xdmattz/kicad-library/3d/t_connectors/MBITR_BATT_CONN_ASM.STEP

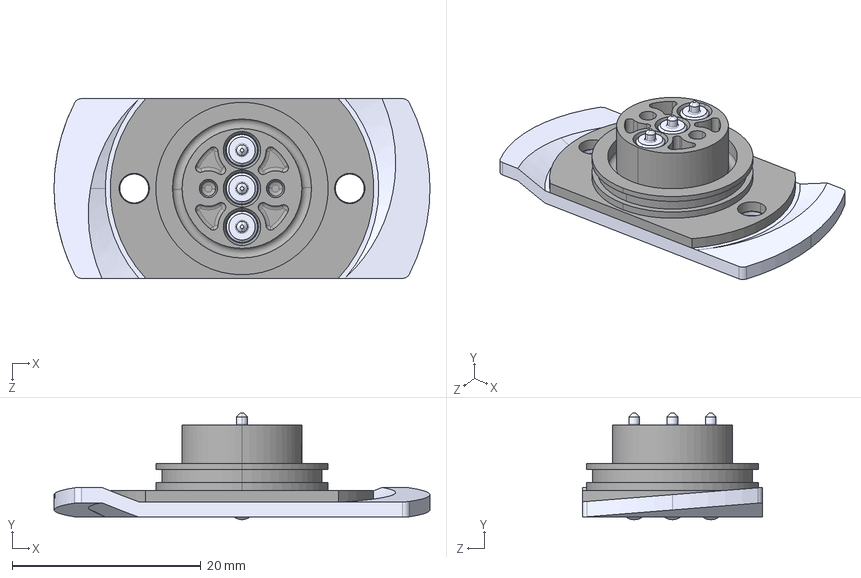
[picture p1: CAD file, 2024-04-17]
3d/t_connectors/MBITR_BATT_CONN_ASM.STEP
39.9 x 11.3 x 19.1 mm
