xdmattz/kicad-library/3d/t_Phoenix/RA_Full_Connector_4.step

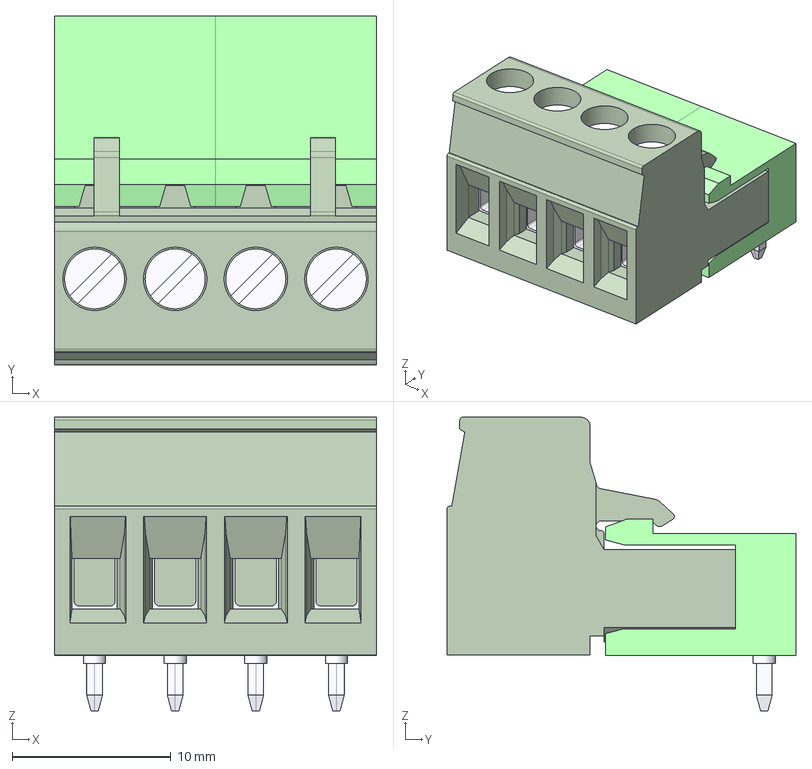
[picture p2: CAD file, 2024-04-17]
3d/t_Phoenix/RA_Full_Connector_4.step
20.3 x 22.0 x 18.5 mm
mstb_2.5-2-g-5
mstb_2.5-2-g-5 (1)
PG145699
