xdmattz/kicad-library/3d/t_BGA/LTM8055Y.STEP

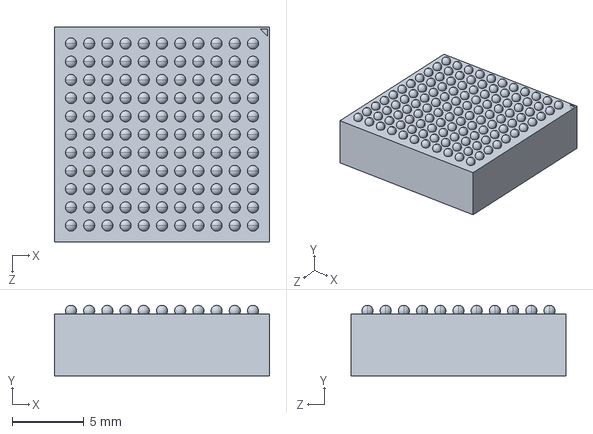
[picture p3: CAD file, 2024-04-17]
3d/t_BGA/LTM8055Y.STEP
15.0 x 4.92 x 15.0 mm
