xdmattz/kicad-library/3d/t_coilcraft/Coilcraft-LPS4414.STEP

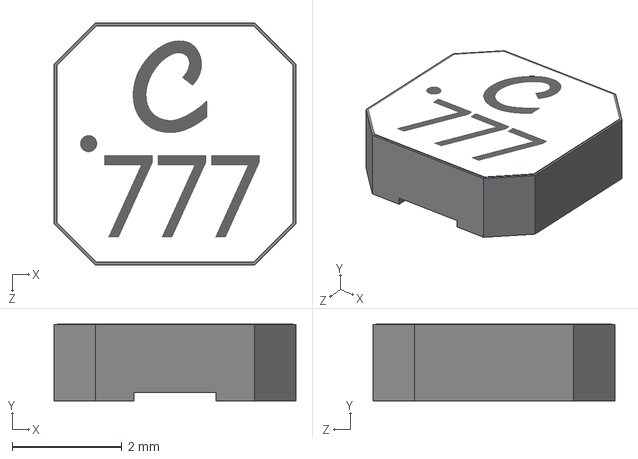
[picture p4: CAD file, 2024-04-17]
3d/t_coilcraft/Coilcraft-LPS4414.STEP
4.40 x 1.40 x 4.40 mm
