xdmattz/kicad-library/3d/t_crystal/7W_TXC.STEP

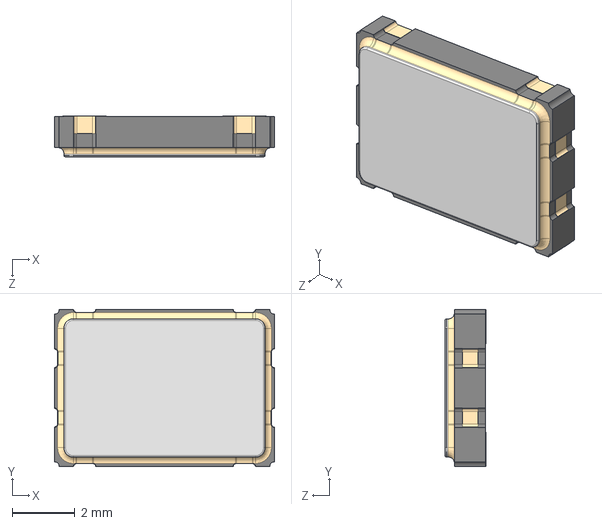
[picture p5: CAD file, 2024-04-17]
3d/t_crystal/7W_TXC.STEP
7.00 x 5.00 x 1.30 mm
