xdmattz/kicad-library/3d/t_Cypress/Cy8CProto_062_4343W Pins.step

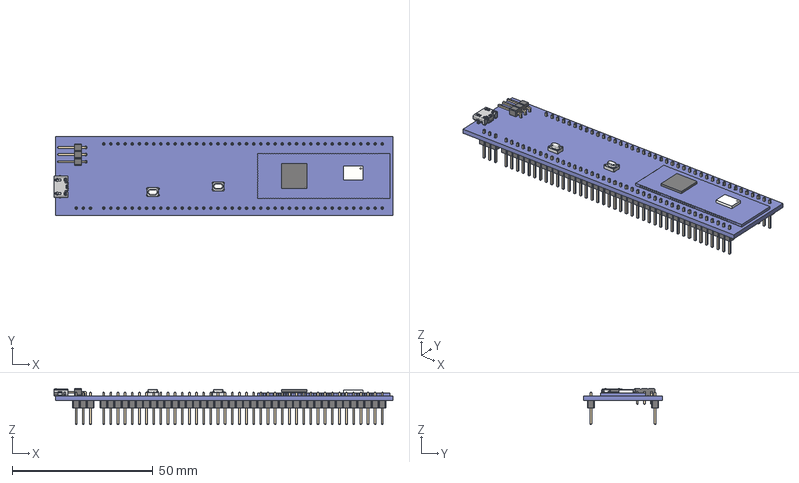
[picture p6: CAD file, 2024-04-17]
3d/t_Cypress/Cy8CProto_062_4343W Pins.step
120.5 x 27.9 x 12.9 mm
Tactile_Switch_3_2x4_2 v2 x 2
