xdmattz/kicad-library/3d/t_dip/MUA08A.stp

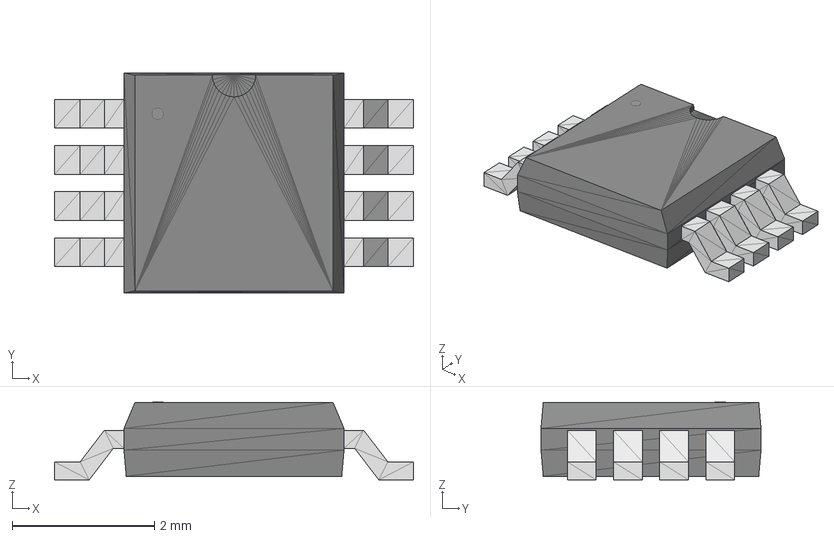
[picture p7: CAD file, 2024-04-17]
3d/t_dip/MUA08A.stp
5.05 x 3.10 x 1.09 mm
