xdmattz/kicad-library/3d/t_do/SMA Package.step

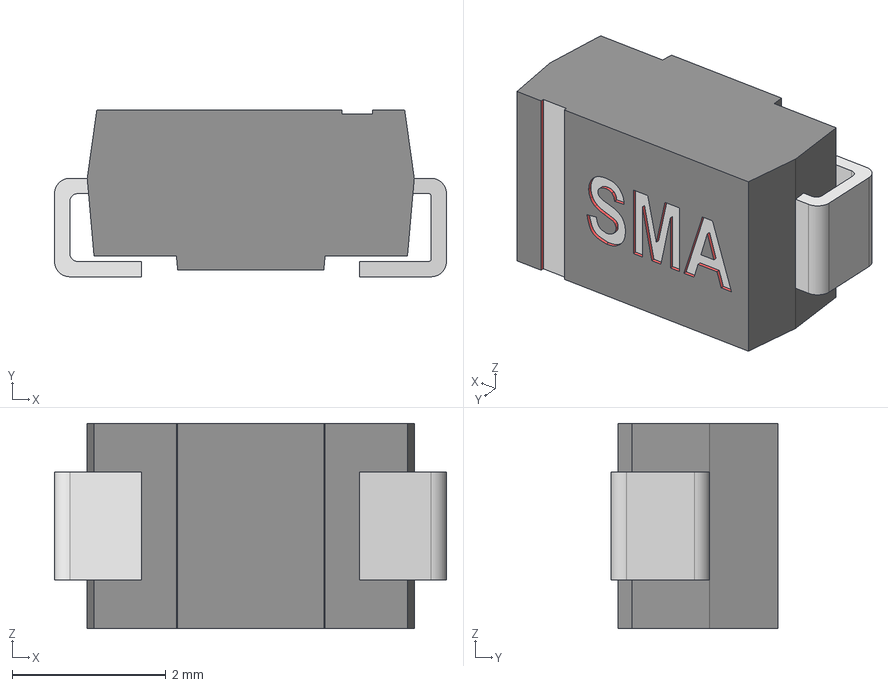
[picture p8: CAD file, 2024-04-17]
3d/t_do/SMA Package.step
5.09 x 2.17 x 2.67 mm
