xdmattz/kicad-library/3d/t_EPC_eGaN/EPC2088 v2.step

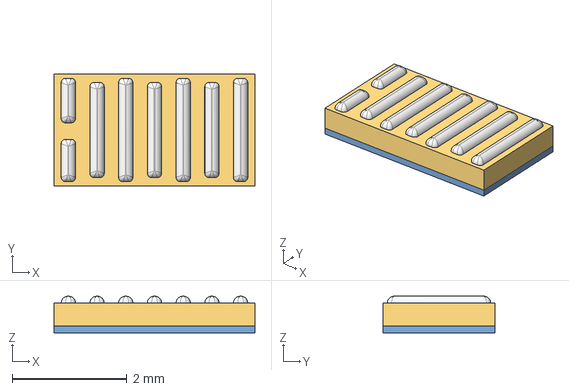
[picture p9: CAD file, 2024-04-17]
3d/t_EPC_eGaN/EPC2088 v2.step
3.50 x 1.95 x 0.638 mm
