xdmattz/kicad-library/3d/t_fuses/PTC_OZCF.step

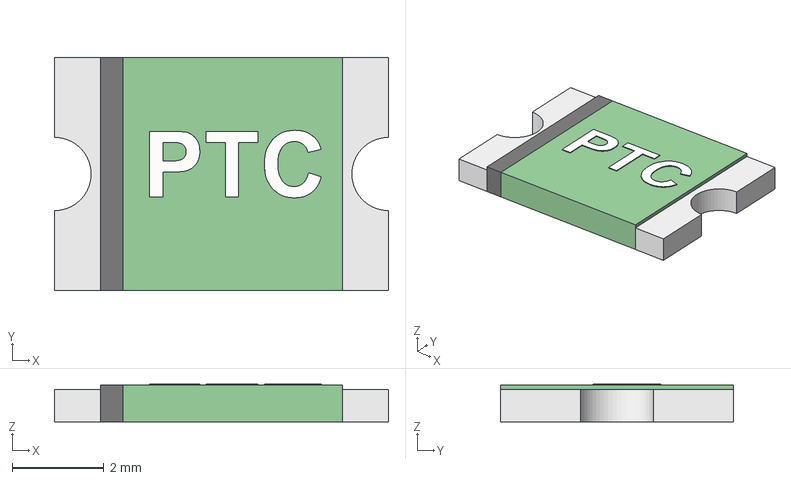
[picture p10: CAD file, 2024-04-17]
3d/t_fuses/PTC_OZCF.step
7.30 x 5.10 x 0.82 mm
