xdmattz/kicad-library/3d/t_header/2.54mm/DS1022-2x2RF11.stp

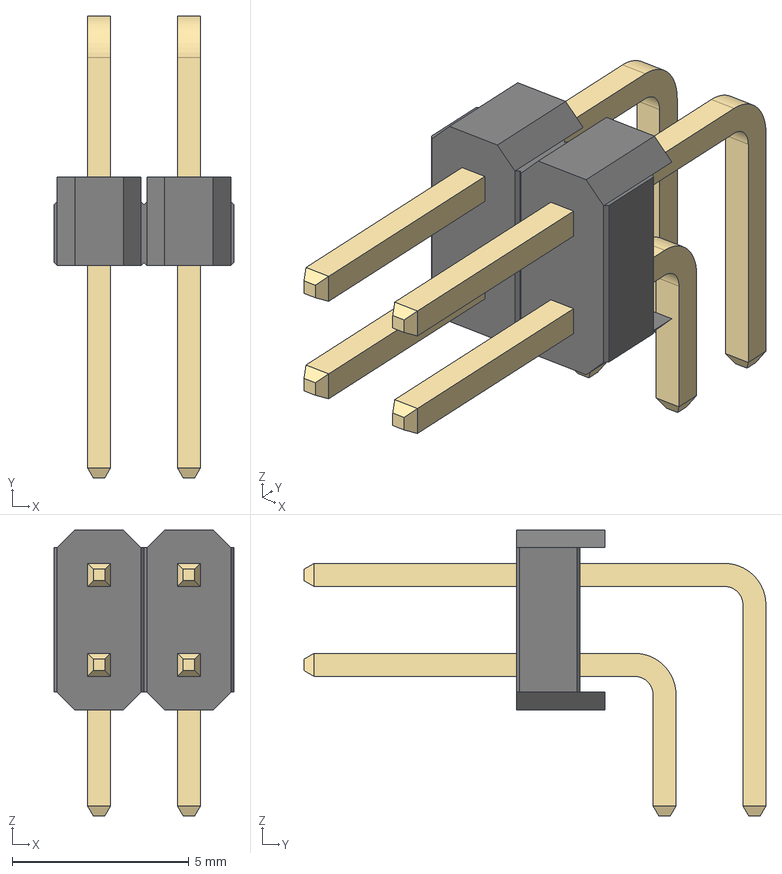
[picture p12: CAD file, 2024-04-17]
3d/t_header/2.54mm/DS1022-2x2RF11.stp
5.08 x 13.1 x 8.08 mm
