xdmattz/kicad-library/3d/t_passive_smd/CP_EIA-7343-31_Kemet-D.step

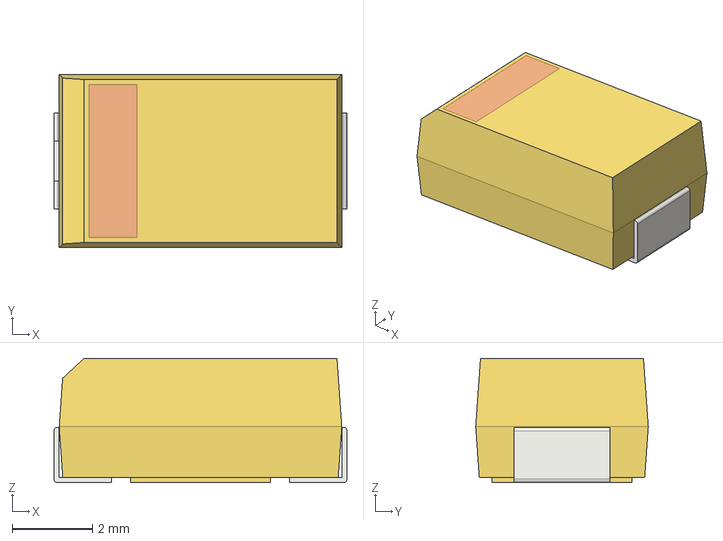
[picture p13: CAD file, 2024-04-17]
3d/t_passive_smd/CP_EIA-7343-31_Kemet-D.step
7.30 x 4.30 x 3.10 mm
