xdmattz/kicad-library/3d/t_passive_thd/RES-1W-HH-MO.stp

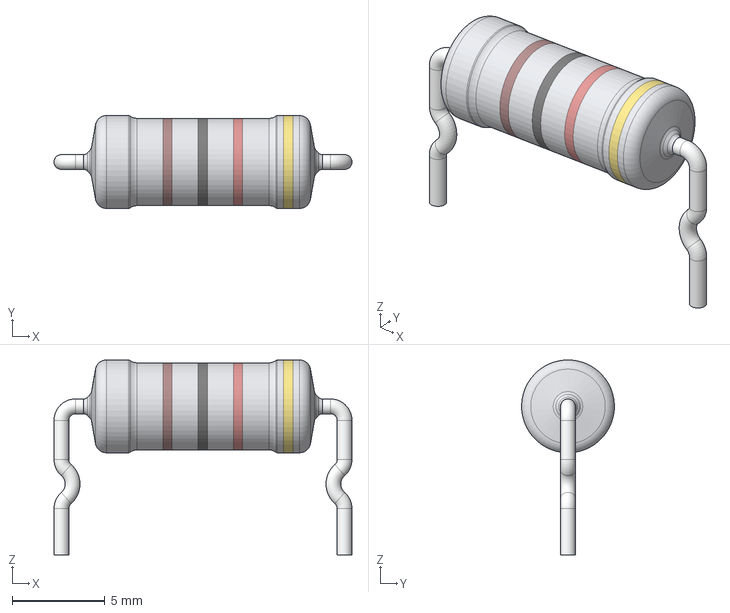
[picture p14: CAD file, 2024-04-17]
3d/t_passive_thd/RES-1W-HH-MO.stp
16.0 x 5.00 x 10.5 mm
