xdmattz/kicad-library/3d/t_Phoenix/Terminal Block Vert_Socket_4.step

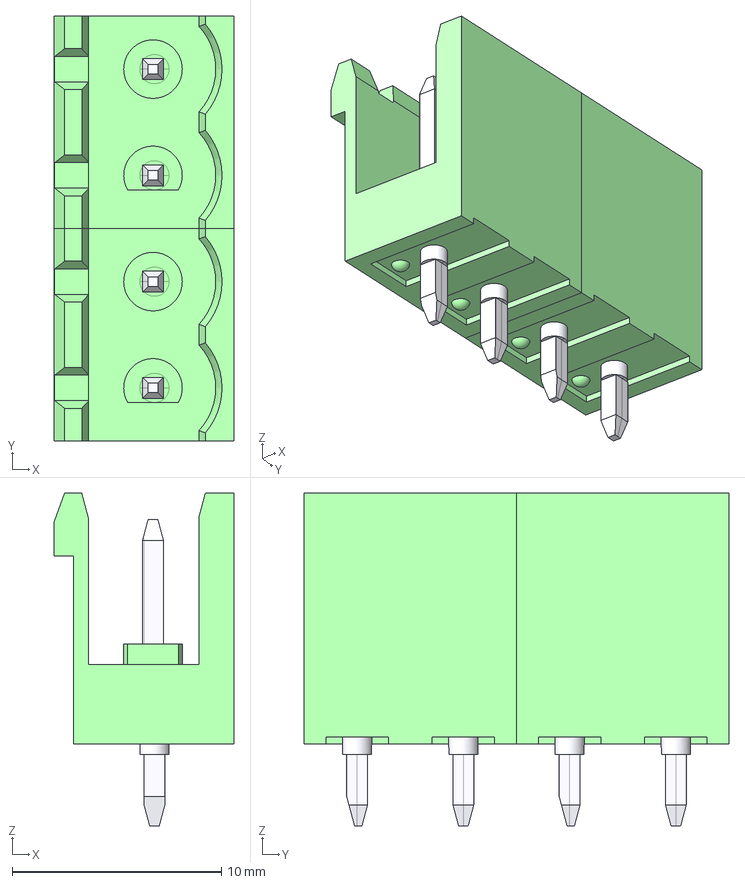
[picture p15: CAD file, 2024-04-17]
3d/t_Phoenix/Terminal Block Vert_Socket_4.step
8.60 x 20.3 x 15.9 mm
mstbv_2.5-2-g-5
mstbv_2.5-2-g-5 (1)
