xdmattz/kicad-library/3d/t_Pot/Pot_B10K_Horiz.step

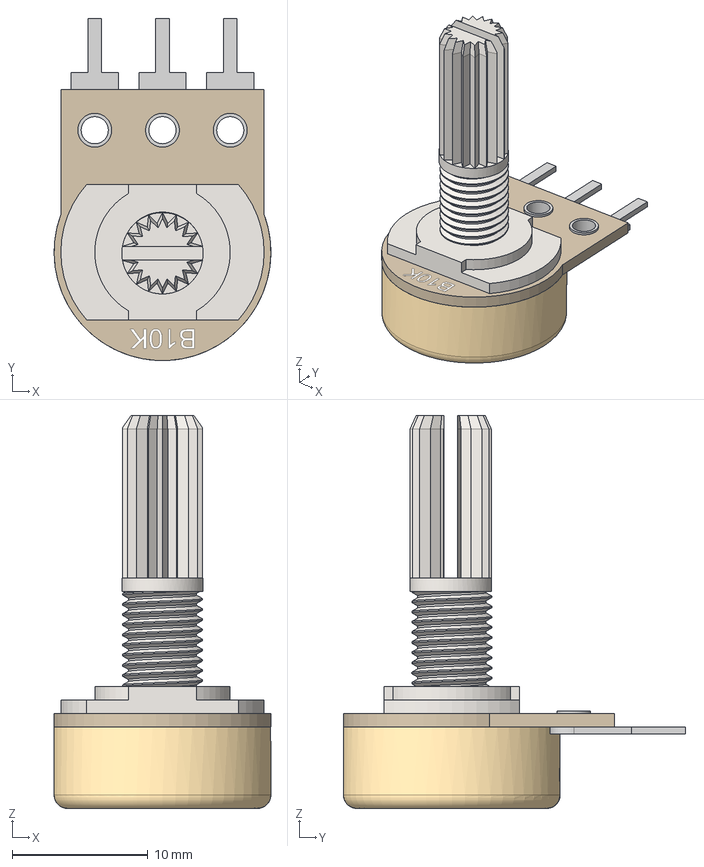
[picture p16: CAD file, 2024-04-17]
3d/t_Pot/Pot_B10K_Horiz.step
16.0 x 25.3 x 29.0 mm
Shaft
ScrewBase
Board
Pin1
Pin2
Pin3
Casing
