xdmattz/kicad-library/3d/t_qfn/CP_32_11_ADI.step

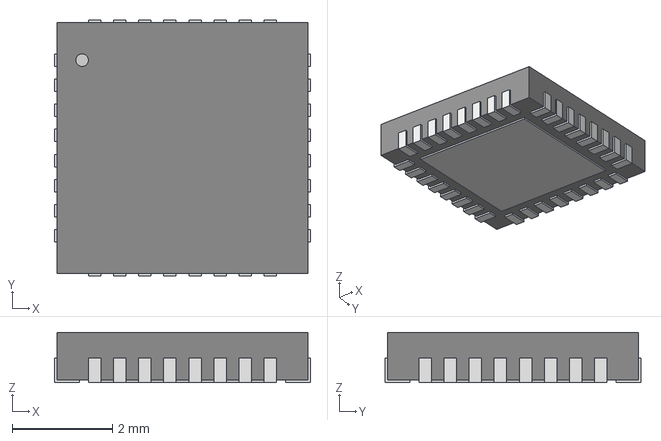
[picture p17: CAD file, 2024-04-17]
3d/t_qfn/CP_32_11_ADI.step
5.10 x 5.10 x 1.00 mm
