xdmattz/kicad-library/3d/t_Relay/OACM-UJ v3.step

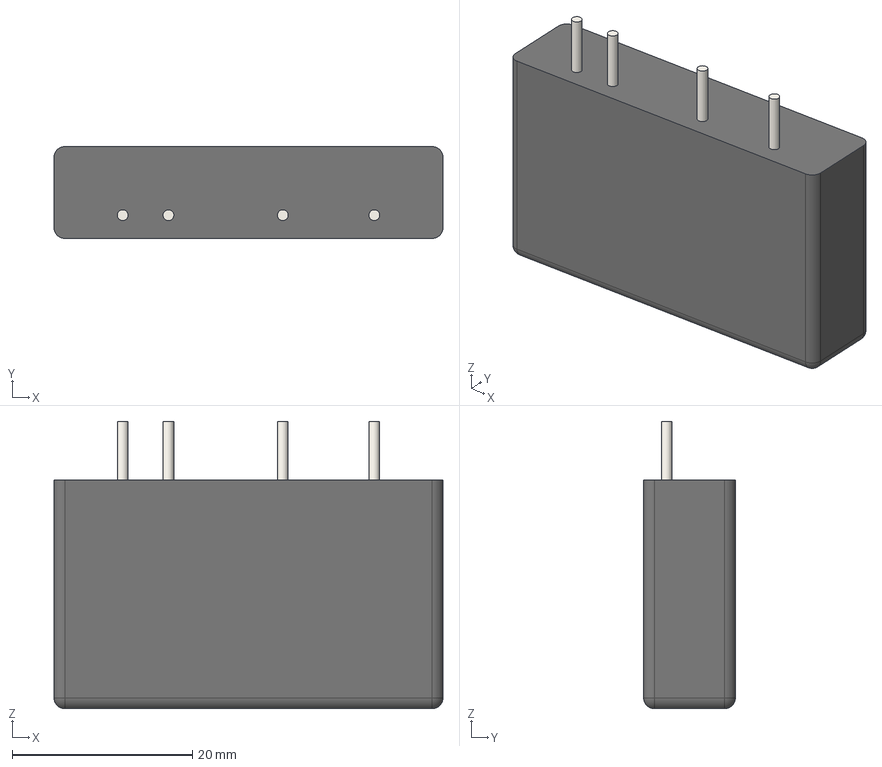
[picture p18: CAD file, 2024-04-17]
3d/t_Relay/OACM-UJ v3.step
43.2 x 10.2 x 31.9 mm
