xdmattz/kicad-library/3d/t_RF_amps/WW107 v4.stp

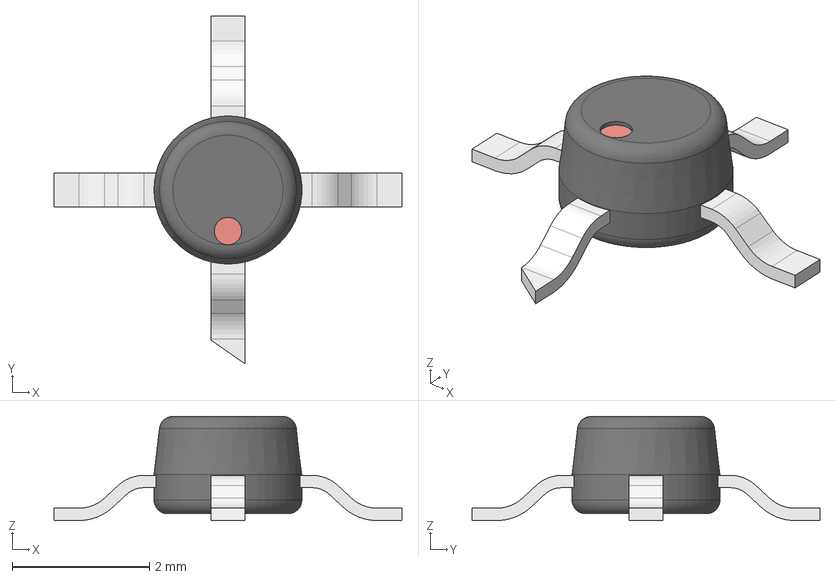
[picture p19: CAD file, 2024-04-17]
3d/t_RF_amps/WW107 v4.stp
5.08 x 5.08 x 1.52 mm
