xdmattz/kicad-library/3d/t_RF_conn/c-5-1814832-2-c-3d.stp

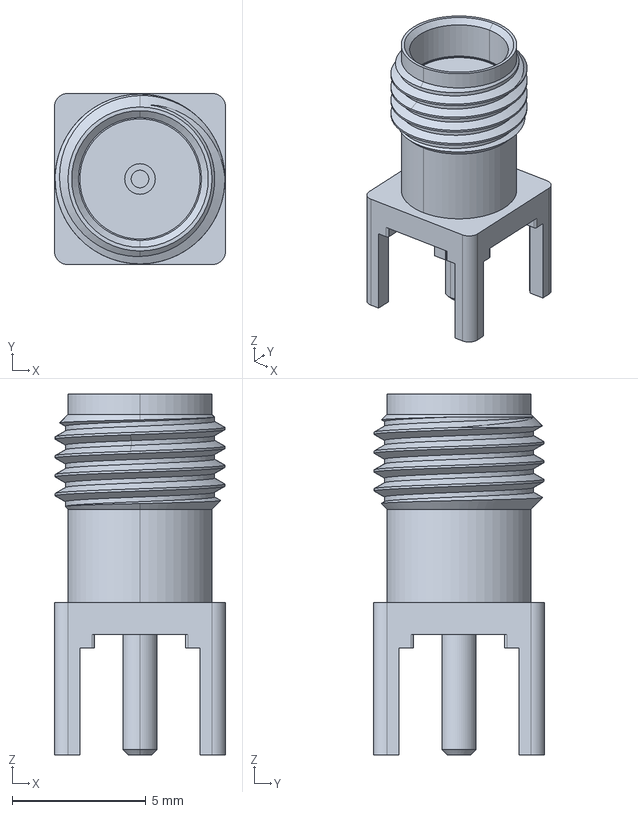
[picture p20: CAD file, 2024-04-17]
3d/t_RF_conn/c-5-1814832-2-c-3d.stp
6.40 x 6.40 x 13.5 mm
