xdmattz/kicad-library/3d/t_RF_misc/PAT1220.stp

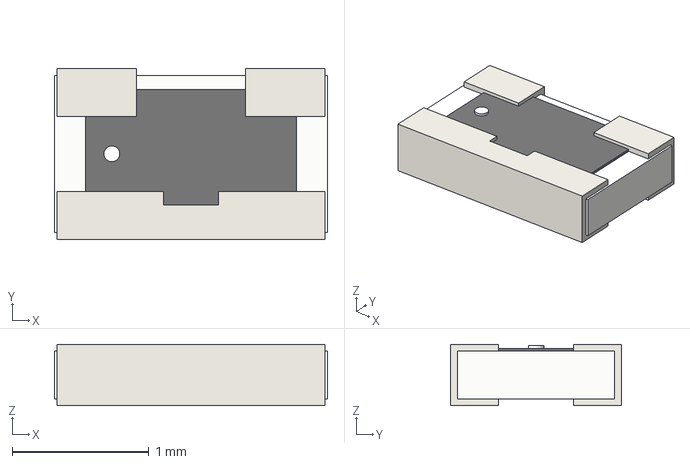
[picture p21: CAD file, 2024-04-17]
3d/t_RF_misc/PAT1220.stp
2.00 x 1.25 x 0.45 mm
