xdmattz/kicad-library/3d/t_Samtec/SSW-103-01-F-D.stp

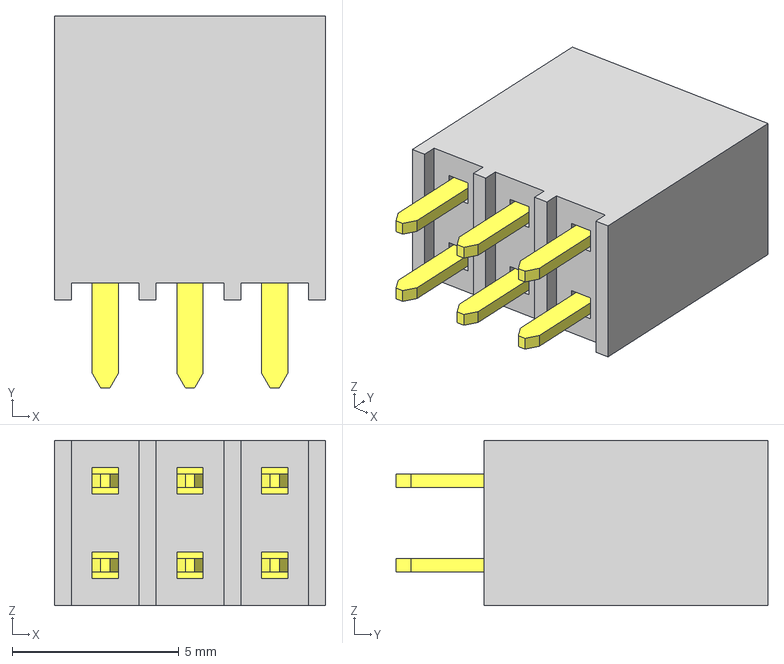
[picture p22: CAD file, 2024-04-17]
3d/t_Samtec/SSW-103-01-F-D.stp
8.13 x 11.2 x 4.95 mm
_SSW-103-01-F-D_terminal
_SSW-103-01-F-D_pin
