xdmattz/kicad-library/3d/t_smd_caps/CP_Elec_5x5.8.step

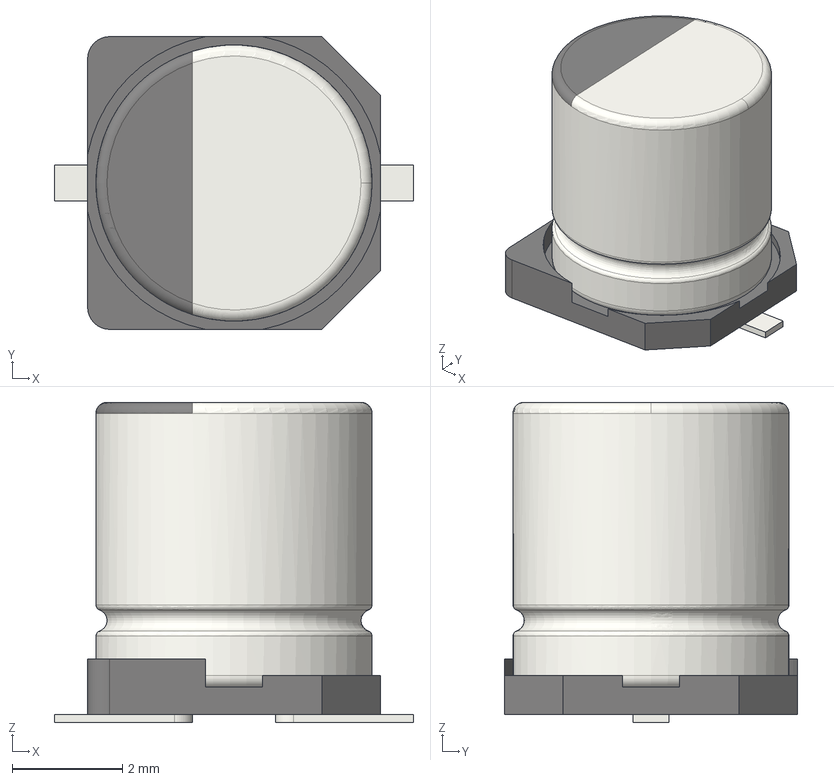
[picture p23: CAD file, 2024-04-17]
3d/t_smd_caps/CP_Elec_5x5.8.step
6.50 x 5.30 x 5.80 mm
