xdmattz/kicad-library/3d/t_smd_inductors/STEP-WE-PD-1280-rev1.stp

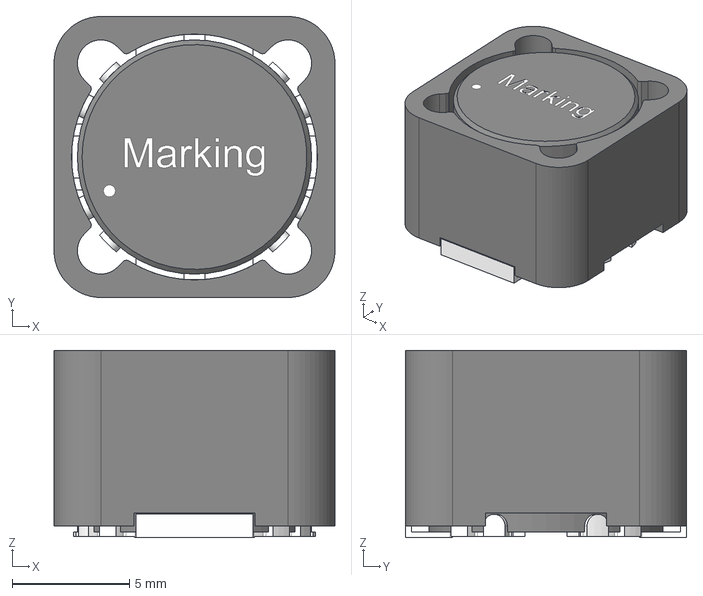
[picture p24: CAD file, 2024-04-17]
3d/t_smd_inductors/STEP-WE-PD-1280-rev1.stp
12.0 x 12.0 x 8.00 mm
