xdmattz/kicad-library/3d/t_smd_transistors/TDFN-8-EP_3x3mm.stp

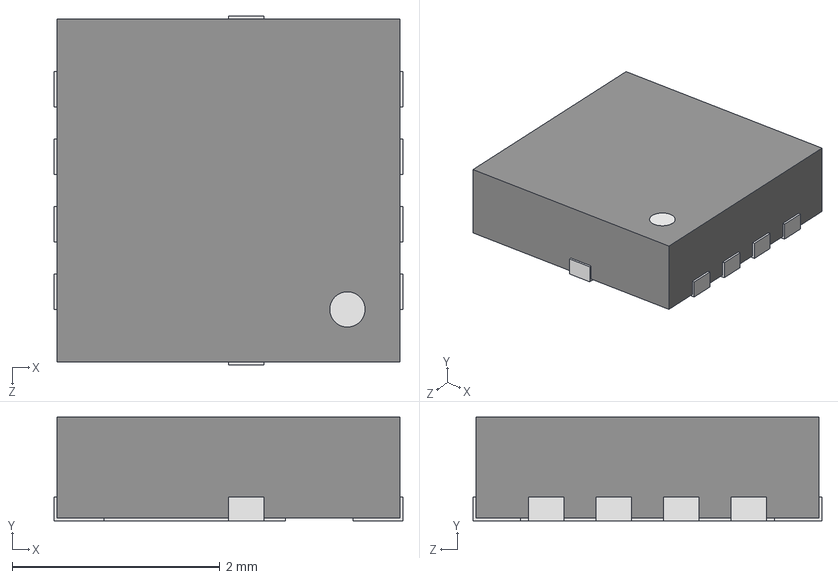
[picture p25: CAD file, 2024-04-17]
3d/t_smd_transistors/TDFN-8-EP_3x3mm.stp
3.36 x 1.00 x 3.36 mm
