xdmattz/kicad-library/3d/t_so/SOIC-16-3_9mm.step

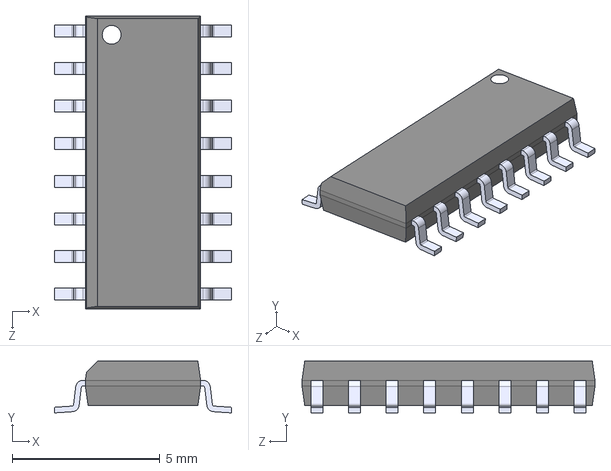
[picture p26: CAD file, 2024-04-17]
3d/t_so/SOIC-16-3_9mm.step
5.99 x 1.75 x 9.91 mm
