xdmattz/kicad-library/3d/t_sot/SOT-223.stp

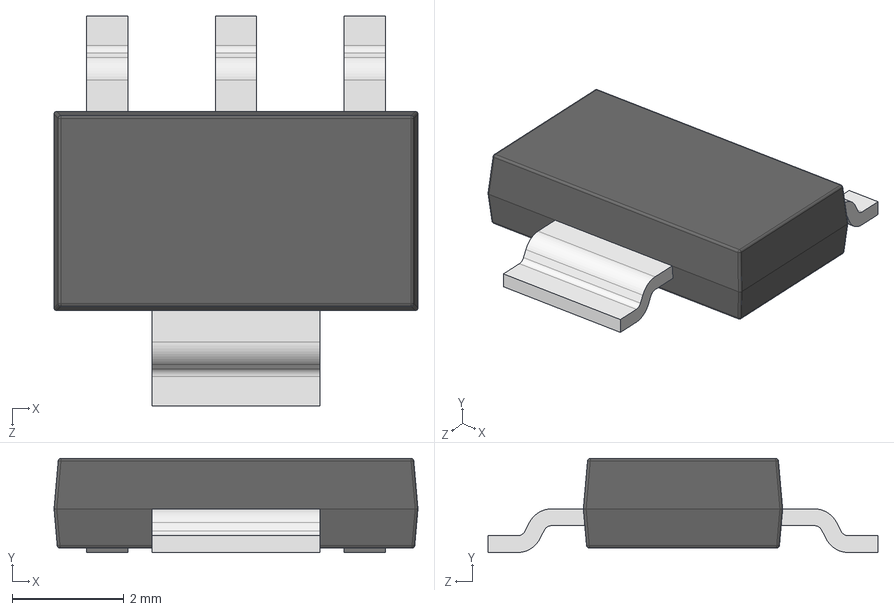
[picture p27: CAD file, 2024-04-17]
3d/t_sot/SOT-223.stp
6.50 x 1.68 x 6.96 mm
