xdmattz/kicad-library/3d/t_to/TO-247_vertical_line.stp

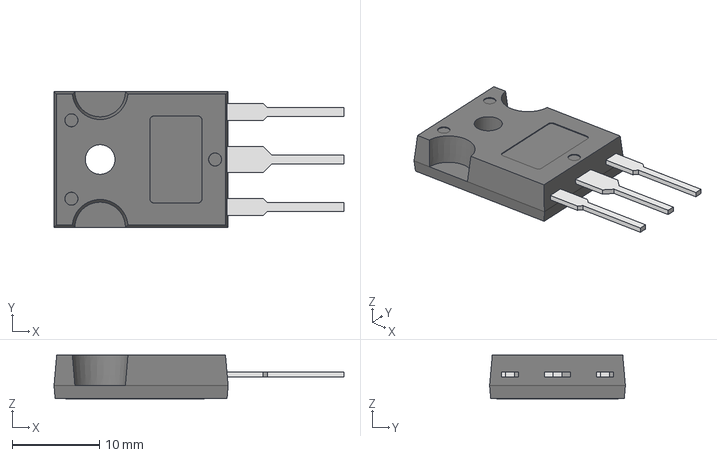
[picture p28: CAD file, 2024-04-17]
3d/t_to/TO-247_vertical_line.stp
33.3 x 15.6 x 5.00 mm
