xdmattz/kicad-library/3d/t_txfmr/PH9572.XXXNL.STEP

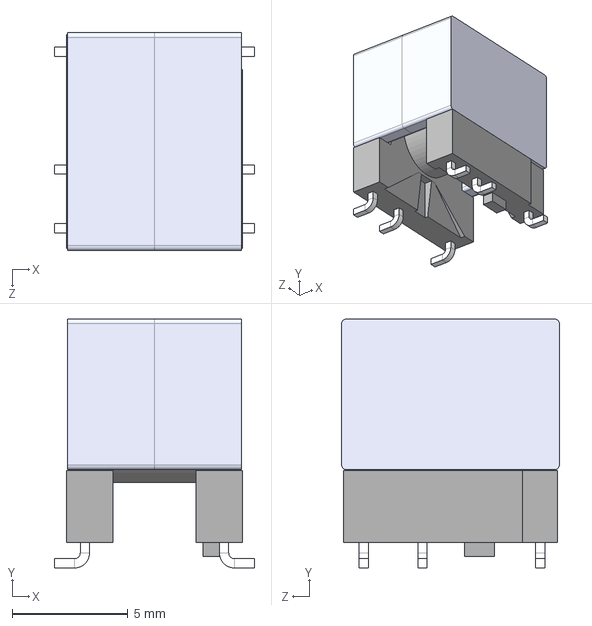
[picture p29: CAD file, 2024-04-17]
3d/t_txfmr/PH9572.XXXNL.STEP
8.65 x 10.8 x 9.40 mm
042-2297.004 SML 6P
032-3281.XXX EP7CORE_Part Number x 2
