xdmattz/kicad-library/3d/t_BGA/YFP-8_A.stp

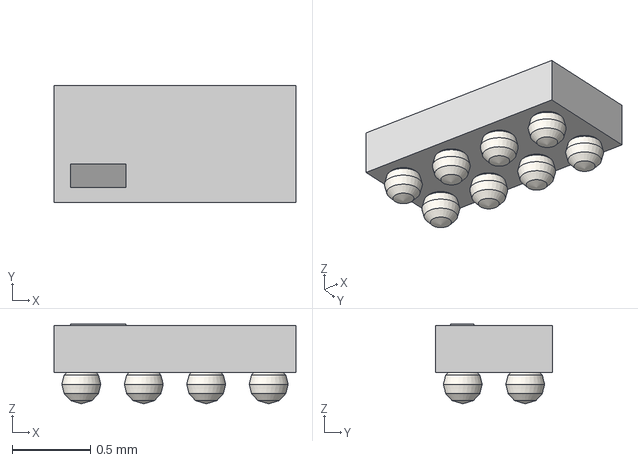
[picture p30: CAD file, 2024-04-17]
3d/t_BGA/YFP-8_A.stp
1.55 x 0.75 x 0.51 mm
