xdmattz/kicad-library/3d/t_coilcraft/Coilcraft-0807SQ-6N9.stp

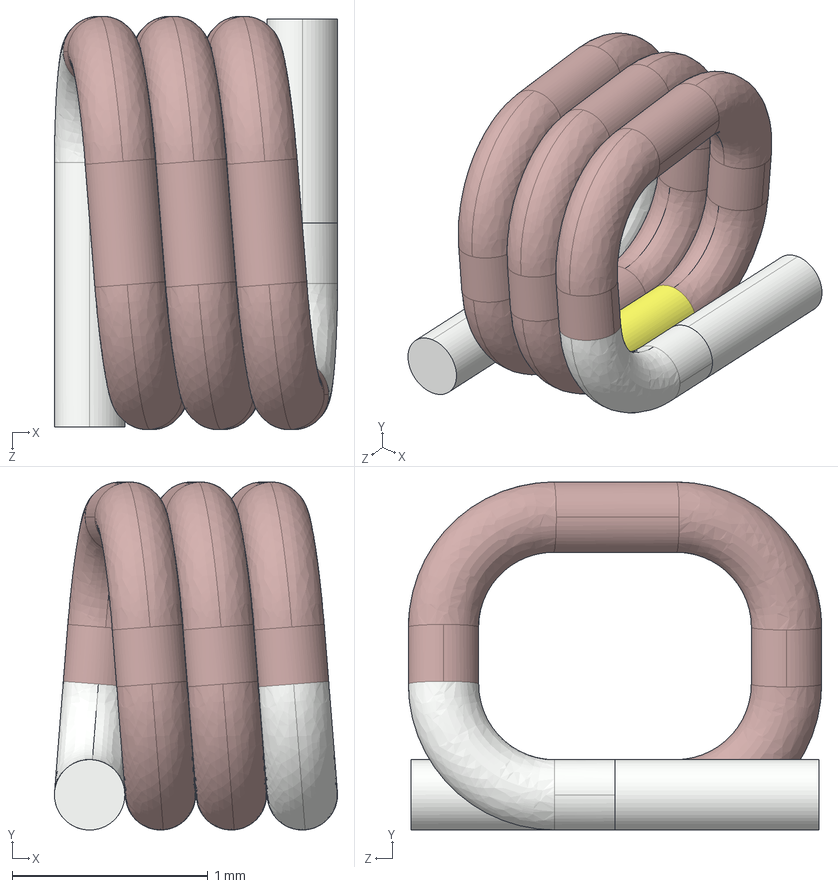
[picture p31: CAD file, 2024-04-17]
3d/t_coilcraft/Coilcraft-0807SQ-6N9.stp
1.45 x 1.78 x 2.11 mm
