xdmattz/kicad-library/3d/t_connectors/SSM-103-F-DV-LC.stp

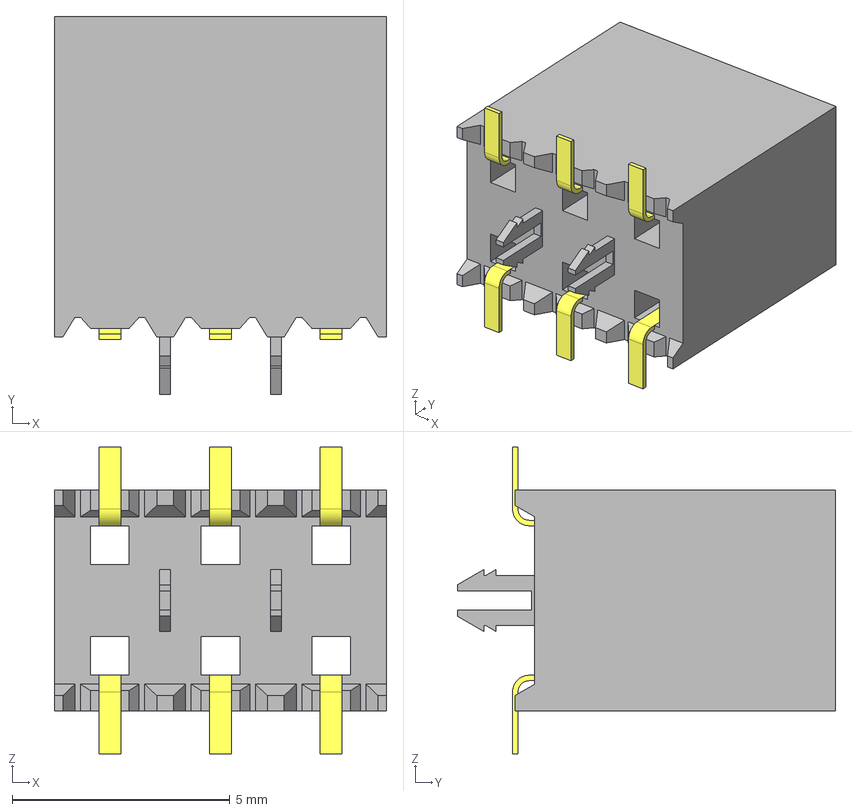
[picture p32: CAD file, 2024-04-17]
3d/t_connectors/SSM-103-F-DV-LC.stp
7.62 x 8.69 x 7.04 mm
_SSM-103-F-DV-LC_body
_C-137-013
