xdmattz/kicad-library/3d/t_crystal/UM-1 Crystal.step

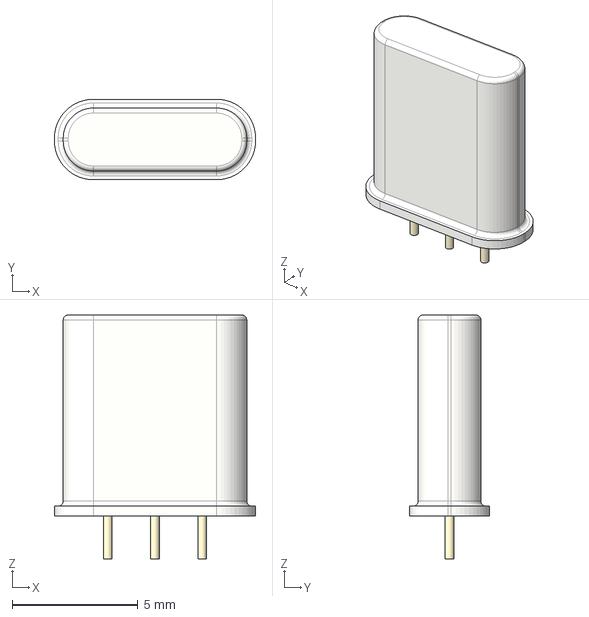
[picture p33: CAD file, 2024-04-17]
3d/t_crystal/UM-1 Crystal.step
8.00 x 3.20 x 9.70 mm
