xdmattz/kicad-library/3d/t_dip/MSOP-16.step

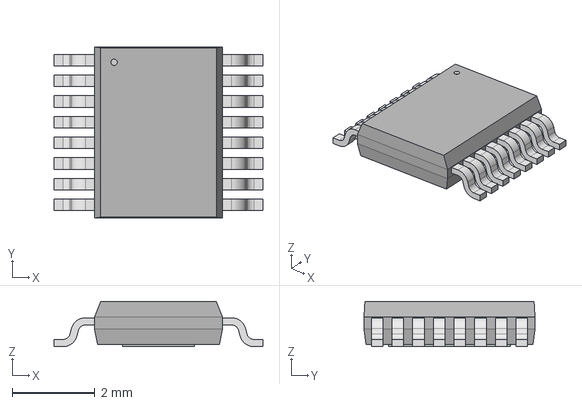
[picture p35: CAD file, 2024-04-17]
3d/t_dip/MSOP-16.step
5.05 x 4.14 x 1.09 mm
