xdmattz/kicad-library/3d/t_do/DO-214AC(SMA).step

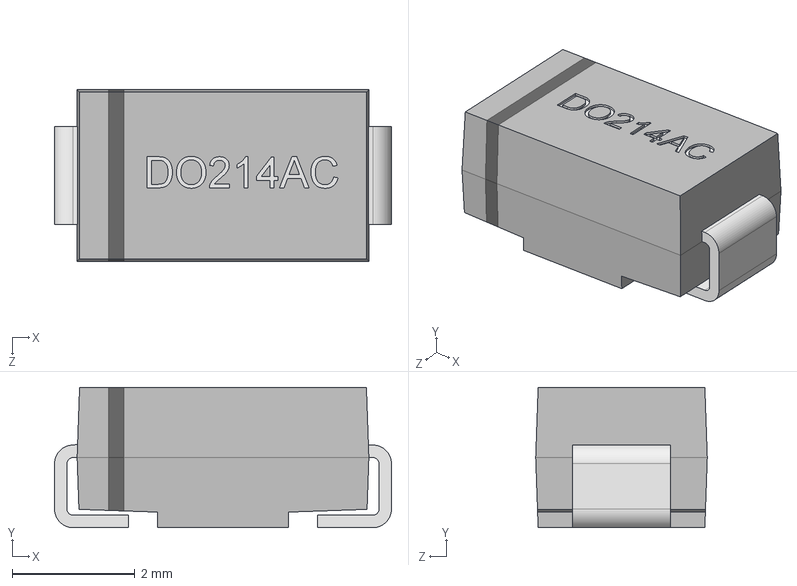
[picture p36: CAD file, 2024-04-17]
3d/t_do/DO-214AC(SMA).step
5.49 x 2.29 x 2.79 mm
