xdmattz/kicad-library/3d/t_fuses/keystone-PN3568.STEP

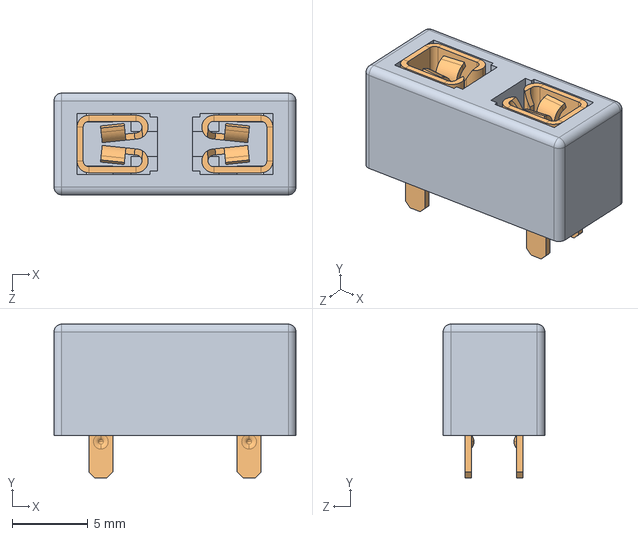
[picture p37: CAD file, 2024-04-17]
3d/t_fuses/keystone-PN3568.STEP
16.0 x 10.2 x 6.73 mm
F3568-1
3557_rev.C x 2
