xdmattz/kicad-library/3d/t_header/1.27mm/DS1031-01-1x3P8BV3-1.stp

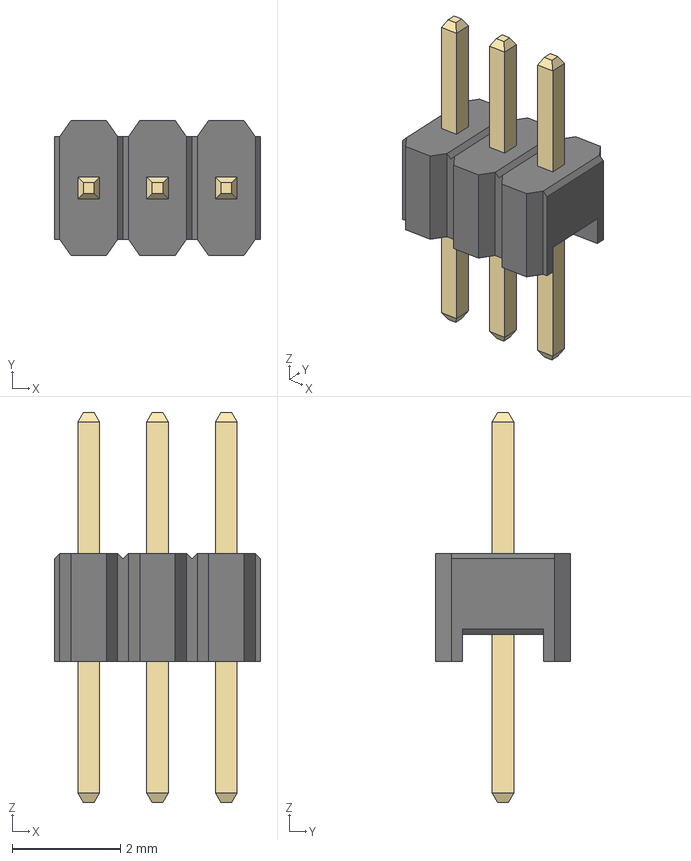
[picture p38: CAD file, 2024-04-17]
3d/t_header/1.27mm/DS1031-01-1x3P8BV3-1.stp
3.81 x 2.50 x 7.20 mm
