xdmattz/kicad-library/3d/t_header/2.54mm/DS1022-2x6R61.stp

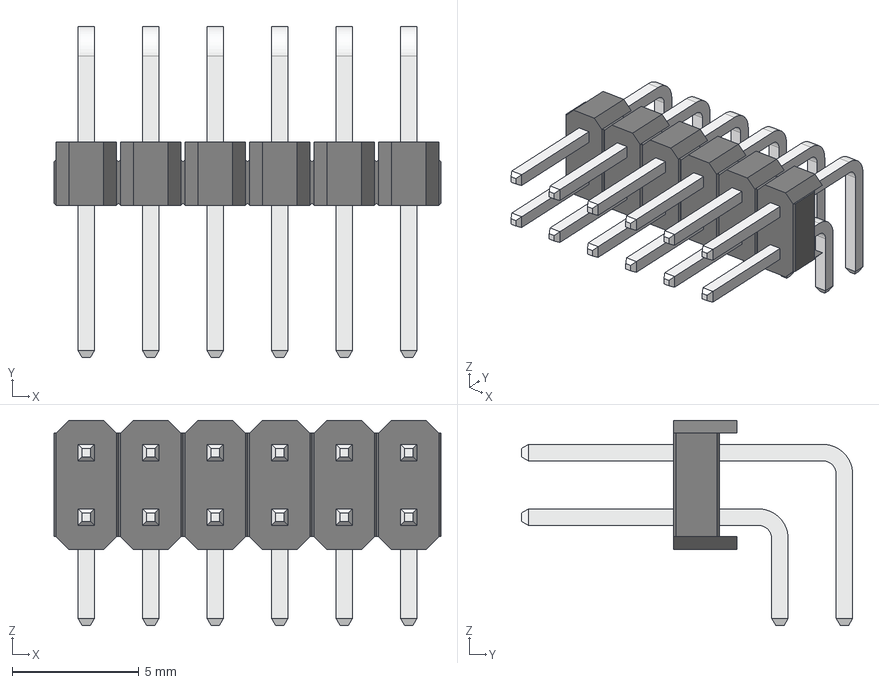
[picture p39: CAD file, 2024-04-17]
3d/t_header/2.54mm/DS1022-2x6R61.stp
15.2 x 13.1 x 8.08 mm
