xdmattz/kicad-library/3d/t_Mech_Switch/PEC16-4X20F-SXXXX.stp

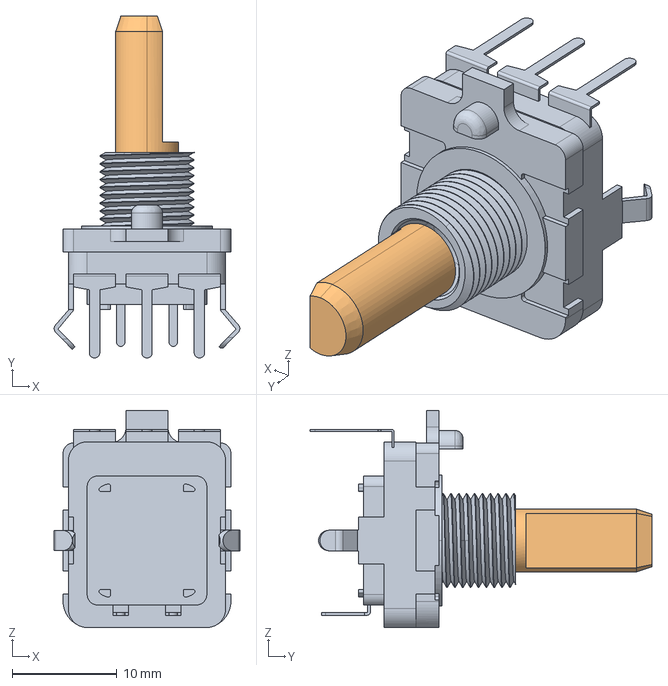
[picture p40: CAD file, 2024-04-17]
3d/t_Mech_Switch/PEC16-4X20F-SXXXX.stp
17.7 x 32.6 x 20.7 mm
