xdmattz/kicad-library/3d/t_passive_smd/CAPAE-D4.0x5.4.stp

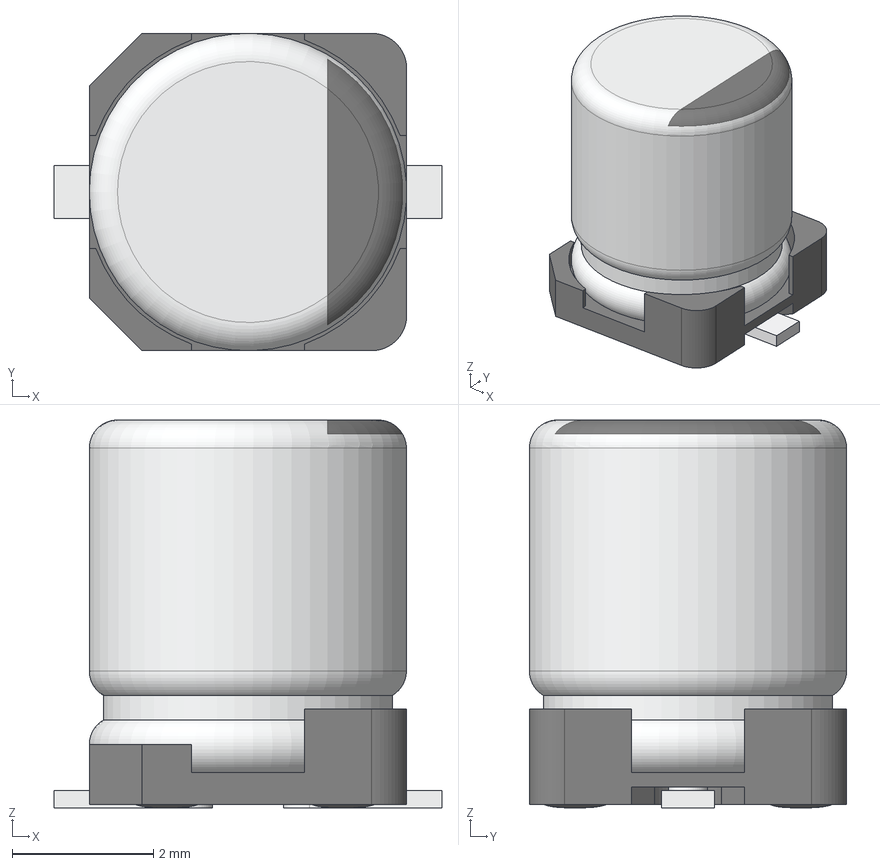
[picture p41: CAD file, 2024-04-17]
3d/t_passive_smd/CAPAE-D4.0x5.4.stp
5.50 x 4.50 x 5.50 mm
