xdmattz/kicad-library/3d/t_passive_thd/CAP_RAD_D10x12.5_POL_BK.stp

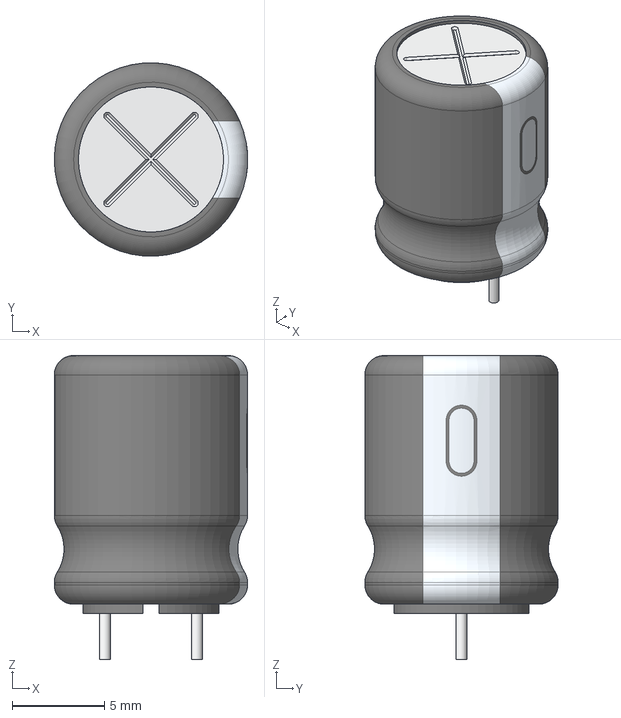
[picture p42: CAD file, 2024-04-17]
3d/t_passive_thd/CAP_RAD_D10x12.5_POL_BK.stp
10.5 x 10.5 x 16.5 mm
