xdmattz/kicad-library/3d/t_Phoenix/Terminal_Block_Vert_Top_2.step

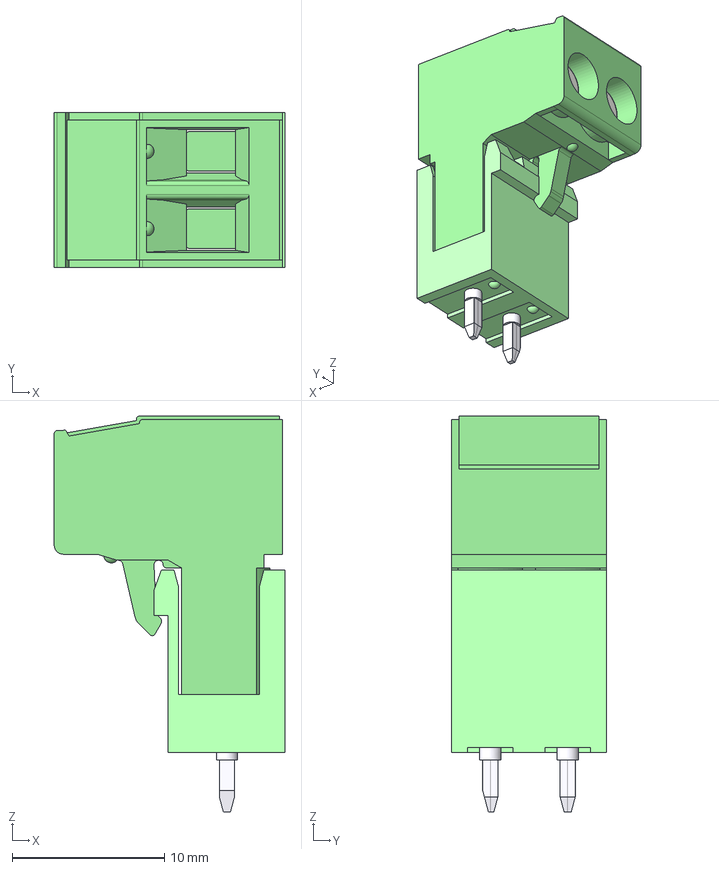
[picture p43: CAD file, 2024-04-17]
3d/t_Phoenix/Terminal_Block_Vert_Top_2.step
15.1 x 10.2 x 26.0 mm
mstbv_2.5-2-g-5
MSTB-2.5-Clamp-sleeve x 2
MSTB-2
