xdmattz/kicad-library/3d/t_Pot/PotentiometerB10K.step

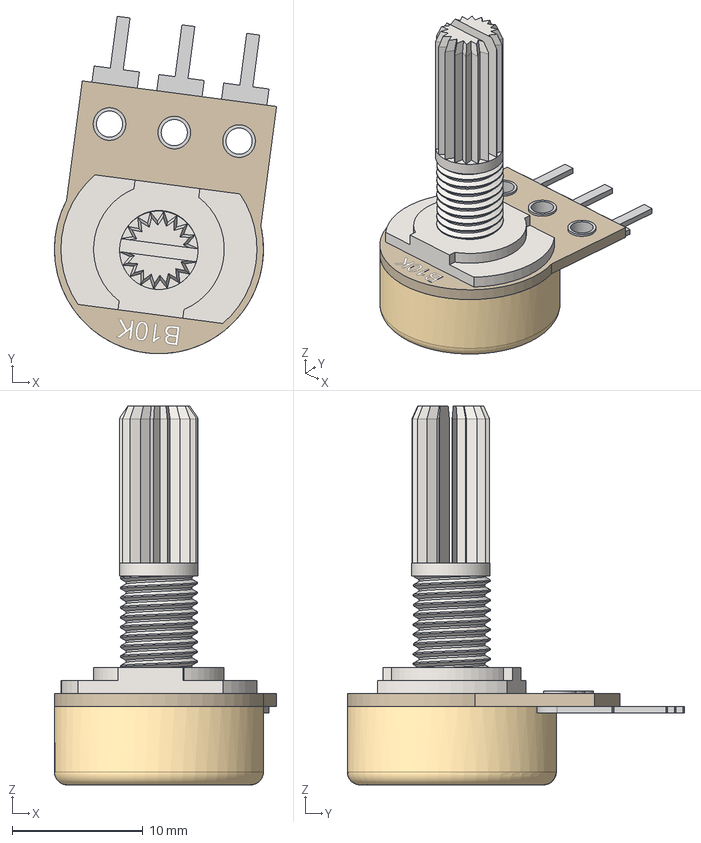
[picture p44: CAD file, 2024-04-17]
3d/t_Pot/PotentiometerB10K.step
17.0 x 25.8 x 29.0 mm
Shaft
ScrewBase
Board
Pin1
Pin2
Pin3
Casing
