xdmattz/kicad-library/3d/t_qfn/DFN-10.STEP

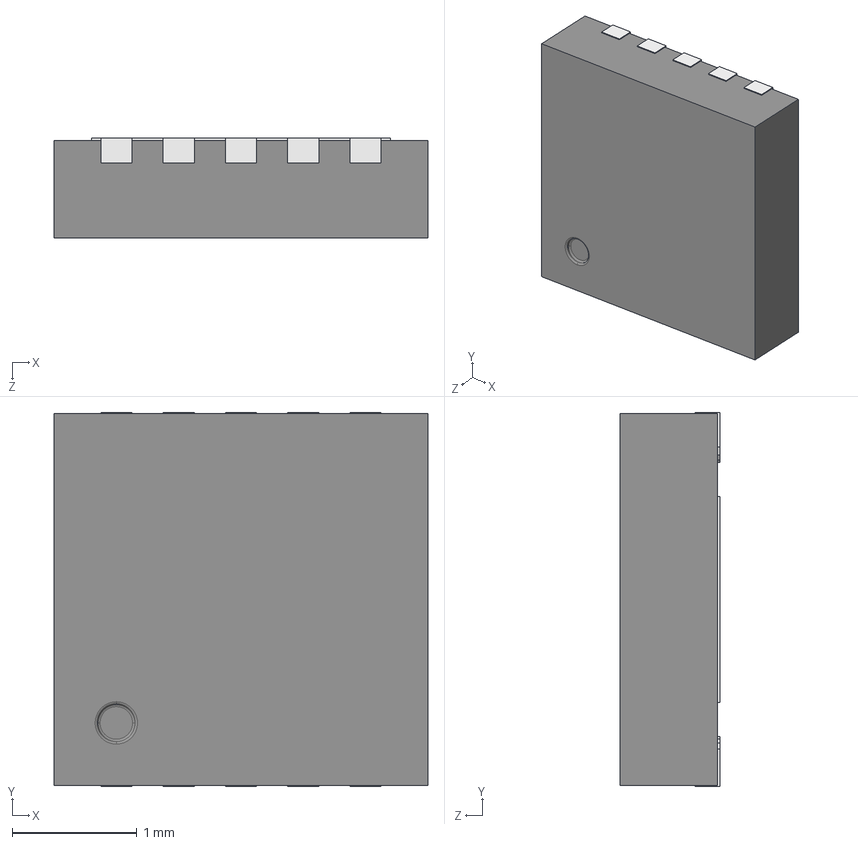
[picture p45: CAD file, 2024-04-17]
3d/t_qfn/DFN-10.STEP
3.00 x 3.00 x 0.8 mm
User Library-DFN-10_Fusion
User Library-DFN-10_Fillet
User Library-DFN-10_DFN_10011
