xdmattz/kicad-library/3d/t_Relay/CPC1966Y v2.step

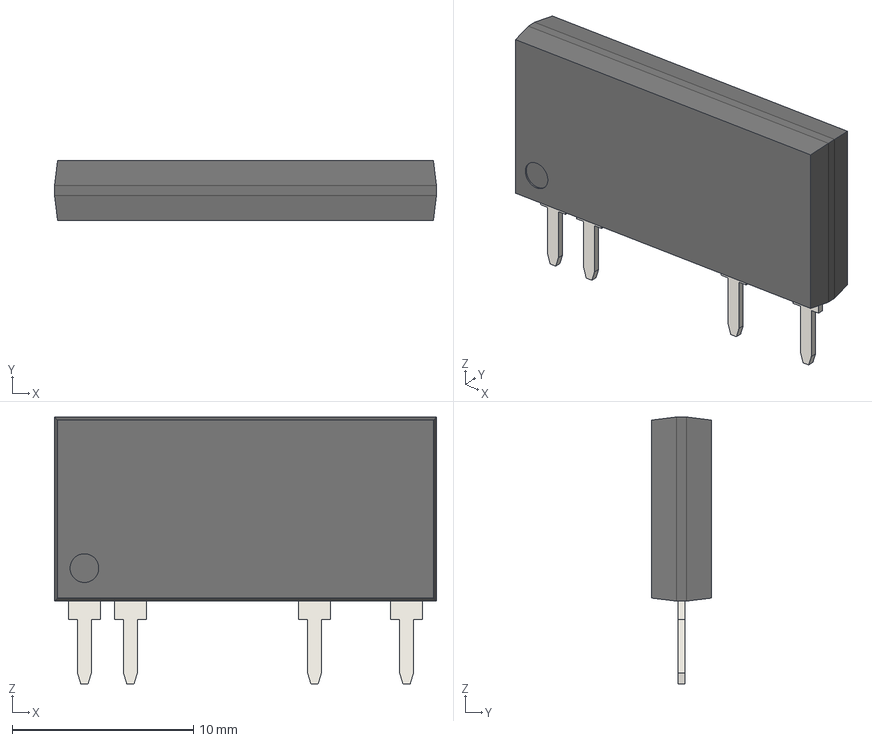
[picture p46: CAD file, 2024-04-17]
3d/t_Relay/CPC1966Y v2.step
21.1 x 3.32 x 14.7 mm
Pins x 4
