xdmattz/kicad-library/3d/t_RF_conn/U.FL-R-SMT-1.stp

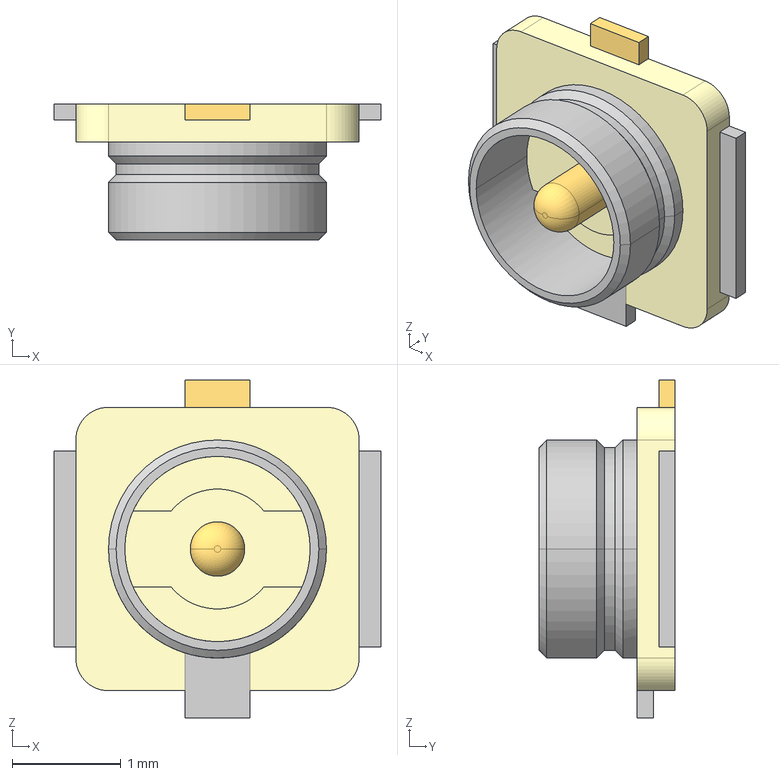
[picture p47: CAD file, 2024-04-17]
3d/t_RF_conn/U.FL-R-SMT-1.stp
3.00 x 1.25 x 3.10 mm
