xdmattz/kicad-library/3d/t_RF_misc/DEA-4_2P5X2P0.stp

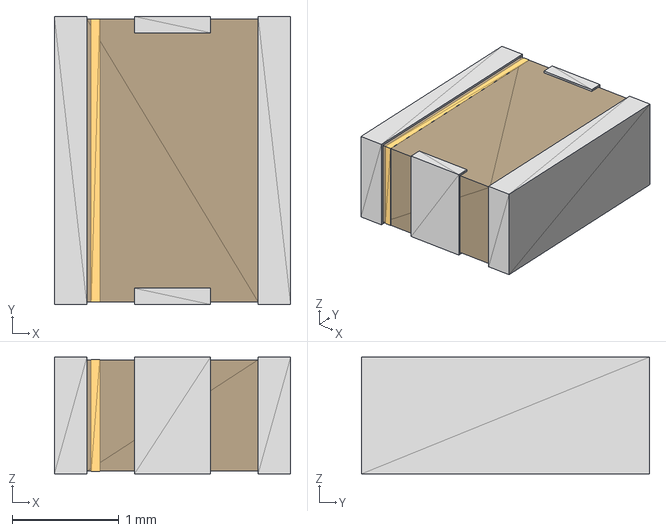
[picture p48: CAD file, 2024-04-17]
3d/t_RF_misc/DEA-4_2P5X2P0.stp
2.21 x 2.69 x 1.09 mm
