xdmattz/kicad-library/3d/t_Samtec/CLP-106-02-F-D.stp

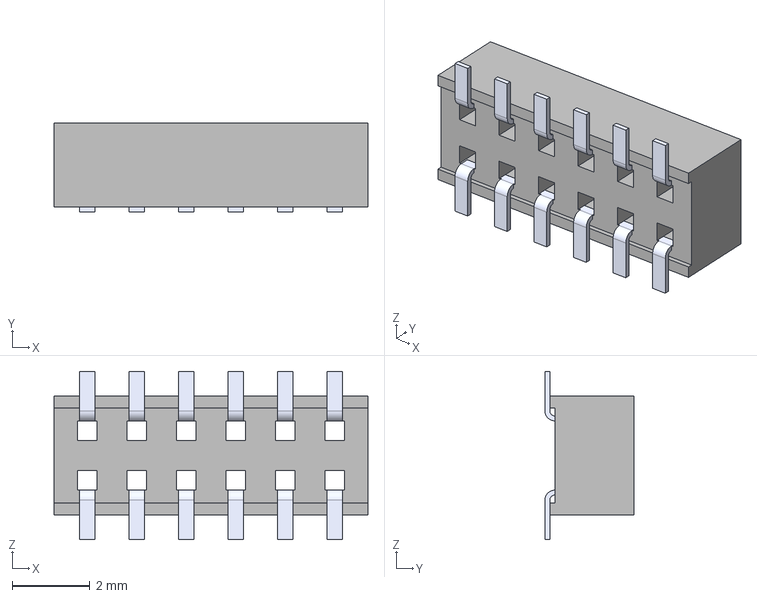
[picture p49: CAD file, 2024-04-17]
3d/t_Samtec/CLP-106-02-F-D.stp
8.05 x 2.29 x 4.32 mm
_CLP-106-2-F-D_terminal
_C-106-22-106_Pin x 2
