xdmattz/kicad-library/3d/t_smd_caps/CP_EIA-3216-18_Kemet-A.step

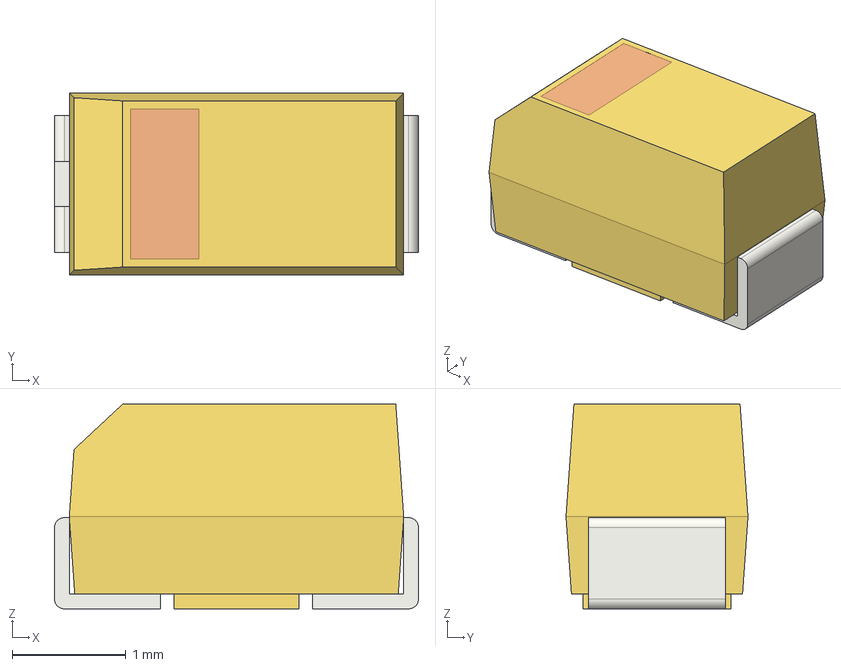
[picture p50: CAD file, 2024-04-17]
3d/t_smd_caps/CP_EIA-3216-18_Kemet-A.step
3.20 x 1.60 x 1.80 mm
