xdmattz/kicad-library/3d/t_smd_inductors/Q3_THRU.step

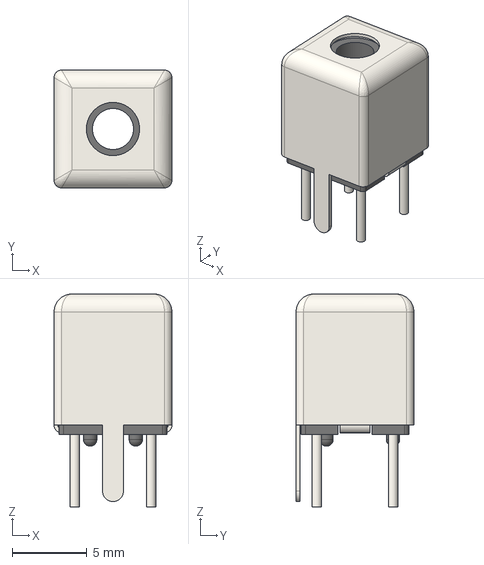
[picture p51: CAD file, 2024-04-17]
3d/t_smd_inductors/Q3_THRU.step
7.87 x 7.87 x 14.2 mm
