xdmattz/kicad-library/3d/t_so/SOP-4L_TC_VIS-M.step

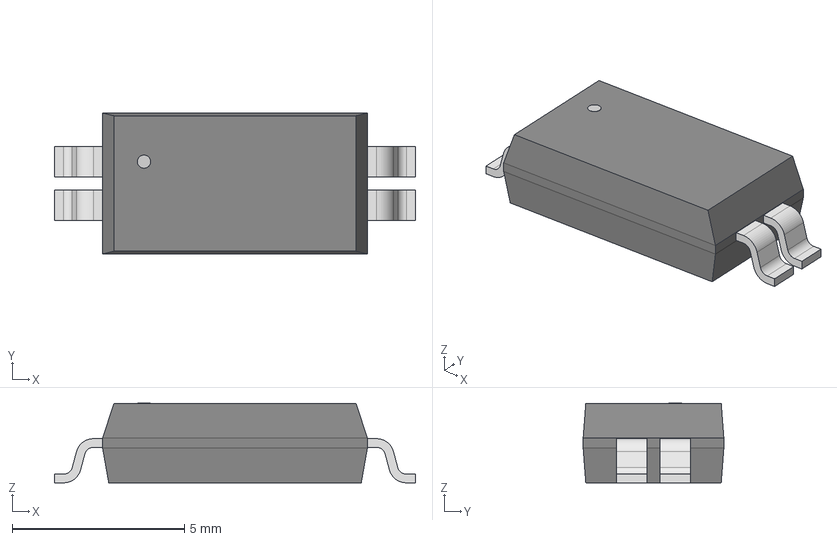
[picture p52: CAD file, 2024-04-17]
3d/t_so/SOP-4L_TC_VIS-M.step
10.5 x 4.09 x 2.31 mm
