xdmattz/kicad-library/3d/t_sot/D_SOD-523.step

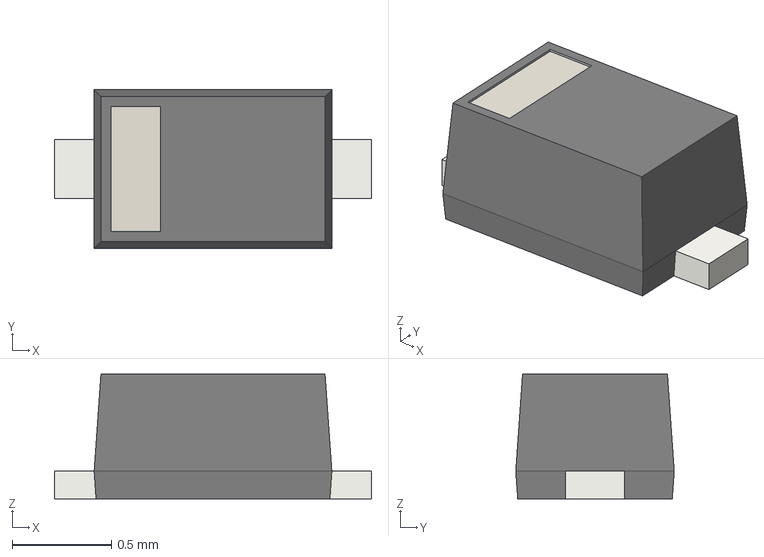
[picture p53: CAD file, 2024-04-17]
3d/t_sot/D_SOD-523.step
1.60 x 0.8 x 0.63 mm
