xdmattz/kicad-library/3d/t_switch/G6ZK_1FE.step

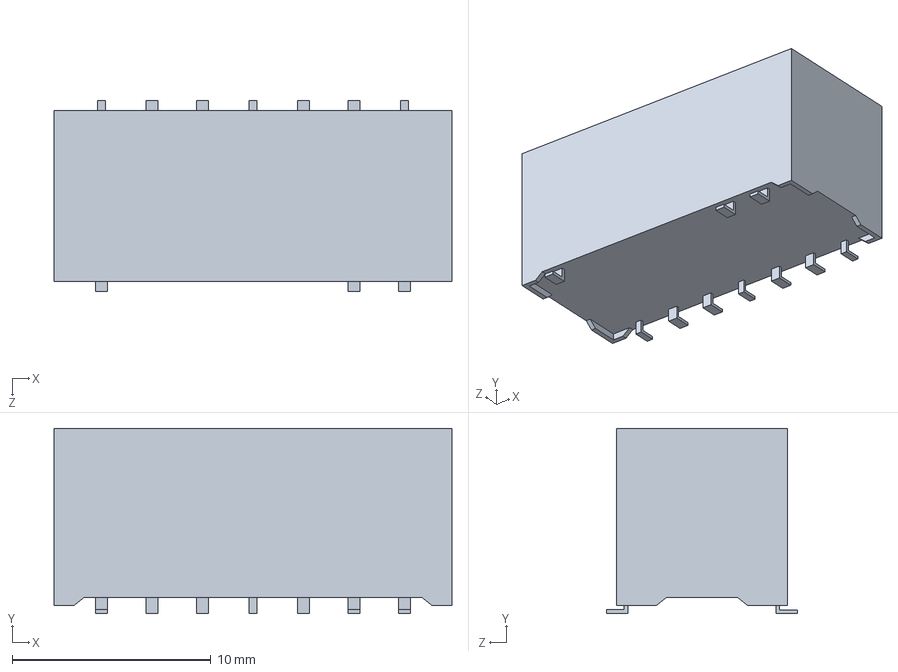
[picture p54: CAD file, 2024-04-17]
3d/t_switch/G6ZK_1FE.step
20.0 x 9.30 x 9.60 mm
