xdmattz/kicad-library/3d/t_to/TO-247_factory.stp

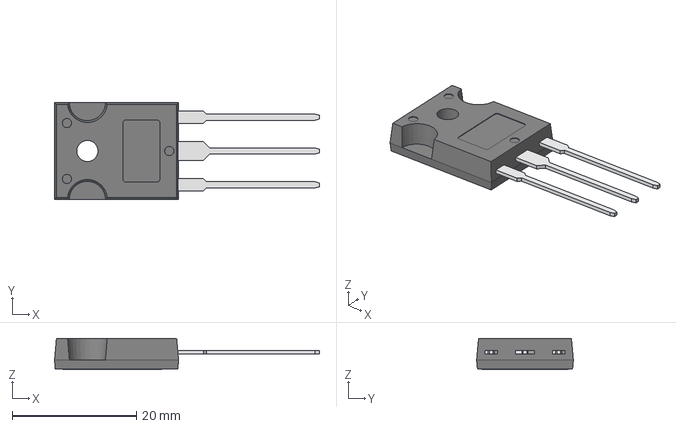
[picture p55: CAD file, 2024-04-17]
3d/t_to/TO-247_factory.stp
42.7 x 15.6 x 5.00 mm
