xdmattz/kicad-library/3d/t_txfmr/070-6258 (rev1).STEP

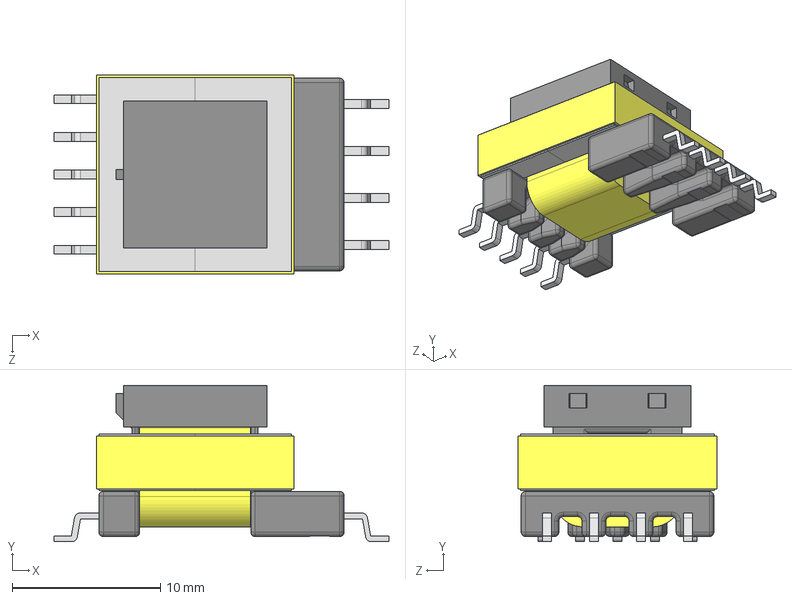
[picture p56: CAD file, 2024-04-17]
3d/t_txfmr/070-6258 (rev1).STEP
22.6 x 10.6 x 13.4 mm
070-6258_6D
150-2300_6A x 2
186-0137_6D
070-4820_coil
