xdmattz/kicad-library/3d/t_BGA/caBGA256_LAT.step

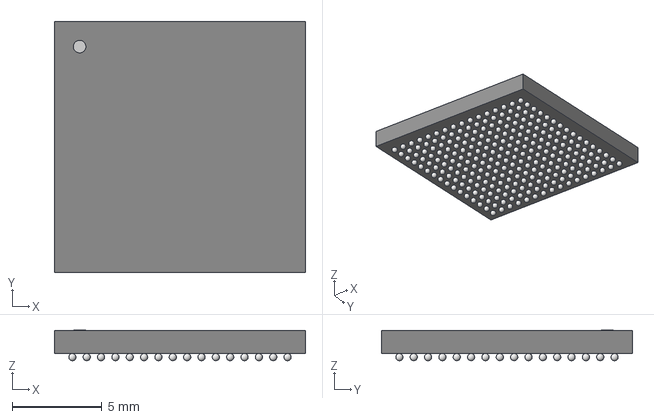
[picture p57: CAD file, 2024-04-17]
3d/t_BGA/caBGA256_LAT.step
14.0 x 14.0 x 1.70 mm
