xdmattz/kicad-library/3d/t_coilcraft/Coilcraft-B09T.STEP

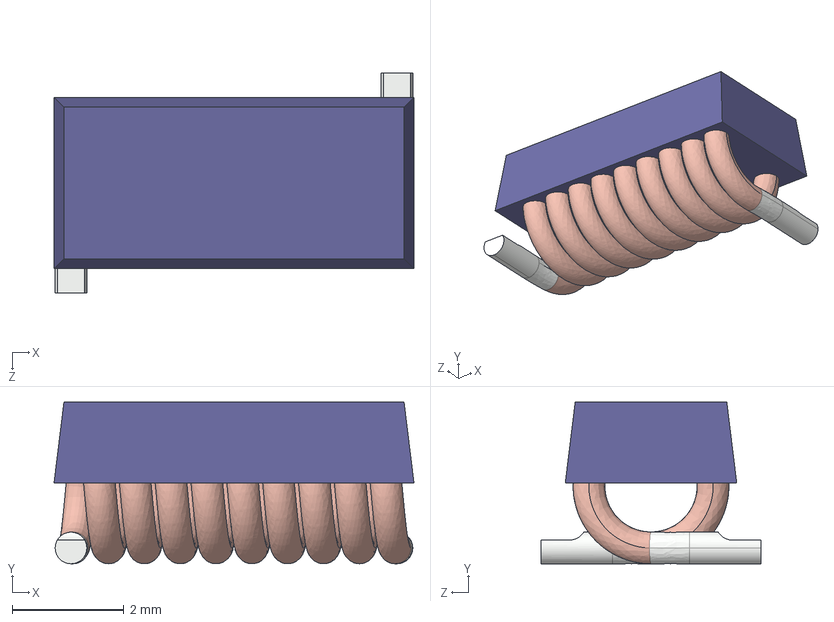
[picture p58: CAD file, 2024-04-17]
3d/t_coilcraft/Coilcraft-B09T.STEP
6.45 x 2.90 x 3.94 mm
Coilcraft-B09T_W24ATZ2-X [AXXT-BXXT]_B09T_2
Coilcraft-B09T_36-625 [T7-569]_B09X_2
