xdmattz/kicad-library/3d/t_crystal/WIFI_4343W v1.step

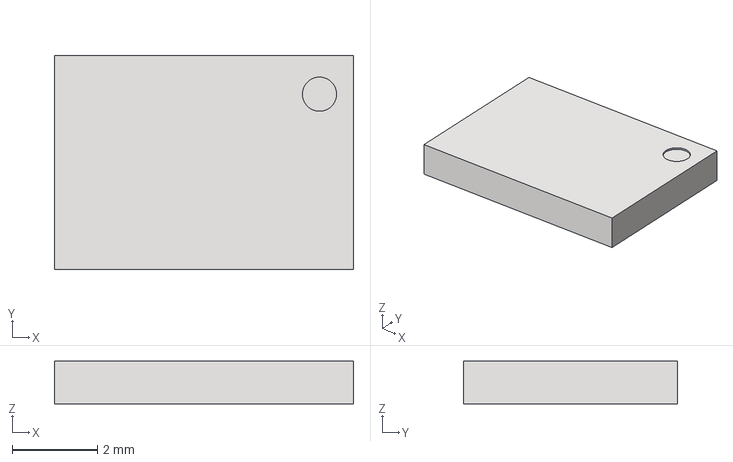
[picture p59: CAD file, 2024-04-17]
3d/t_crystal/WIFI_4343W v1.step
7.00 x 5.00 x 1.00 mm
