xdmattz/kicad-library/3d/t_do/SMB Package.step

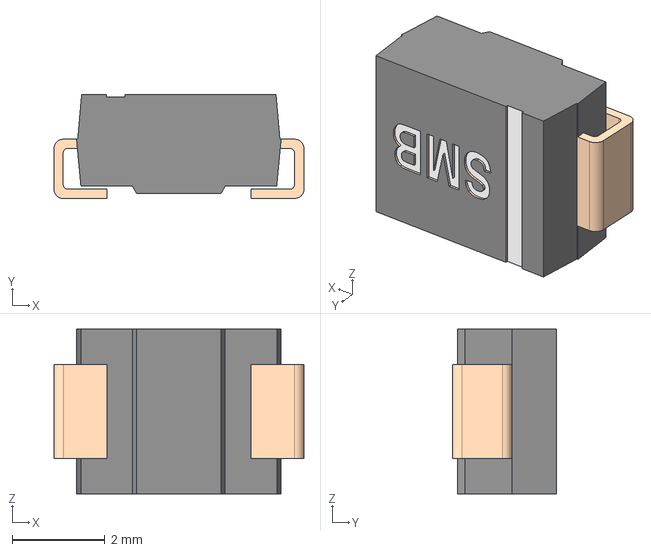
[picture p60: CAD file, 2024-04-17]
3d/t_do/SMB Package.step
5.40 x 2.25 x 3.56 mm
