xdmattz/kicad-library/3d/t_fuses/Fuse 0297025.STEP

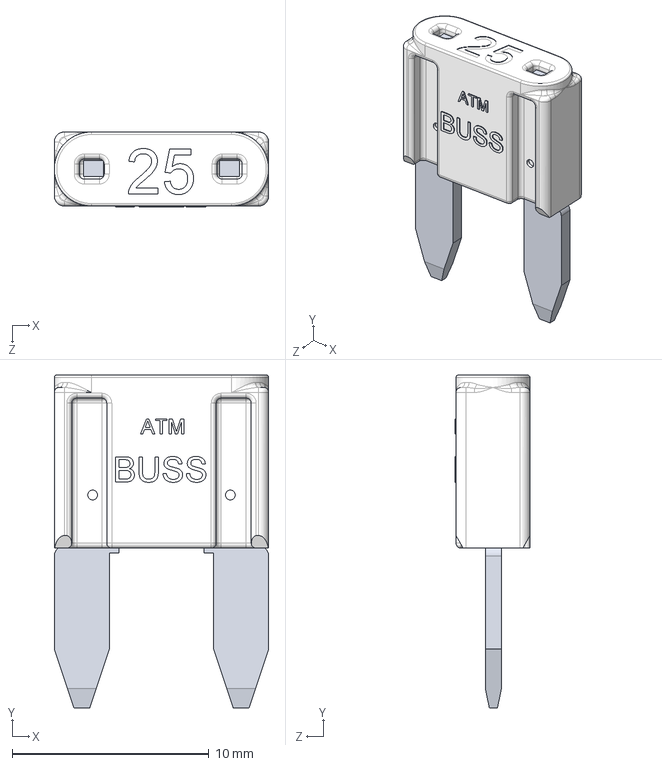
[picture p61: CAD file, 2024-04-17]
3d/t_fuses/Fuse 0297025.STEP
10.9 x 16.9 x 3.81 mm
