xdmattz/kicad-library/3d/t_header/1.27mm/DS1031-01-1x8P8BV3-1.stp

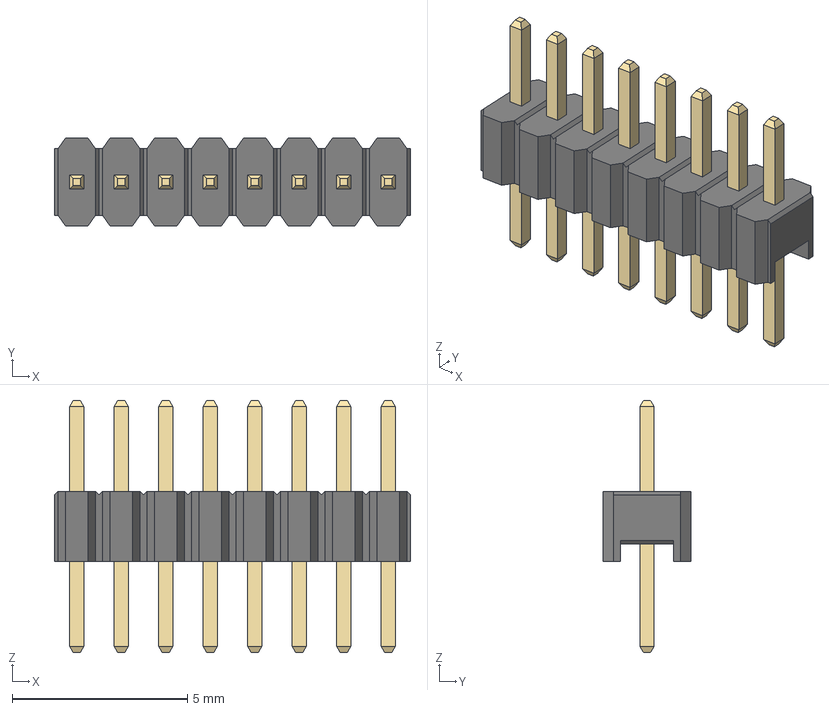
[picture p62: CAD file, 2024-04-17]
3d/t_header/1.27mm/DS1031-01-1x8P8BV3-1.stp
10.2 x 2.50 x 7.20 mm
