xdmattz/kicad-library/3d/t_header/2.54mm/DS1021-2x4S61.stp

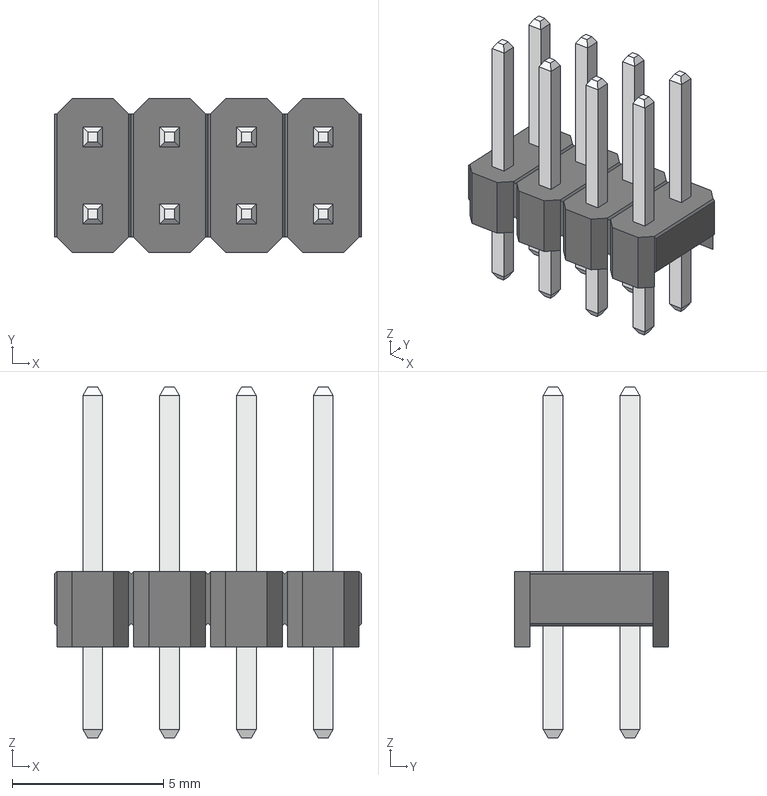
[picture p63: CAD file, 2024-04-17]
3d/t_header/2.54mm/DS1021-2x4S61.stp
10.2 x 5.08 x 11.6 mm
