xdmattz/kicad-library/3d/t_misc/PCB_PEM_6-32 v1.step

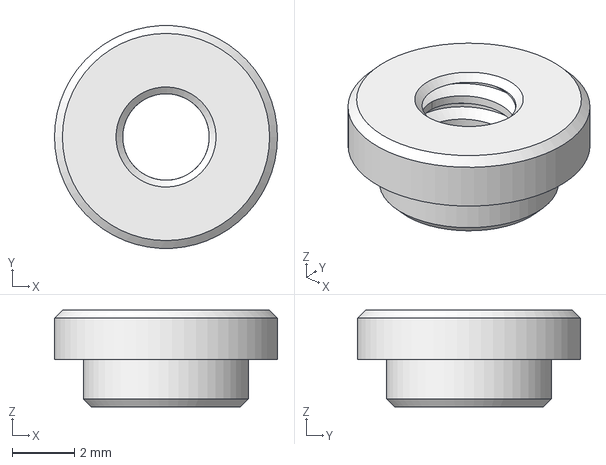
[picture p64: CAD file, 2024-04-17]
3d/t_misc/PCB_PEM_6-32 v1.step
7.14 x 7.13 x 3.10 mm
