xdmattz/kicad-library/3d/t_passive_smd/cap_1206.stp

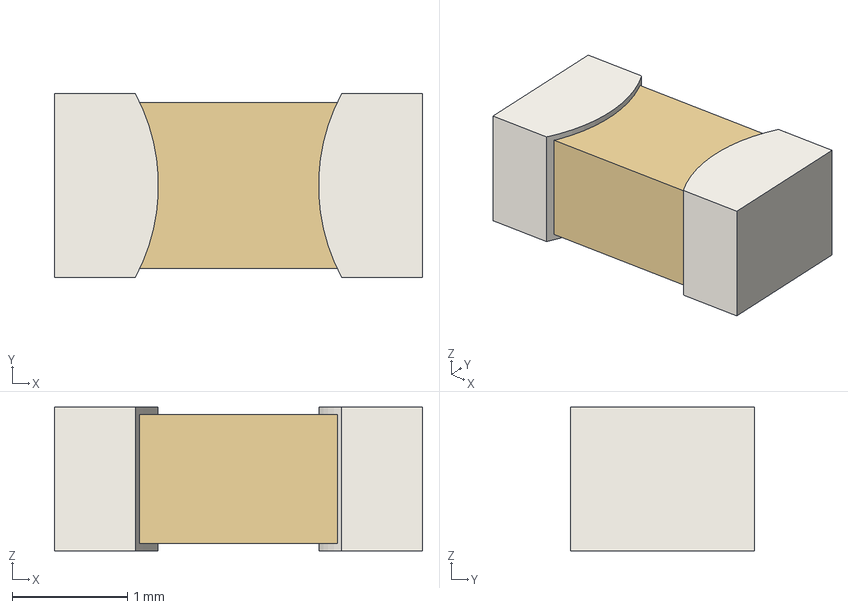
[picture p65: CAD file, 2024-04-17]
3d/t_passive_smd/cap_1206.stp
3.20 x 1.60 x 1.25 mm
End
End(Mirror)
