xdmattz/kicad-library/3d/t_passive_thd/RES-0.25W-V-MF.stp

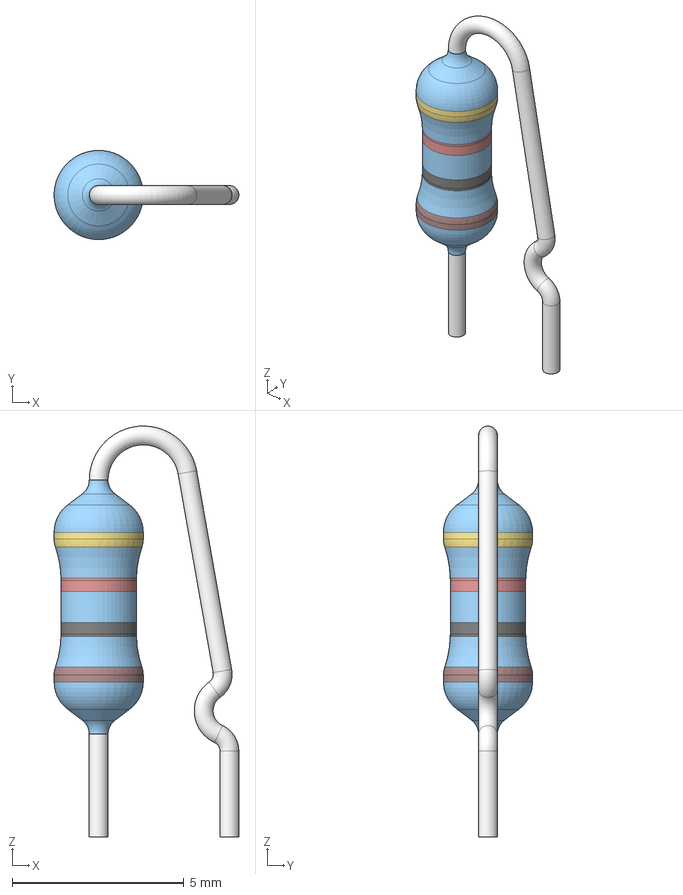
[picture p66: CAD file, 2024-04-17]
3d/t_passive_thd/RES-0.25W-V-MF.stp
5.38 x 2.60 x 12.0 mm
