xdmattz/kicad-library/3d/t_Phoenix/RA_Socket_4.step

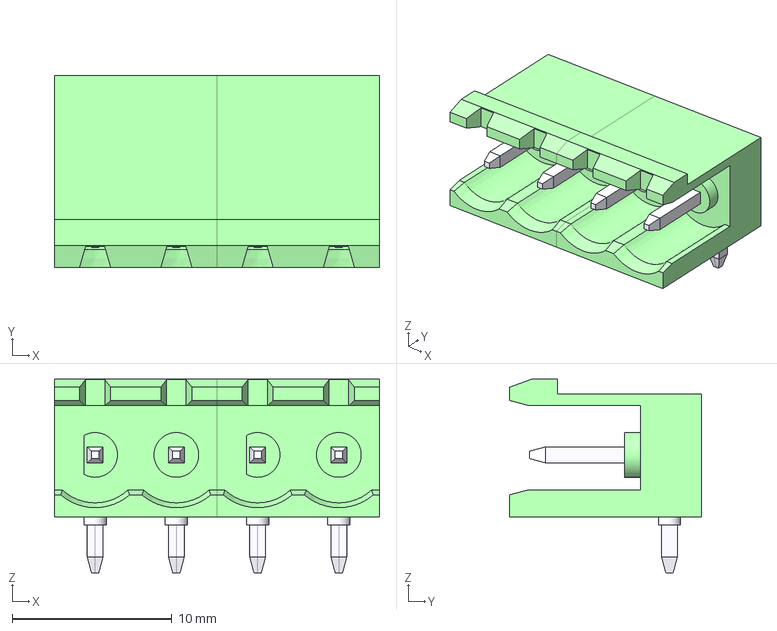
[picture p67: CAD file, 2024-04-17]
3d/t_Phoenix/RA_Socket_4.step
20.3 x 12.0 x 12.1 mm
mstb_2.5-2-g-5
mstb_2.5-2-g-5 (1)
