xdmattz/kicad-library/3d/t_qfn/eTQFP48_9x9_TRI.step

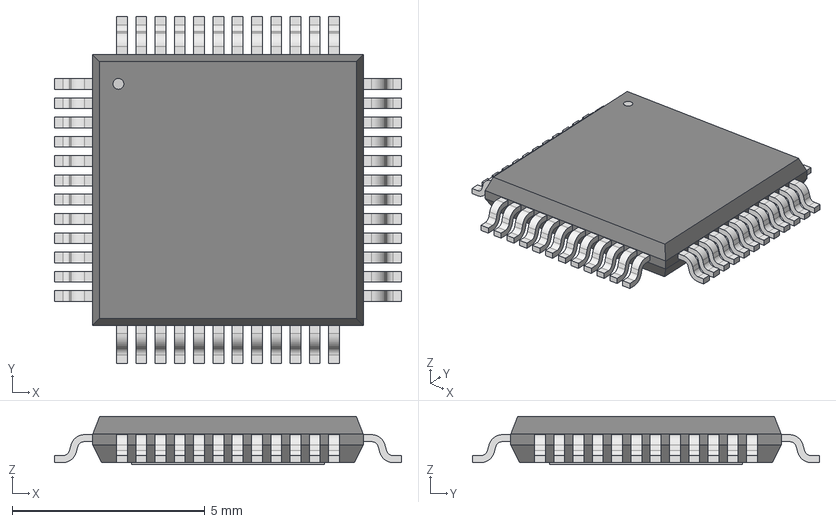
[picture p68: CAD file, 2024-04-17]
3d/t_qfn/eTQFP48_9x9_TRI.step
8.99 x 8.99 x 1.25 mm
