xdmattz/kicad-library/3d/t_RF_conn/32K145-400L5.stp

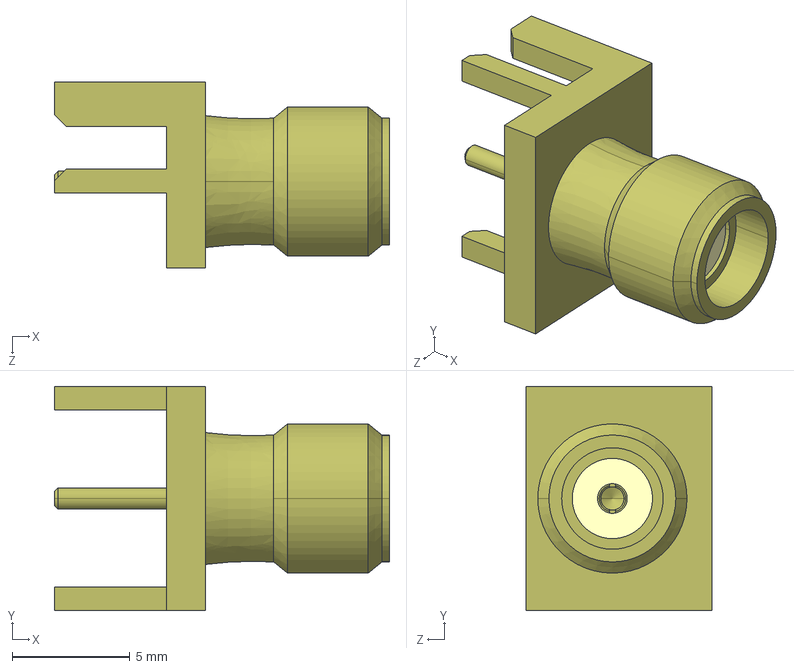
[picture p69: CAD file, 2024-04-17]
3d/t_RF_conn/32K145-400L5.stp
14.2 x 9.50 x 7.90 mm
