xdmattz/kicad-library/3d/t_RF_misc/HHM-6_1P6X0P8.stp

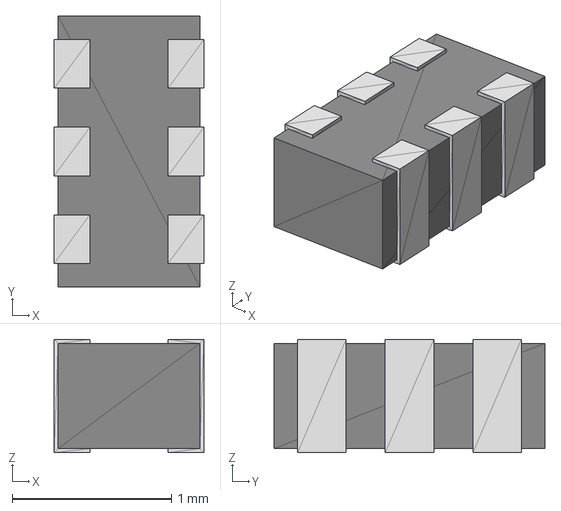
[picture p70: CAD file, 2024-04-17]
3d/t_RF_misc/HHM-6_1P6X0P8.stp
0.94 x 1.70 x 0.711 mm
