xdmattz/kicad-library/3d/t_Samtec/FTSH-106-01-L-DH.stp

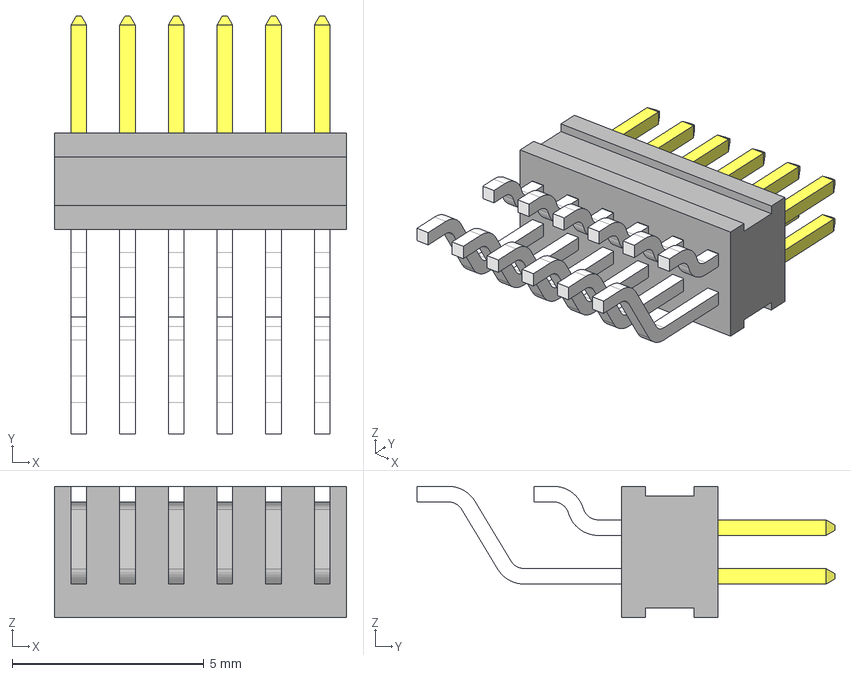
[picture p71: CAD file, 2024-04-17]
3d/t_Samtec/FTSH-106-01-L-DH.stp
7.62 x 10.9 x 3.43 mm
_FTSH-106-01-L-DH_body
_FTSH-106-01-L-DH_pins1
_FTSH-106-01-L-DH_pins2
