xdmattz/kicad-library/3d/t_smd_caps/CP_EIA-7343-20_Kemet-V.step

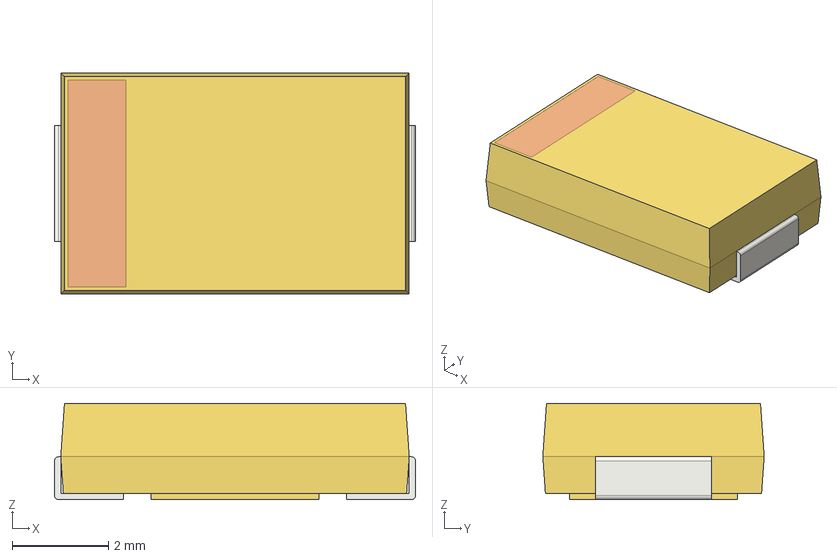
[picture p72: CAD file, 2024-04-17]
3d/t_smd_caps/CP_EIA-7343-20_Kemet-V.step
7.50 x 4.60 x 2.00 mm
