xdmattz/kicad-library/3d/t_smd_inductors/2-SMD.stp

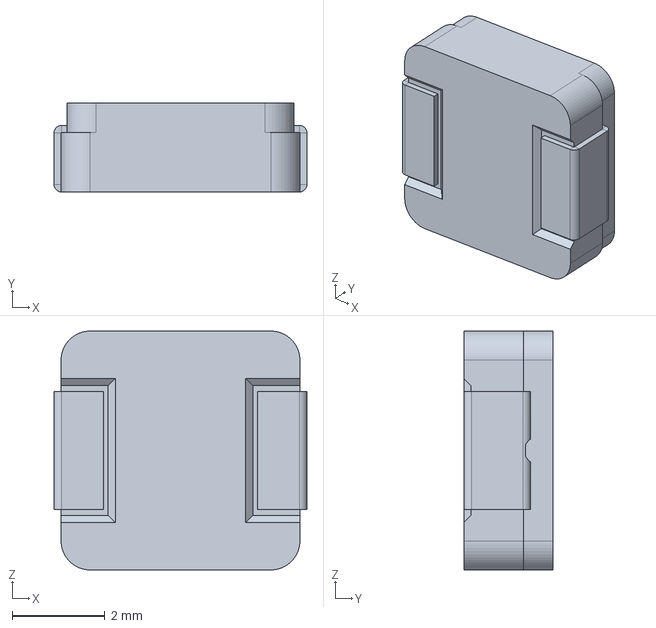
[picture p73: CAD file, 2024-04-17]
3d/t_smd_inductors/2-SMD.stp
5.45 x 1.92 x 5.15 mm
