xdmattz/kicad-library/3d/t_smd_transistors/SMini2-F5-B.stp

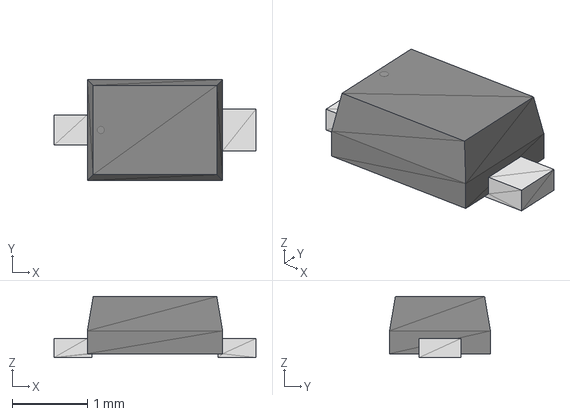
[picture p74: CAD file, 2024-04-17]
3d/t_smd_transistors/SMini2-F5-B.stp
2.69 x 1.35 x 0.815 mm
