xdmattz/kicad-library/3d/t_so/TSSOP-14.stp

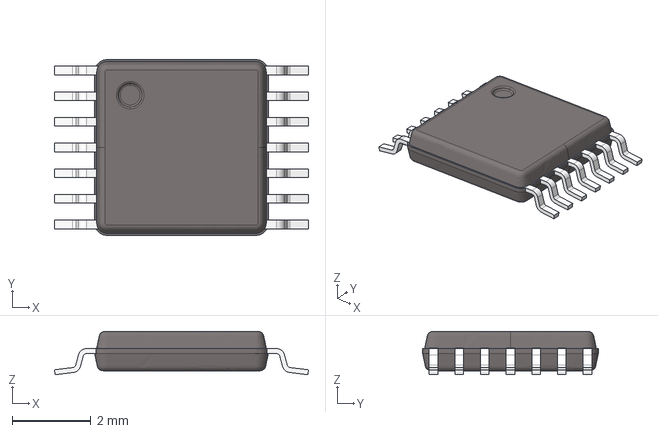
[picture p75: CAD file, 2024-04-17]
3d/t_so/TSSOP-14.stp
6.43 x 4.45 x 1.10 mm
