xdmattz/kicad-library/3d/t_sot/D_SOD-123F.step

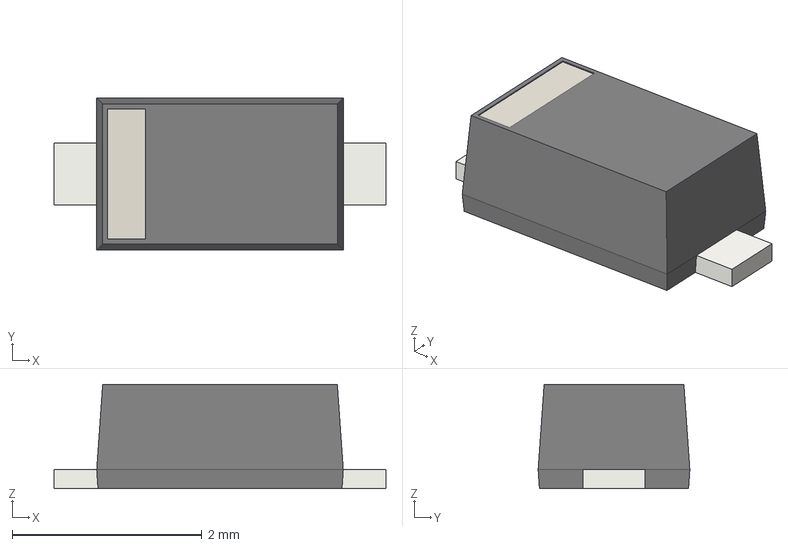
[picture p76: CAD file, 2024-04-17]
3d/t_sot/D_SOD-123F.step
3.50 x 1.60 x 1.10 mm
