xdmattz/kicad-library/3d/t_txfmr/EP-13.stp

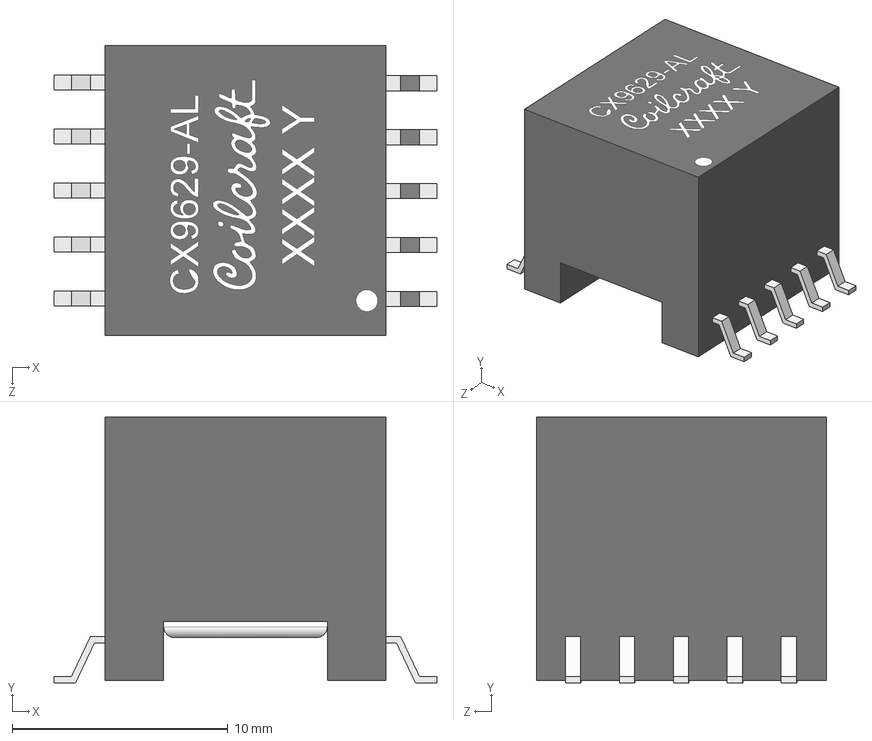
[picture p78: CAD file, 2024-04-17]
3d/t_txfmr/EP-13.stp
17.8 x 12.3 x 13.5 mm
