xdmattz/kicad-library/3d/t_USB/M-MUSBR-M5C1-X0-REVT3.STEP

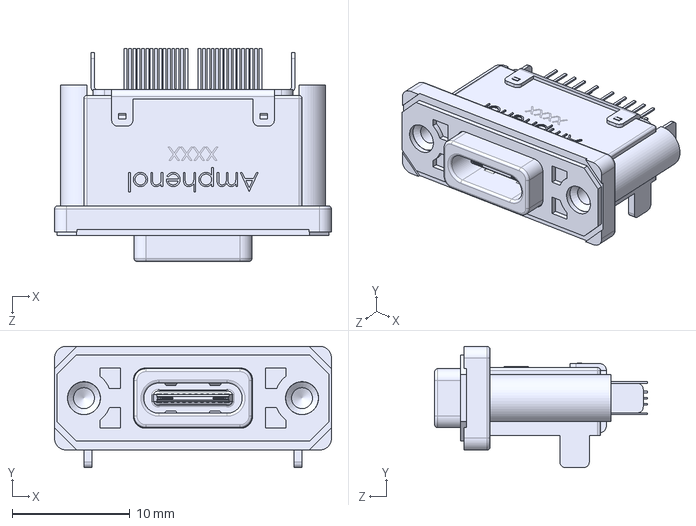
[picture p79: CAD file, 2024-04-17]
3d/t_USB/M-MUSBR-M5C1-X0-REVT3.STEP
23.5 x 10.3 x 18.1 mm
