xdmattz/kicad-library/3d/t_BGA/FBGA24_6X8X1_VAA024_CYP.step

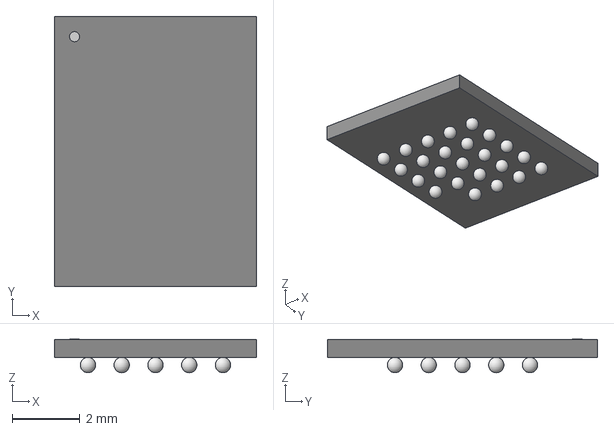
[picture p80: CAD file, 2024-04-17]
3d/t_BGA/FBGA24_6X8X1_VAA024_CYP.step
5.99 x 8.00 x 0.993 mm
