xdmattz/kicad-library/3d/t_coilcraft/Coilcraft-XAL1580-202.stp

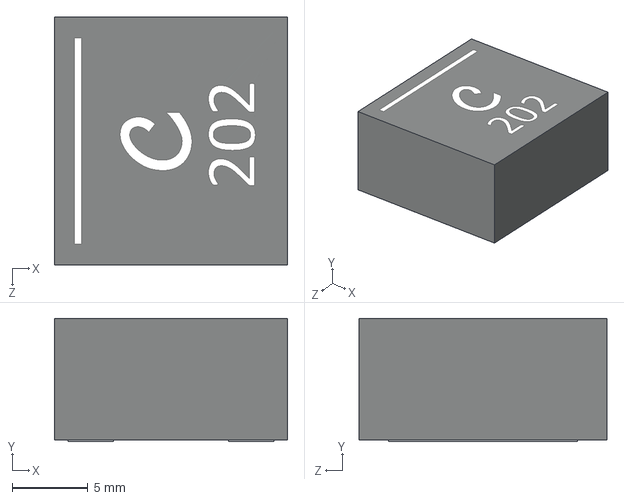
[picture p81: CAD file, 2024-04-17]
3d/t_coilcraft/Coilcraft-XAL1580-202.stp
15.4 x 8.13 x 16.4 mm
