xdmattz/kicad-library/3d/t_connectors/TMM-104-01-L-S-RA.stp

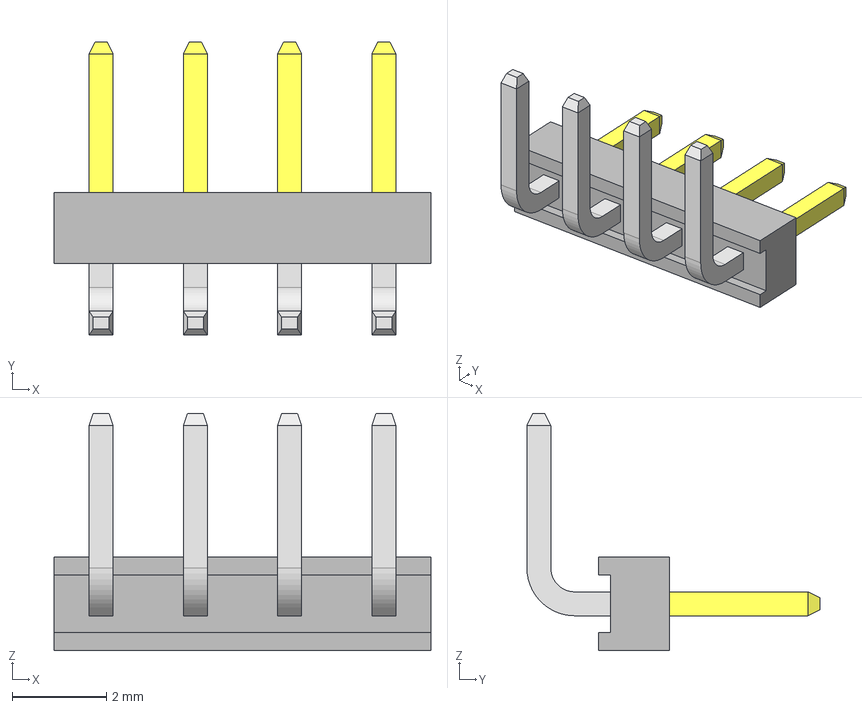
[picture p82: CAD file, 2024-04-17]
3d/t_connectors/TMM-104-01-L-S-RA.stp
8.00 x 6.22 x 5.03 mm
_TMM-104-01-L-S-RA_body
_TMM-104-01-L-S-RA_pins1
_TMM-104-01-L-S-RA_pins2
