xdmattz/kicad-library/3d/t_header/1.27mm/DS1031-01-1x5P8BV2-1.stp

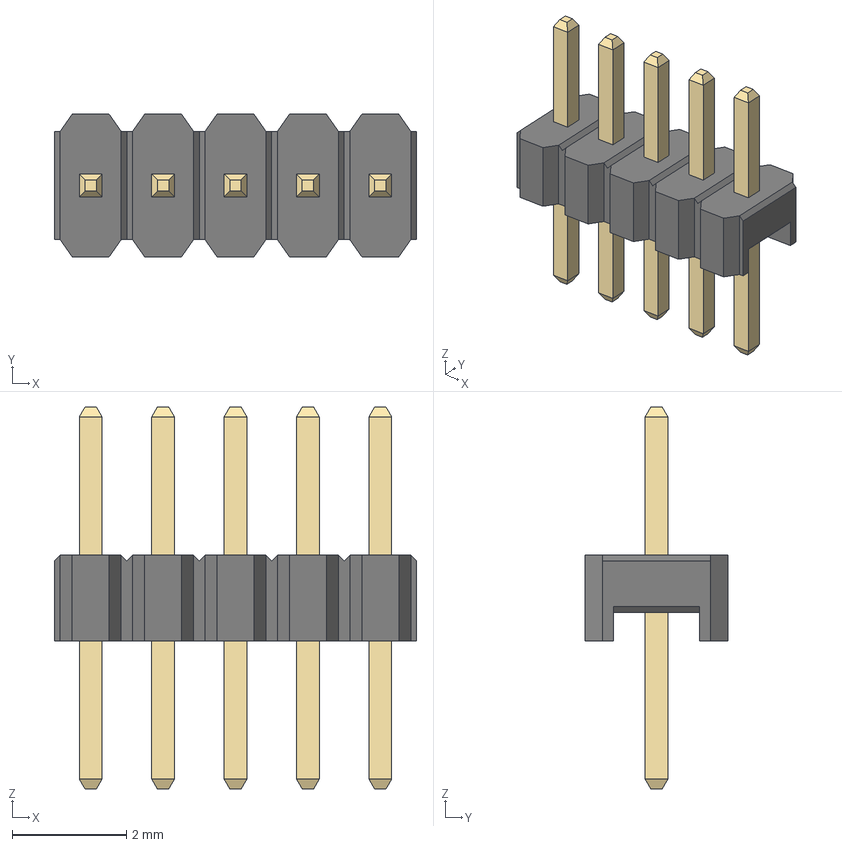
[picture p83: CAD file, 2024-04-17]
3d/t_header/1.27mm/DS1031-01-1x5P8BV2-1.stp
6.35 x 2.50 x 6.70 mm
