xdmattz/kicad-library/3d/t_header/2.54mm/DS1023-1x8SF11.stp

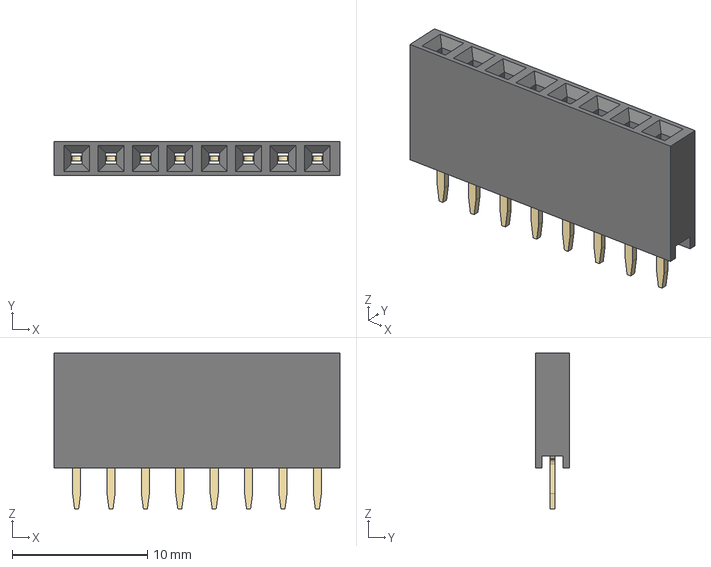
[picture p84: CAD file, 2024-04-17]
3d/t_header/2.54mm/DS1023-1x8SF11.stp
21.1 x 2.54 x 11.5 mm
