xdmattz/kicad-library/3d/t_misc/FUSE_AHEF1000.stp

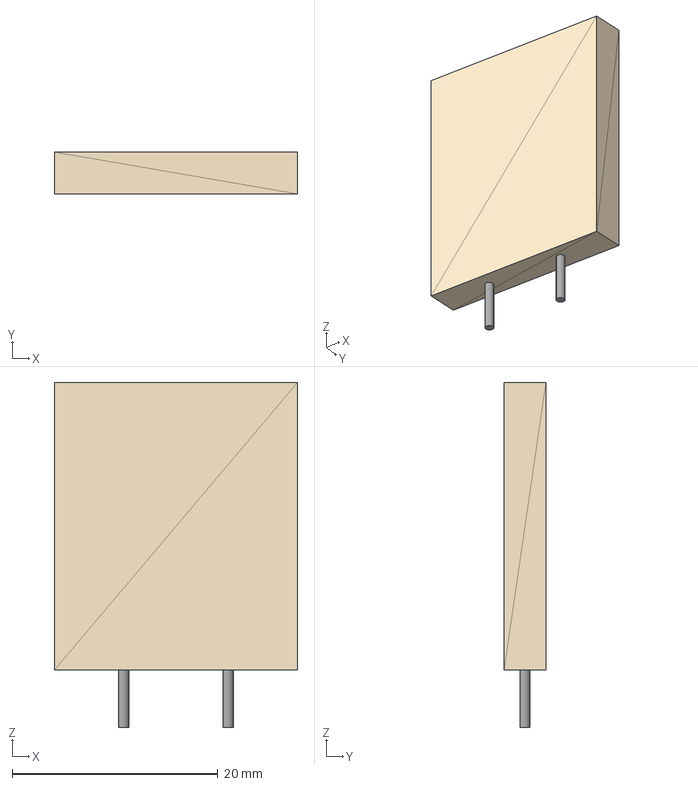
[picture p85: CAD file, 2024-04-17]
3d/t_misc/FUSE_AHEF1000.stp
23.6 x 4.06 x 33.5 mm
