xdmattz/kicad-library/3d/t_passive_smd/RESC-0805.stp

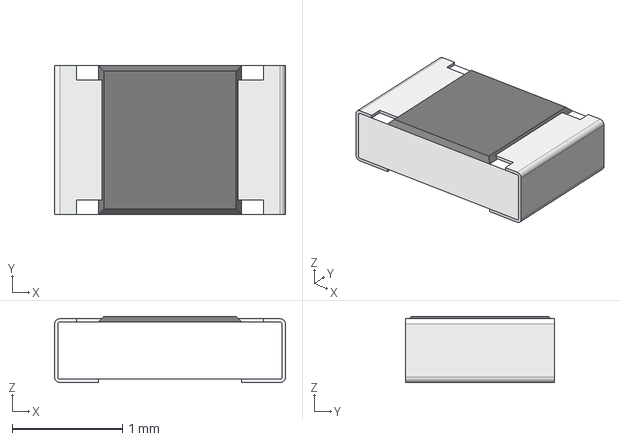
[picture p86: CAD file, 2024-04-17]
3d/t_passive_smd/RESC-0805.stp
2.10 x 1.35 x 0.6 mm
