xdmattz/kicad-library/3d/t_passive_thd/CAP_RAD_D12.5x25_POL_BK.stp

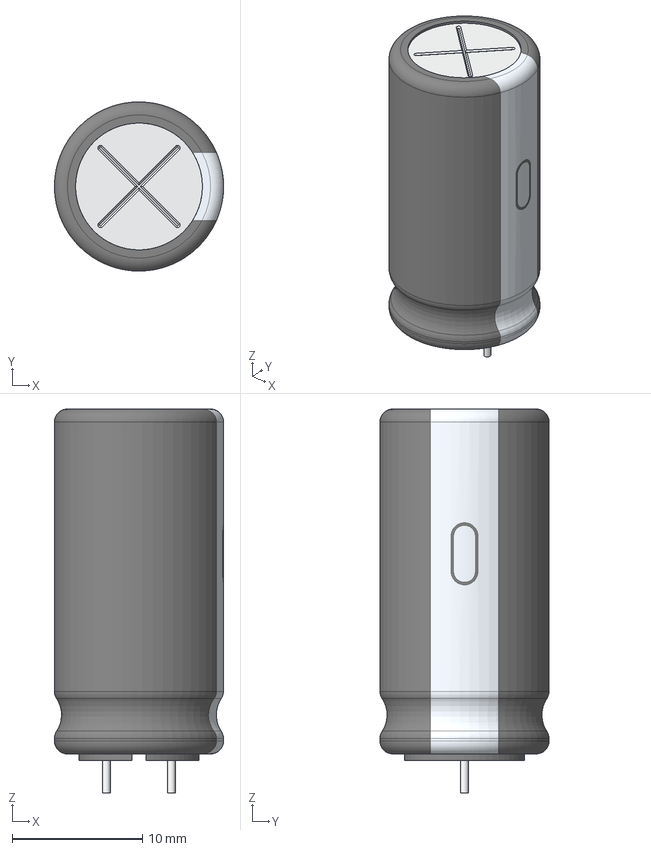
[picture p87: CAD file, 2024-04-17]
3d/t_passive_thd/CAP_RAD_D12.5x25_POL_BK.stp
13.0 x 13.0 x 29.5 mm
