xdmattz/kicad-library/3d/t_qfn/DFN-8_DD_LIT.step

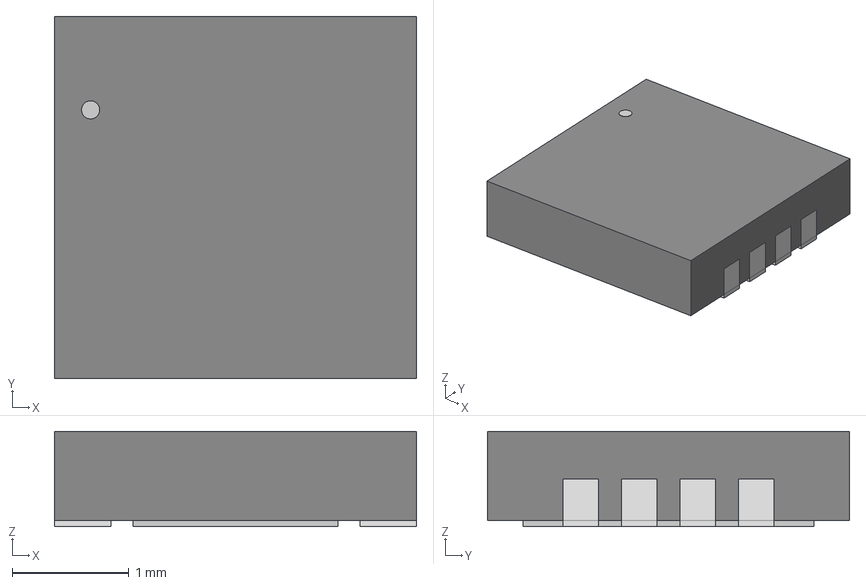
[picture p88: CAD file, 2024-04-17]
3d/t_qfn/DFN-8_DD_LIT.step
3.10 x 3.10 x 0.815 mm
