xdmattz/kicad-library/3d/t_RF_misc/Cy8CMod_062_4343W v2.step

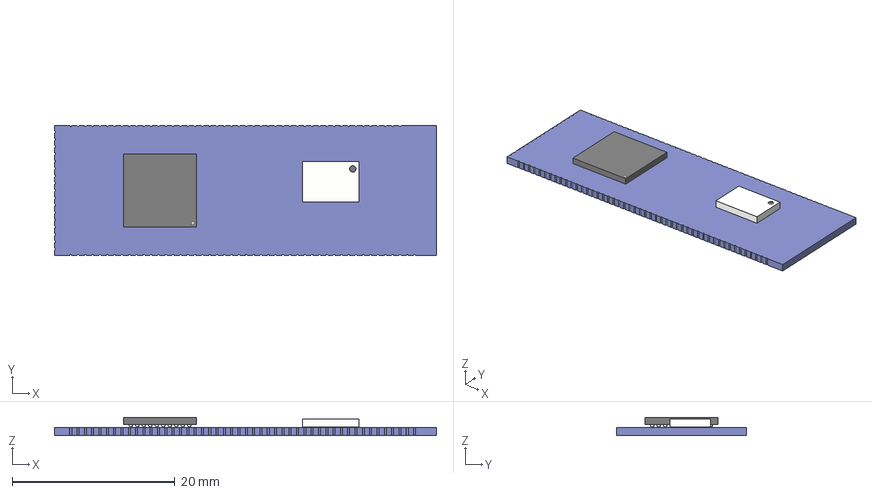
[picture p89: CAD file, 2024-04-17]
3d/t_RF_misc/Cy8CMod_062_4343W v2.step
47.0 x 16.0 x 2.25 mm
