xdmattz/kicad-library/3d/t_smd_caps/CP_EIA-3528-12_Kemet-T.step

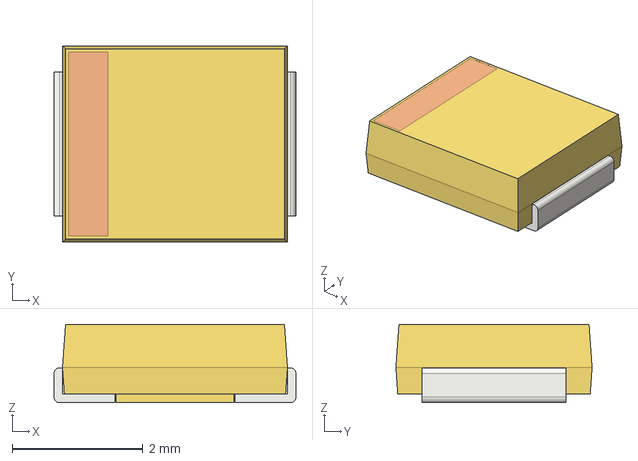
[picture p90: CAD file, 2024-04-17]
3d/t_smd_caps/CP_EIA-3528-12_Kemet-T.step
3.70 x 3.00 x 1.20 mm
