xdmattz/kicad-library/3d/t_smd_inductors/Toko 7KL v4.step

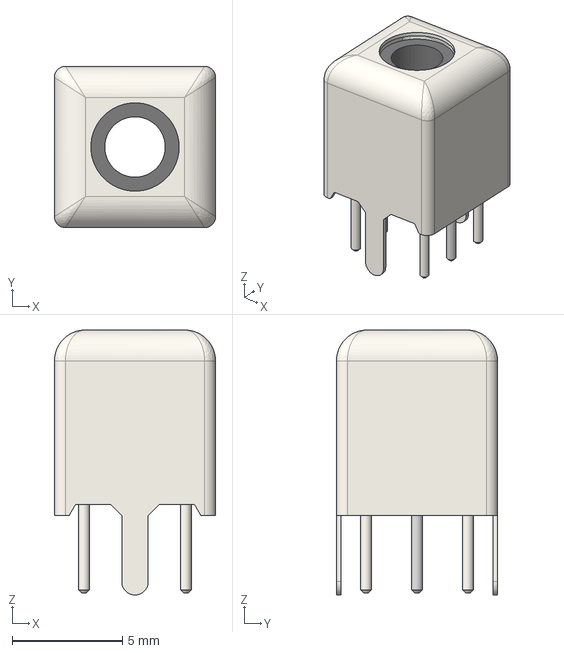
[picture p91: CAD file, 2024-04-17]
3d/t_smd_inductors/Toko 7KL v4.step
7.30 x 7.30 x 12.0 mm
