xdmattz/kicad-library/3d/t_smd_transistors/Power_Flat_5x6.stp

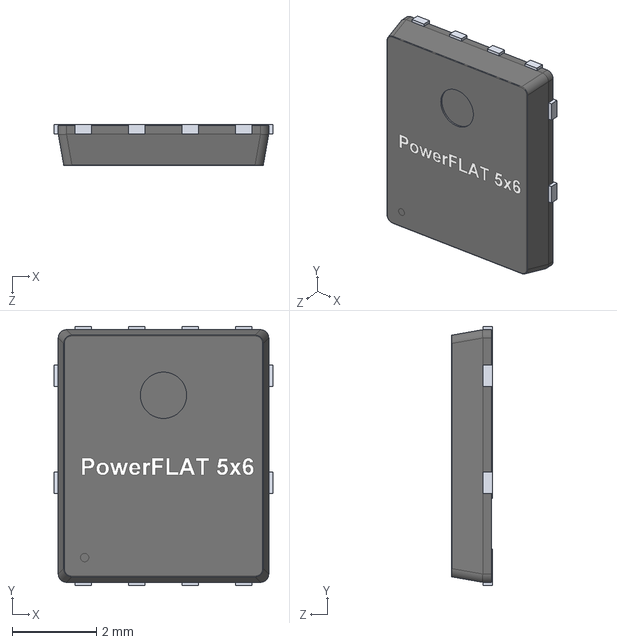
[picture p92: CAD file, 2024-04-17]
3d/t_smd_transistors/Power_Flat_5x6.stp
5.20 x 6.15 x 0.985 mm
