xdmattz/kicad-library/3d/t_so/SOIC28-W_MC_MCH.step

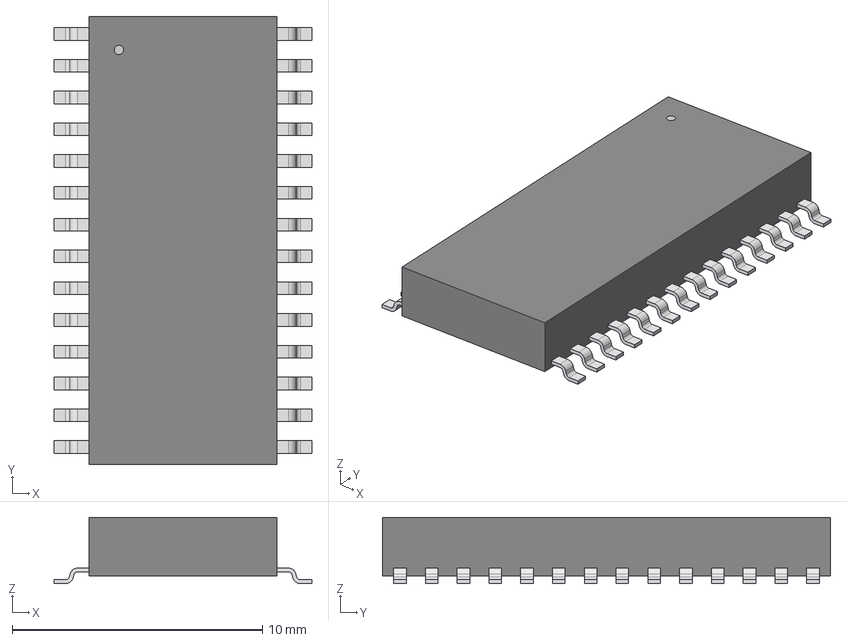
[picture p93: CAD file, 2024-04-17]
3d/t_so/SOIC28-W_MC_MCH.step
10.3 x 17.9 x 2.64 mm
