xdmattz/kicad-library/3d/t_sot/D_SOD-110.step

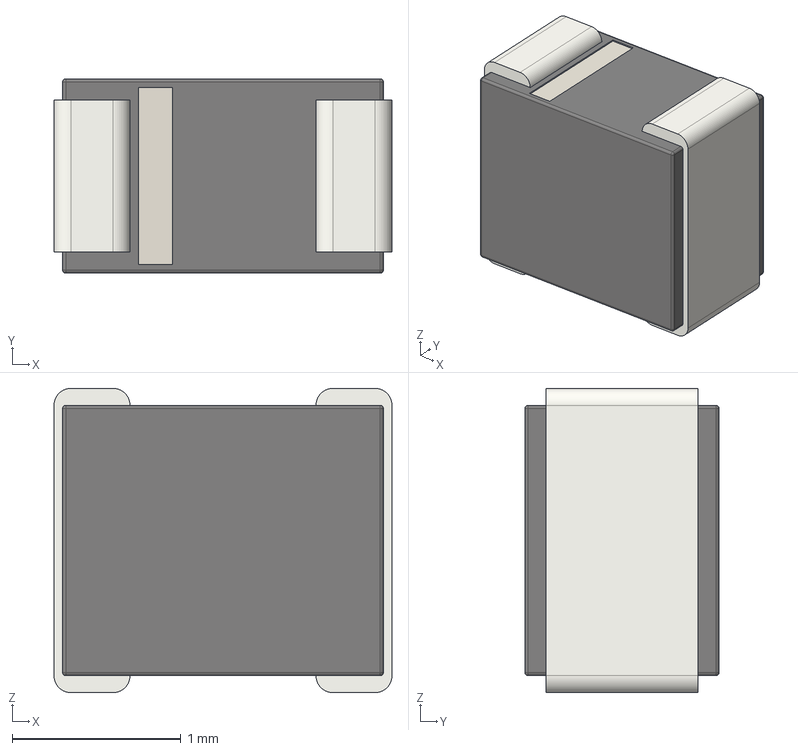
[picture p94: CAD file, 2024-04-17]
3d/t_sot/D_SOD-110.step
2.00 x 1.15 x 1.80 mm
