xdmattz/kicad-library/3d/t_to/TO-247_horizontal_back_line.stp

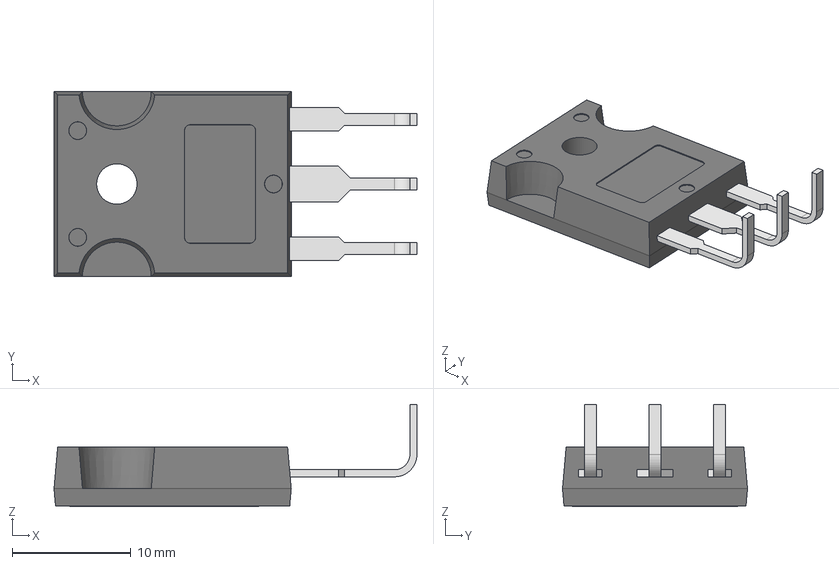
[picture p95: CAD file, 2024-04-17]
3d/t_to/TO-247_horizontal_back_line.stp
30.6 x 15.6 x 8.60 mm
