xdmattz/kicad-library/3d/t_txfmr/SOIC8-6_PH9572_PUL.step

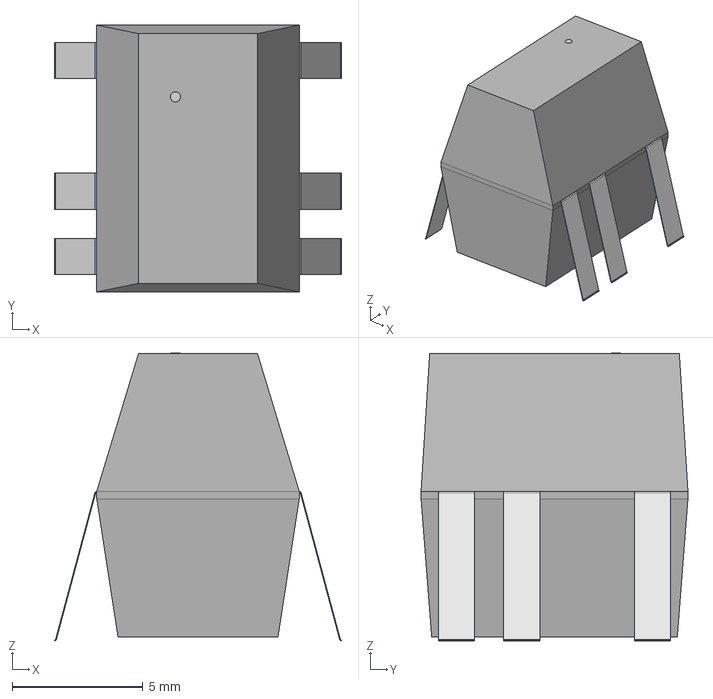
[picture p96: CAD file, 2024-04-17]
3d/t_txfmr/SOIC8-6_PH9572_PUL.step
11.0 x 10.2 x 11.0 mm
