xdmattz/kicad-library/3d/t_USB/ZX62-AB-5PA.stp

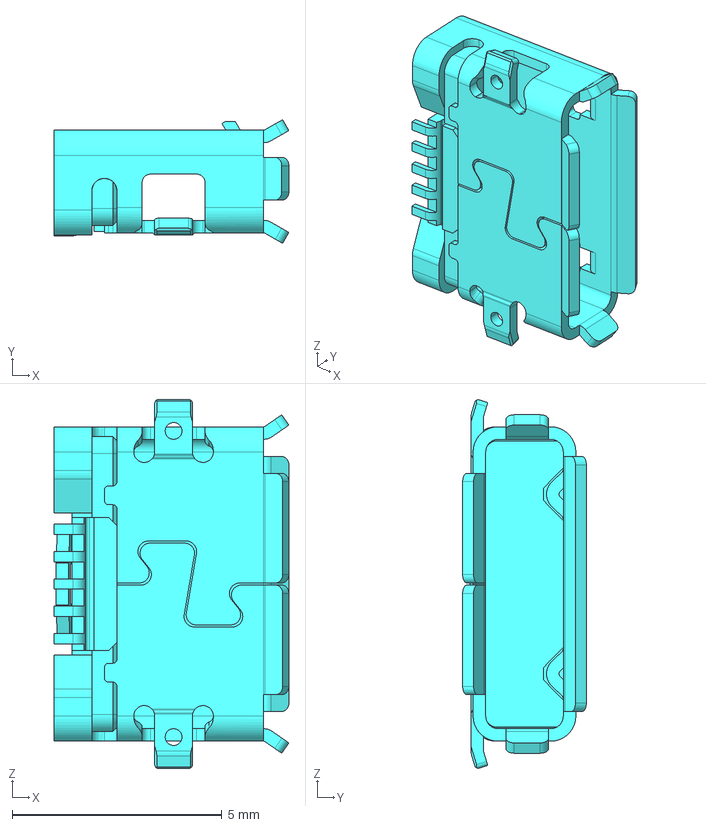
[picture p97: CAD file, 2024-04-17]
3d/t_USB/ZX62-AB-5PA.stp
5.60 x 2.95 x 8.80 mm
