xdmattz/kicad-library/3d/t_BGA/BC-196-16_ADI.step

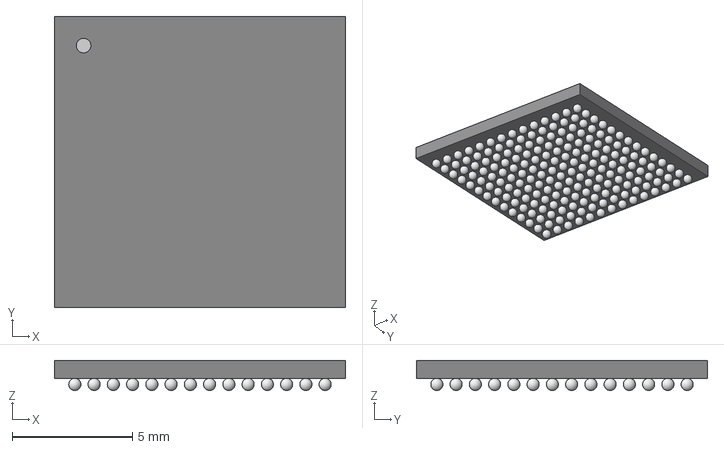
[picture p98: CAD file, 2024-04-17]
3d/t_BGA/BC-196-16_ADI.step
12.1 x 12.1 x 1.25 mm
