xdmattz/kicad-library/3d/t_coilcraft/Coilcraft-A01T.STEP

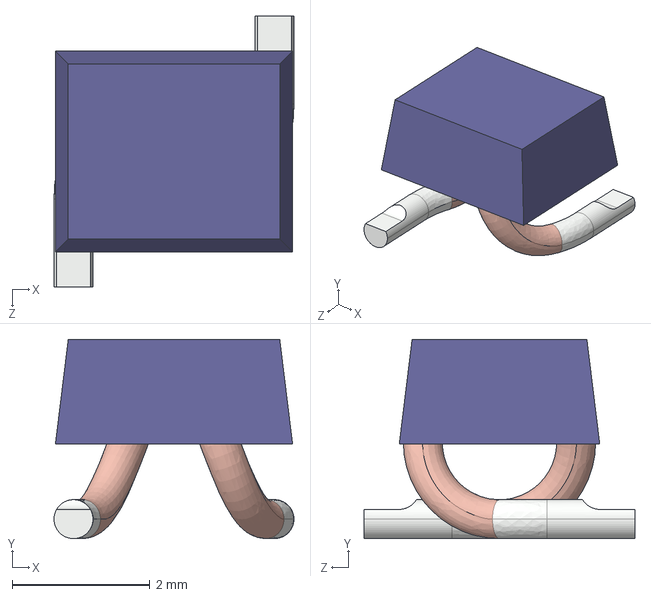
[picture p99: CAD file, 2024-04-17]
3d/t_coilcraft/Coilcraft-A01T.STEP
3.49 x 2.90 x 3.94 mm
Coilcraft-A01T_W24ATZ2-X [AXXT-BXXT]_A01T_2
Coilcraft-A01T_36-625 [T7-547]_A01X_2
