xdmattz/kicad-library/3d/t_connectors/MW-03-03-G-D-180-065.stp

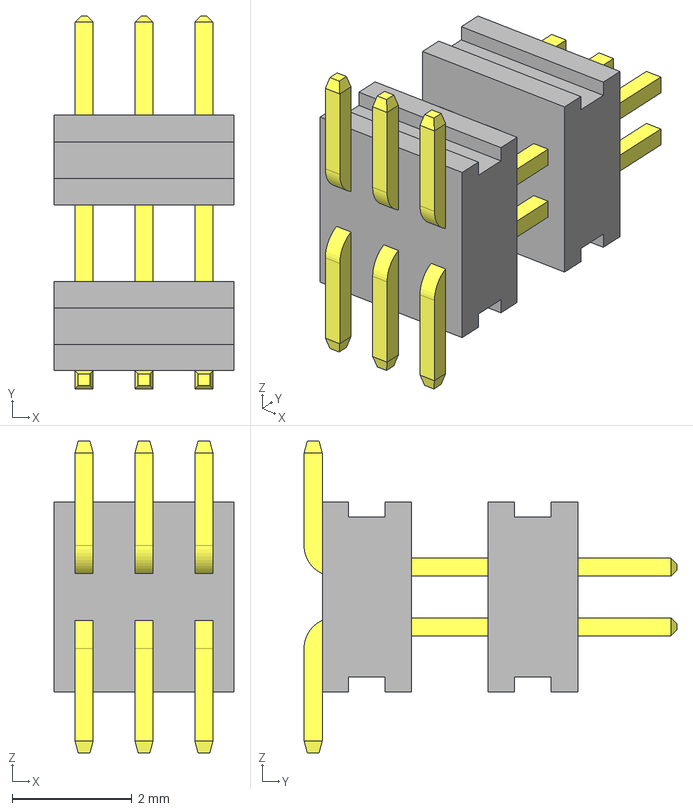
[picture p100: CAD file, 2024-04-17]
3d/t_connectors/MW-03-03-G-D-180-065.stp
3.00 x 6.22 x 5.21 mm
_MW-03-03-G-D-180-065_bottom_body
_MW-03-03-G-D-180-065_top_body
_MW-03-03-G-D-180-065_pins1
