xdmattz/kicad-library/3d/t_header/2.54mm/DS1023-1x5SF11.stp

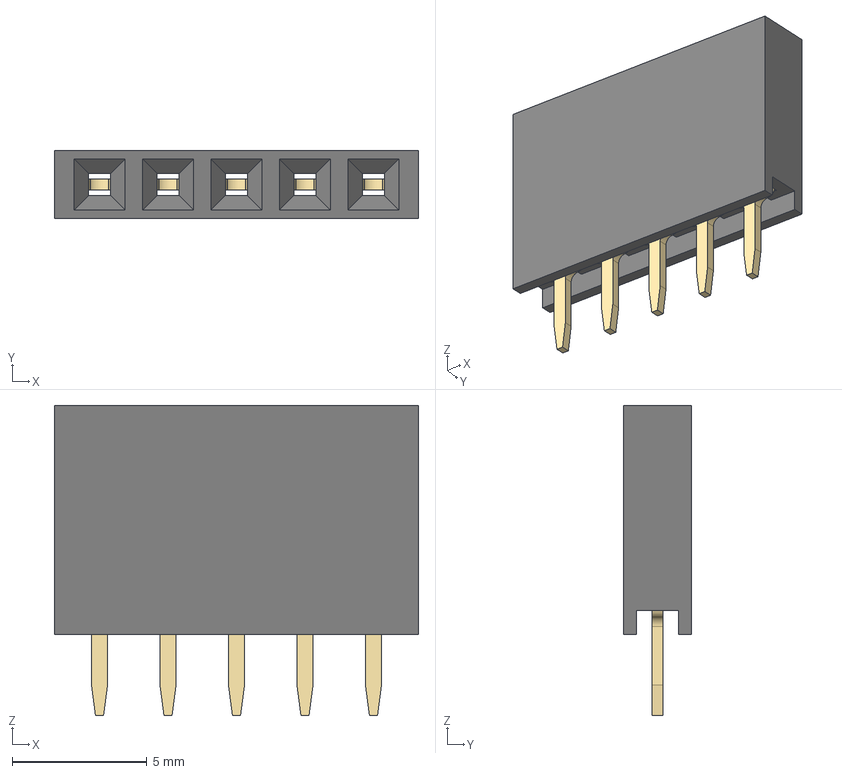
[picture p102: CAD file, 2024-04-17]
3d/t_header/2.54mm/DS1023-1x5SF11.stp
13.5 x 2.54 x 11.5 mm
