xdmattz/kicad-library/3d/t_misc/ROE_0505.stp

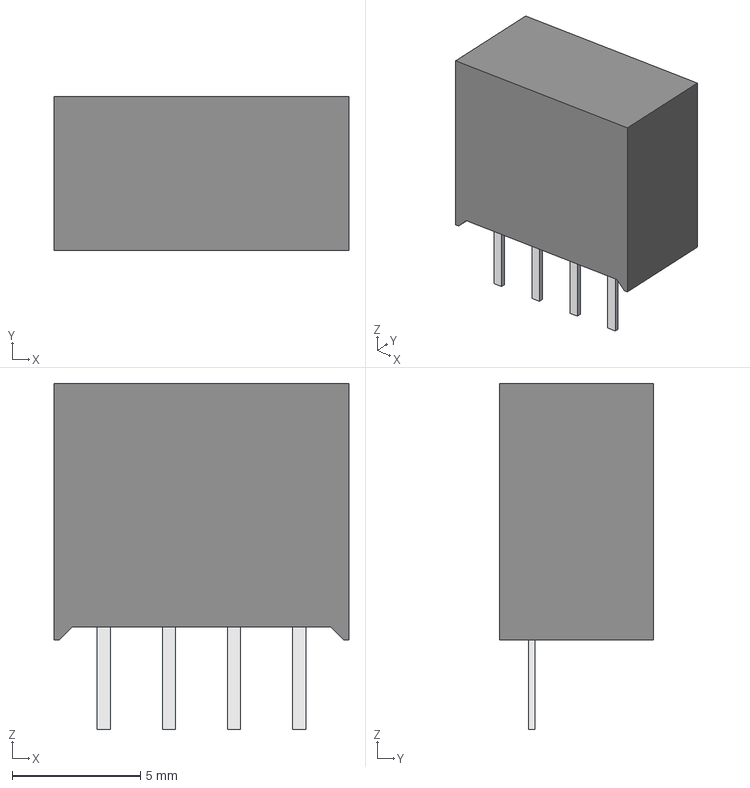
[picture p103: CAD file, 2024-04-17]
3d/t_misc/ROE_0505.stp
11.5 x 6.00 x 13.5 mm
