xdmattz/kicad-library/3d/t_passive_smd/CP_EIA-6032-28_Kemet-C.step

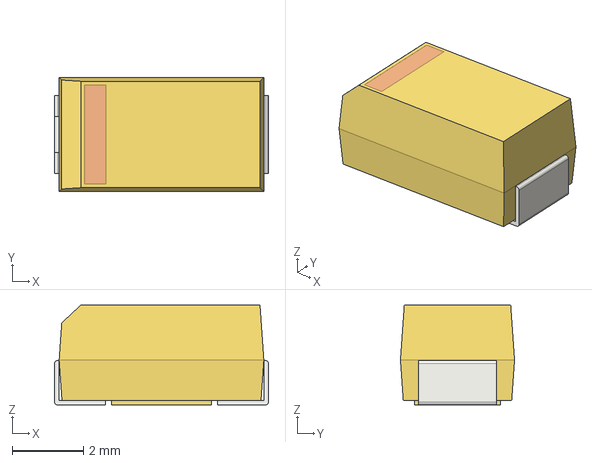
[picture p104: CAD file, 2024-04-17]
3d/t_passive_smd/CP_EIA-6032-28_Kemet-C.step
6.00 x 3.20 x 2.80 mm
