xdmattz/kicad-library/3d/t_passive_thd/CAP_RAD_D16x31.5_POL_BK.stp

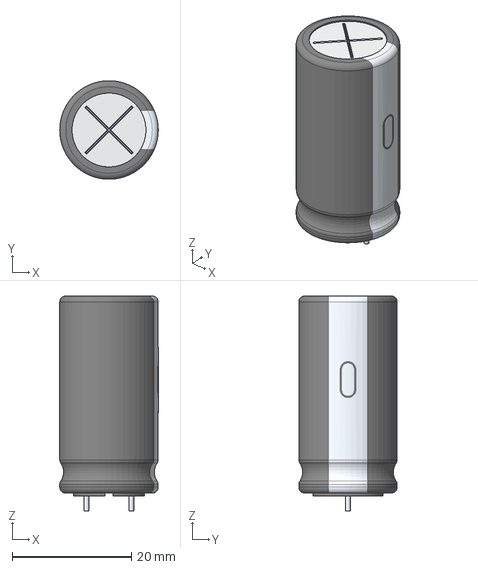
[picture p105: CAD file, 2024-04-17]
3d/t_passive_thd/CAP_RAD_D16x31.5_POL_BK.stp
16.5 x 16.5 x 36.0 mm
