xdmattz/kicad-library/3d/t_Phoenix/Terminal Block RA_2x2.step

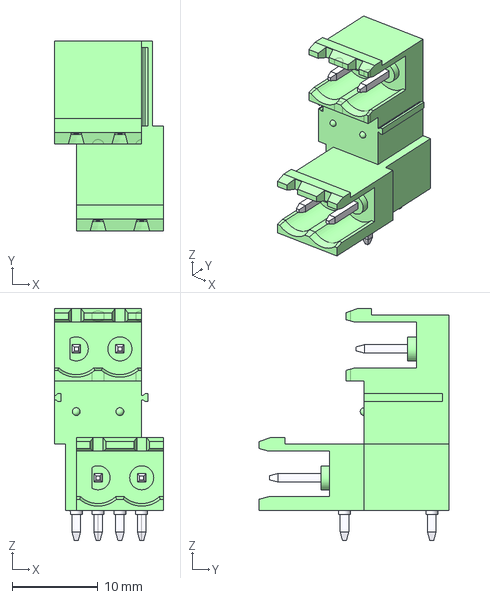
[picture p106: CAD file, 2024-04-17]
3d/t_Phoenix/Terminal Block RA_2x2.step
12.7 x 22.1 x 27.0 mm
