xdmattz/kicad-library/3d/t_qfn/QFN-38.step

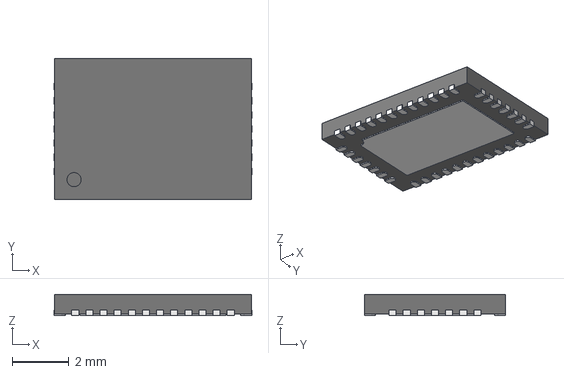
[picture p107: CAD file, 2024-04-17]
3d/t_qfn/QFN-38.step
7.00 x 5.00 x 0.75 mm
