xdmattz/kicad-library/3d/t_RF_misc/B3294.stp

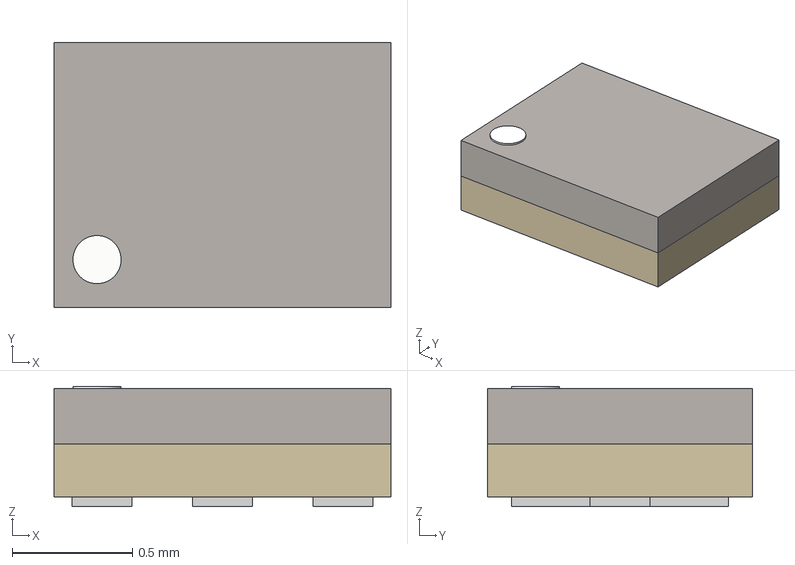
[picture p108: CAD file, 2024-04-17]
3d/t_RF_misc/B3294.stp
1.40 x 1.10 x 0.5 mm
