xdmattz/kicad-library/3d/t_smd_caps/CP_EIA-7343-43_Kemet-X.step

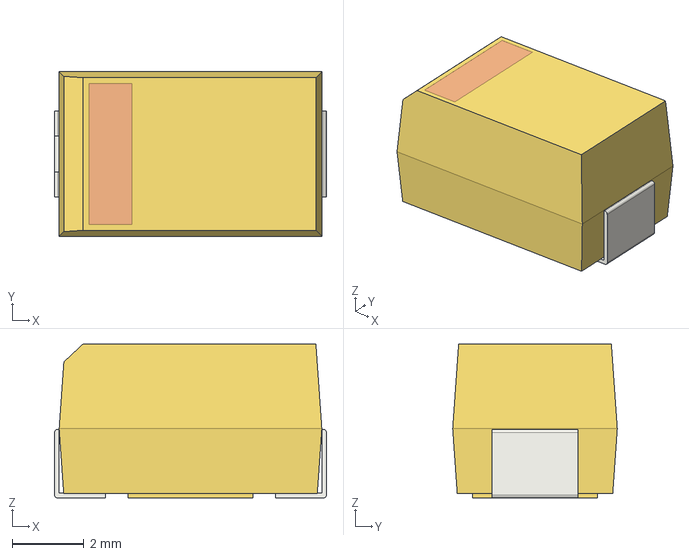
[picture p109: CAD file, 2024-04-17]
3d/t_smd_caps/CP_EIA-7343-43_Kemet-X.step
7.60 x 4.60 x 4.30 mm
