xdmattz/kicad-library/3d/t_smd_inductors/Toko 5K v1.step

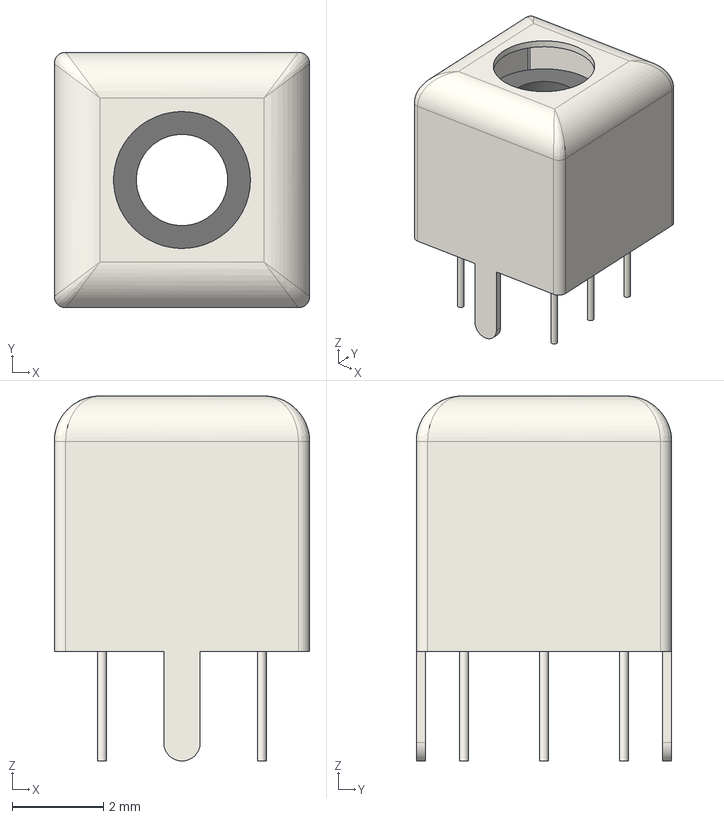
[picture p110: CAD file, 2024-04-17]
3d/t_smd_inductors/Toko 5K v1.step
5.60 x 5.60 x 8.00 mm
