xdmattz/kicad-library/3d/t_smd_transistors/PowerDI5.stp

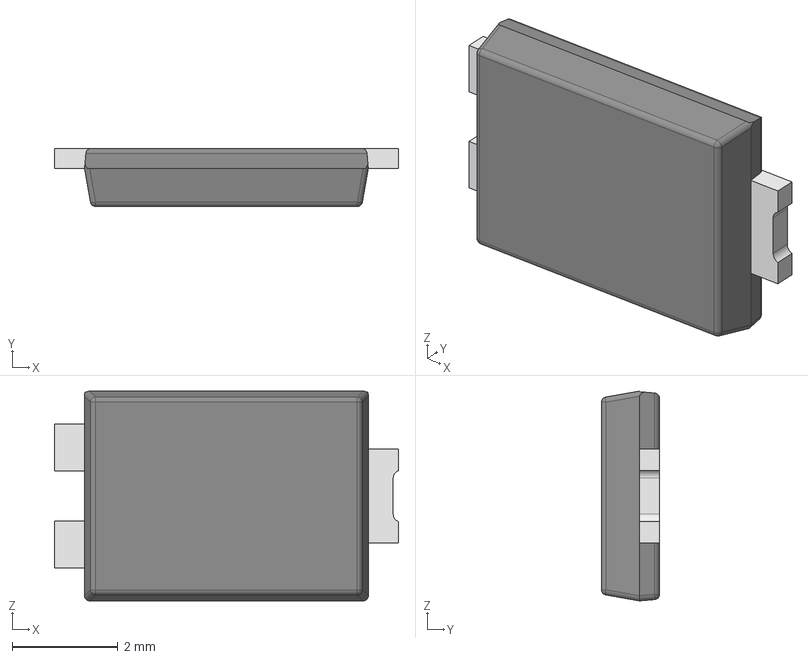
[picture p111: CAD file, 2024-04-17]
3d/t_smd_transistors/PowerDI5.stp
6.51 x 1.10 x 3.97 mm
PD-5 compound
PD-5 LF_0
PD-5 LF
