xdmattz/kicad-library/3d/t_so/8uSOP.stp

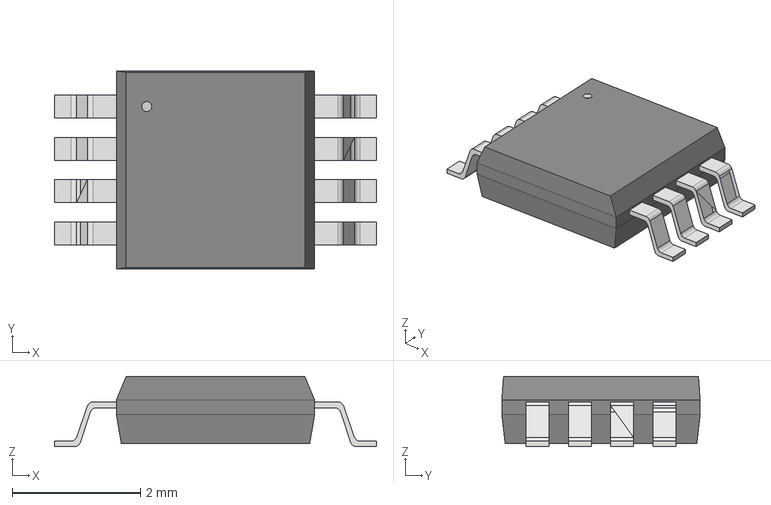
[picture p112: CAD file, 2024-04-17]
3d/t_so/8uSOP.stp
5.03 x 3.10 x 1.09 mm
