xdmattz/kicad-library/3d/t_sot/DDF0008A.stp

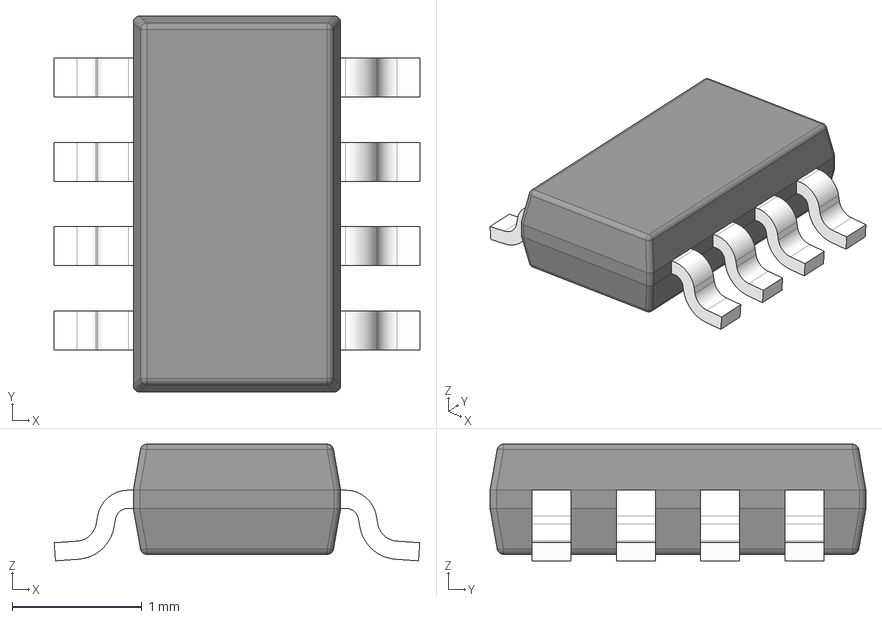
[picture p113: CAD file, 2024-04-17]
3d/t_sot/DDF0008A.stp
2.82 x 2.90 x 0.9 mm
BODY-SO
LEAD-SO x 8
PIN1-ID
