xdmattz/kicad-library/3d/t_USB/USB4110-GF-A.STEP

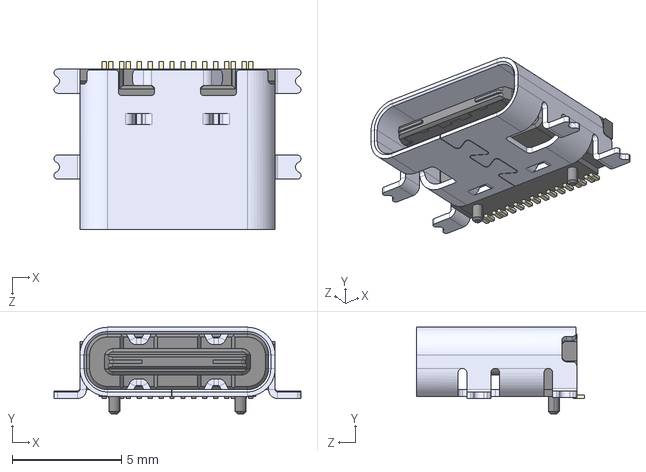
[picture p115: CAD file, 2024-04-17]
3d/t_USB/USB4110-GF-A.STEP
11.3 x 3.96 x 7.68 mm
