xdmattz/kicad-library/3d/t_coilcraft/Coilcraft-0908SQ-25N.stp

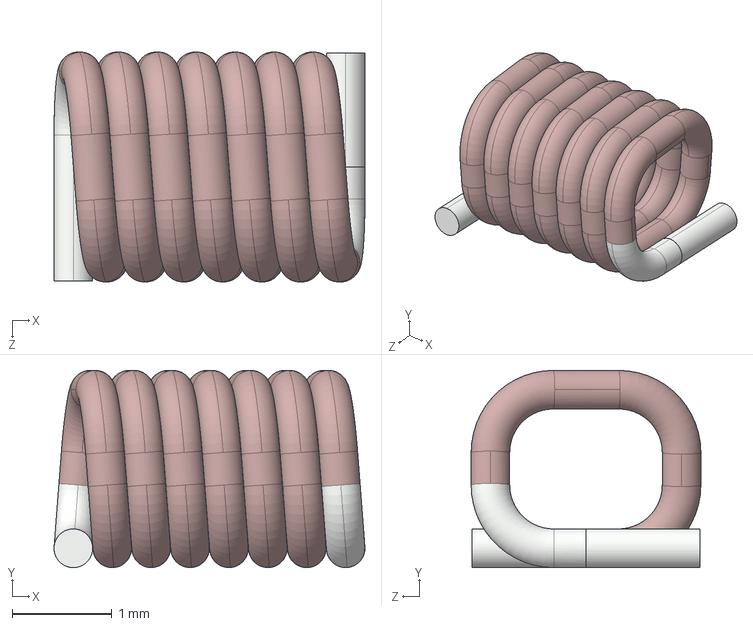
[picture p116: CAD file, 2024-04-17]
3d/t_coilcraft/Coilcraft-0908SQ-25N.stp
3.12 x 1.98 x 2.31 mm
