xdmattz/kicad-library/3d/t_connectors/6STD09SAT99S40X.step

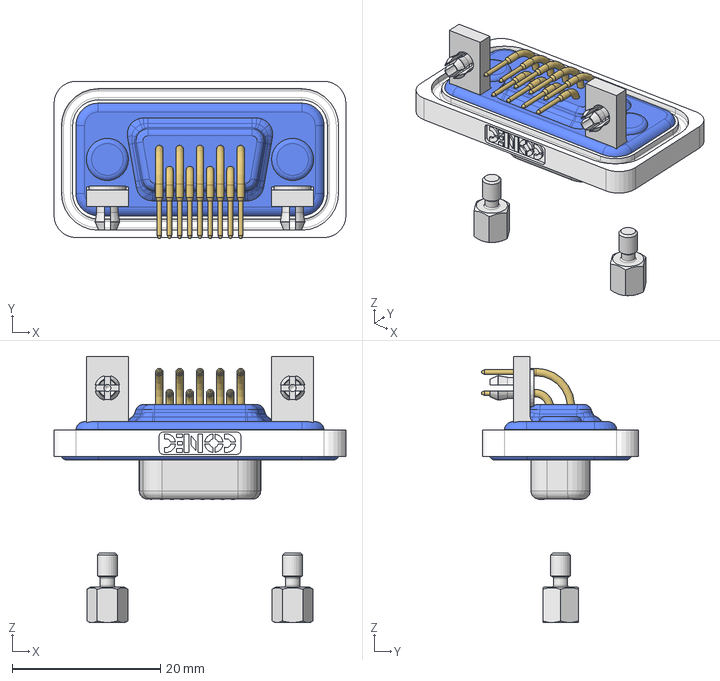
[picture p117: CAD file, 2024-04-17]
3d/t_connectors/6STD09SAT99S40X.step
39.4 x 21.3 x 35.9 mm
