xdmattz/kicad-library/3d/t_header/1.27mm/DS1031-01-1x3P8BV2-1.stp

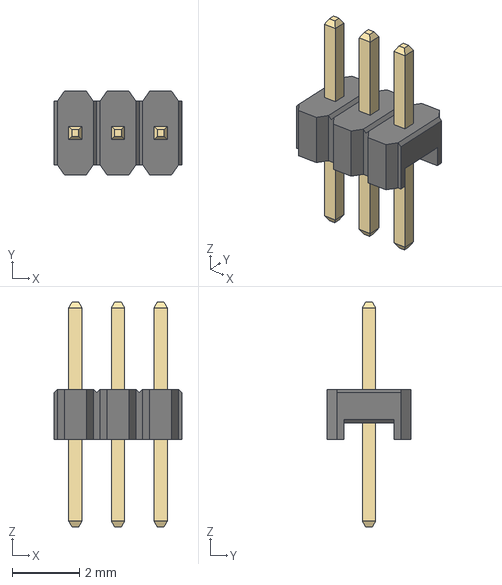
[picture p118: CAD file, 2024-04-17]
3d/t_header/1.27mm/DS1031-01-1x3P8BV2-1.stp
3.81 x 2.50 x 6.70 mm
