xdmattz/kicad-library/3d/t_header/2.54mm/DS1021-1x10SF11.stp

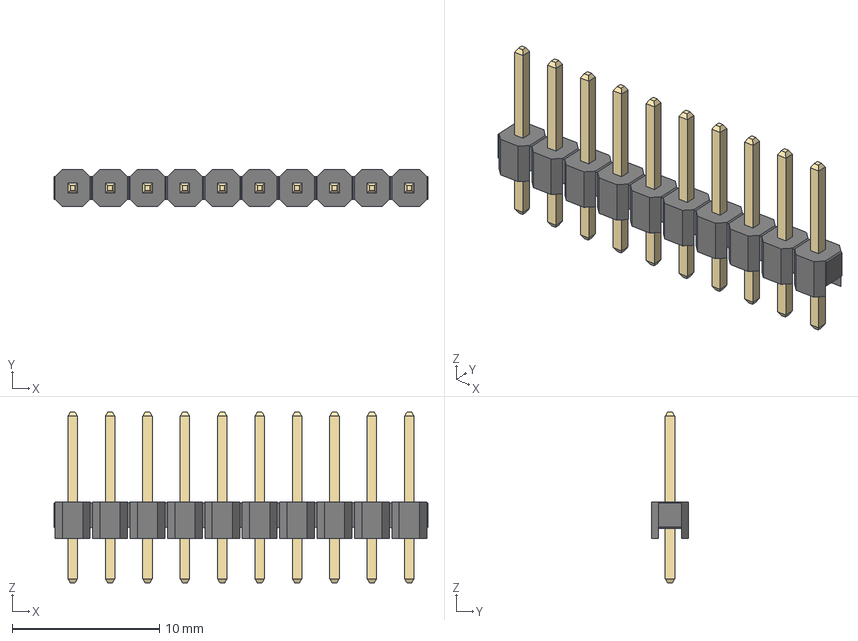
[picture p119: CAD file, 2024-04-17]
3d/t_header/2.54mm/DS1021-1x10SF11.stp
25.4 x 2.54 x 11.6 mm
