xdmattz/kicad-library/3d/t_misc/res_1206.stp

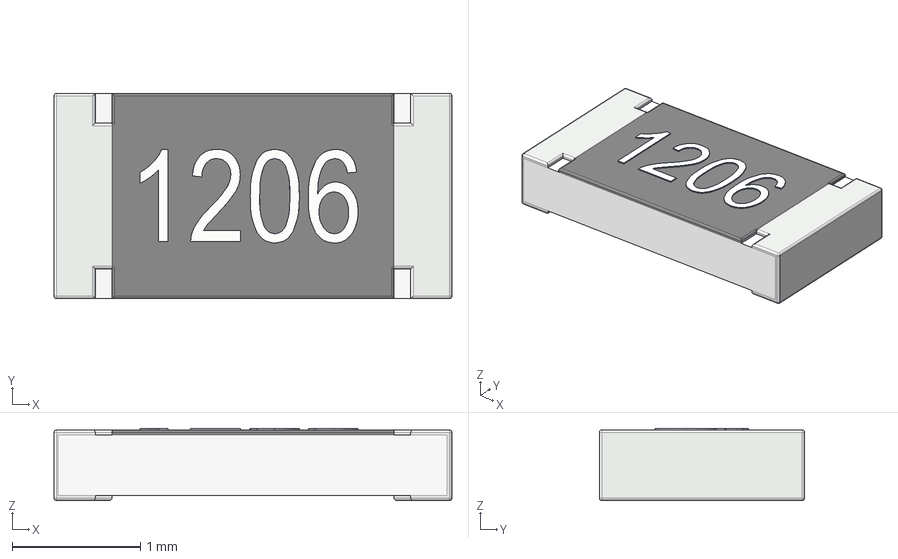
[picture p120: CAD file, 2024-04-17]
3d/t_misc/res_1206.stp
3.10 x 1.60 x 0.561 mm
