xdmattz/kicad-library/3d/t_passive_smd/RESC-1218.stp

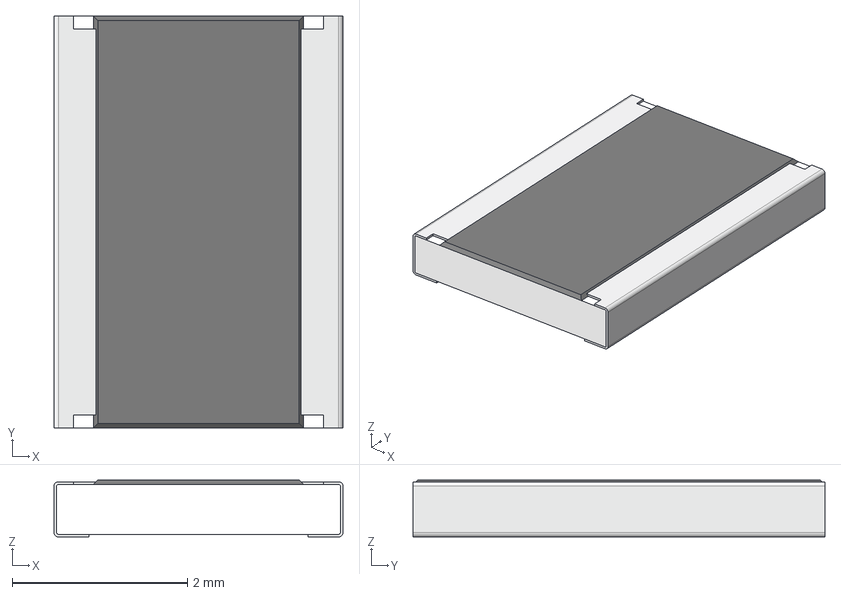
[picture p121: CAD file, 2024-04-17]
3d/t_passive_smd/RESC-1218.stp
3.30 x 4.70 x 0.65 mm
