xdmattz/kicad-library/3d/t_passive_thd/CAP_Rad_13x6mm.stp

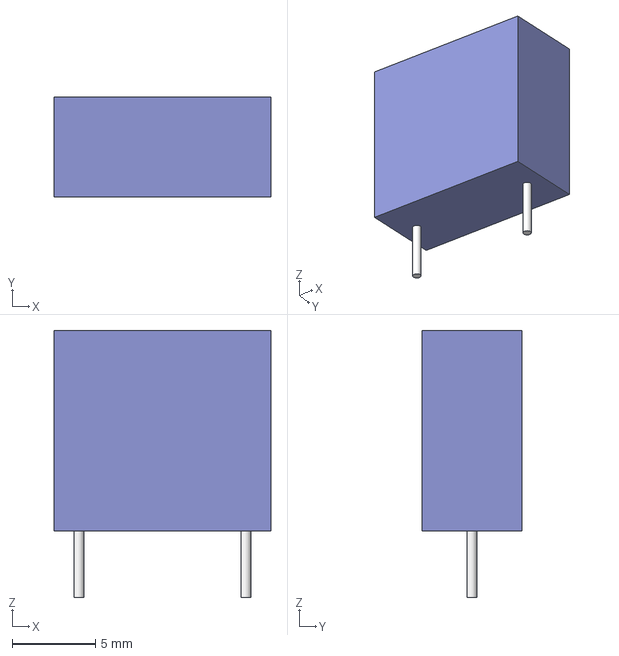
[picture p122: CAD file, 2024-04-17]
3d/t_passive_thd/CAP_Rad_13x6mm.stp
13.0 x 6.00 x 16.0 mm
Pins
