xdmattz/kicad-library/3d/t_qfn/QFN48-1.STEP

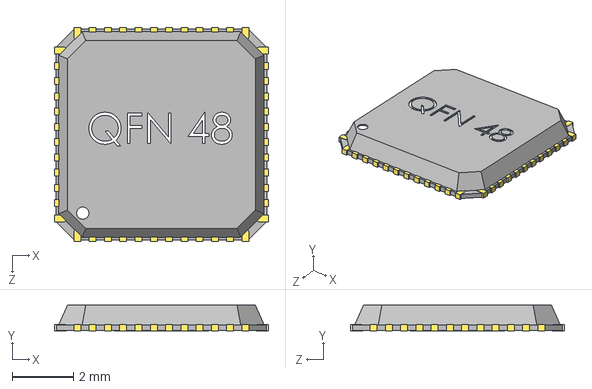
[picture p123: CAD file, 2024-04-17]
3d/t_qfn/QFN48-1.STEP
7.00 x 0.85 x 7.01 mm
User Library-QFN48-1_Body
User Library-QFN48-1_Pins
