xdmattz/kicad-library/3d/t_RF_misc/DC2337.stp

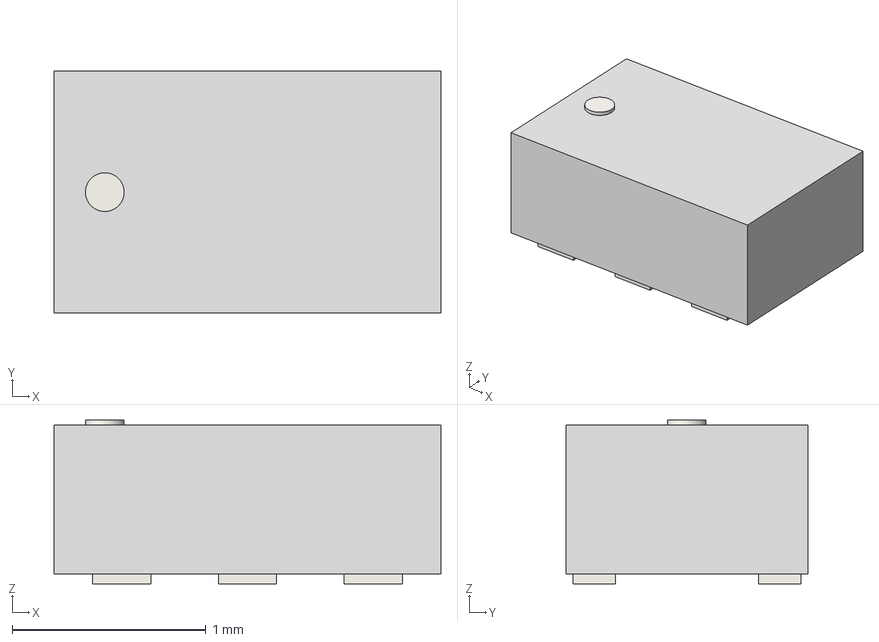
[picture p124: CAD file, 2024-04-17]
3d/t_RF_misc/DC2337.stp
2.00 x 1.25 x 0.845 mm
