xdmattz/kicad-library/3d/t_smd_caps/CP_Elec_10x7.7.step

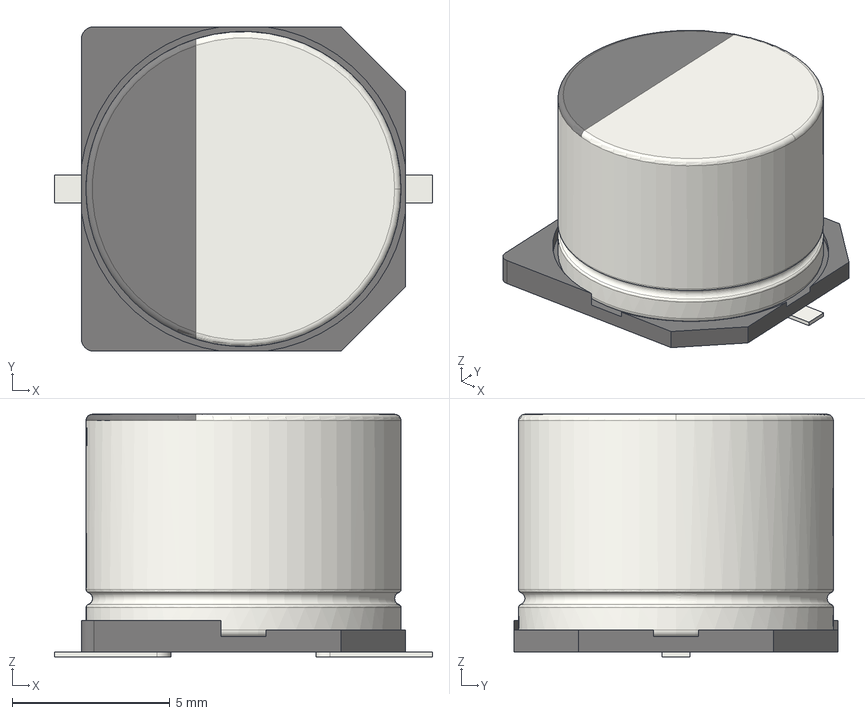
[picture p125: CAD file, 2024-04-17]
3d/t_smd_caps/CP_Elec_10x7.7.step
12.0 x 10.3 x 7.70 mm
