xdmattz/kicad-library/3d/t_smd_inductors/Q3SMT_430.step

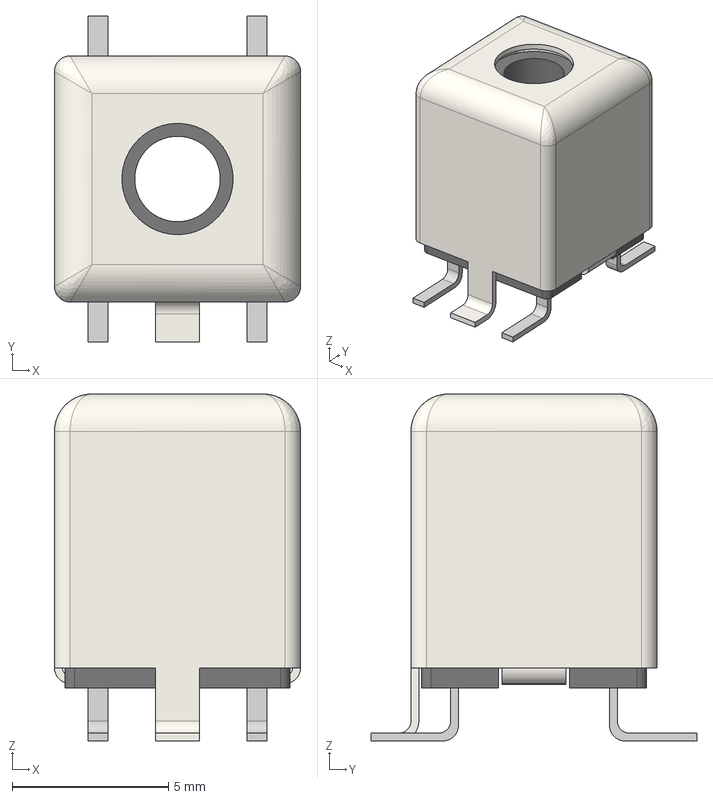
[picture p126: CAD file, 2024-04-17]
3d/t_smd_inductors/Q3SMT_430.step
7.87 x 10.4 x 11.1 mm
