xdmattz/kicad-library/3d/t_smd_transistors/SOT-963.step

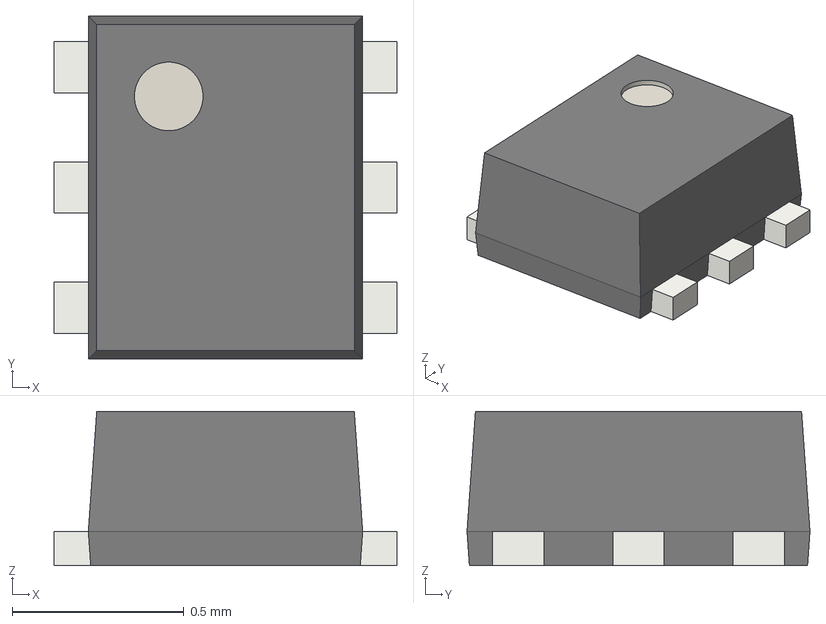
[picture p127: CAD file, 2024-04-17]
3d/t_smd_transistors/SOT-963.step
1.00 x 1.00 x 0.45 mm
