xdmattz/kicad-library/3d/t_so/TSSOP-24.stp

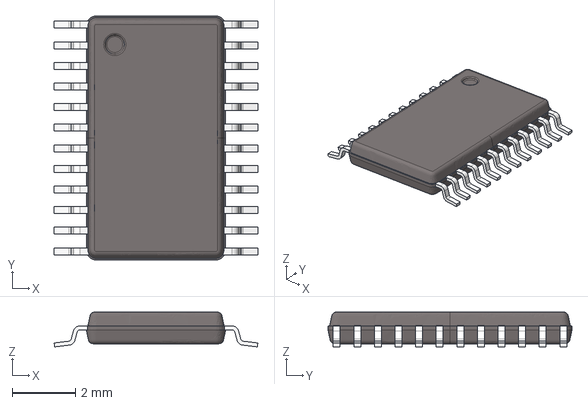
[picture p128: CAD file, 2024-04-17]
3d/t_so/TSSOP-24.stp
6.43 x 7.70 x 1.10 mm
