xdmattz/kicad-library/3d/t_sot/D_SOD-323F.step

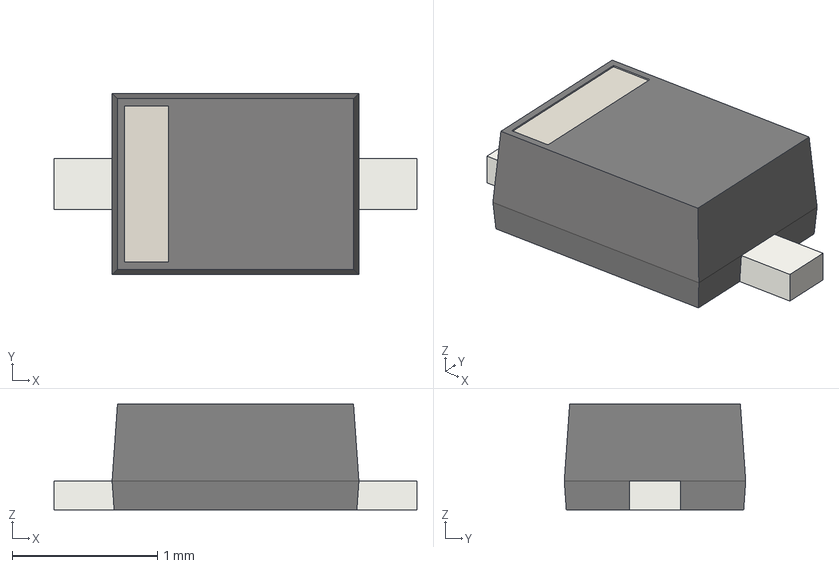
[picture p129: CAD file, 2024-04-17]
3d/t_sot/D_SOD-323F.step
2.50 x 1.25 x 0.73 mm
