xdmattz/kicad-library/3d/t_txfmr/STEP-750370040-rev1.stp

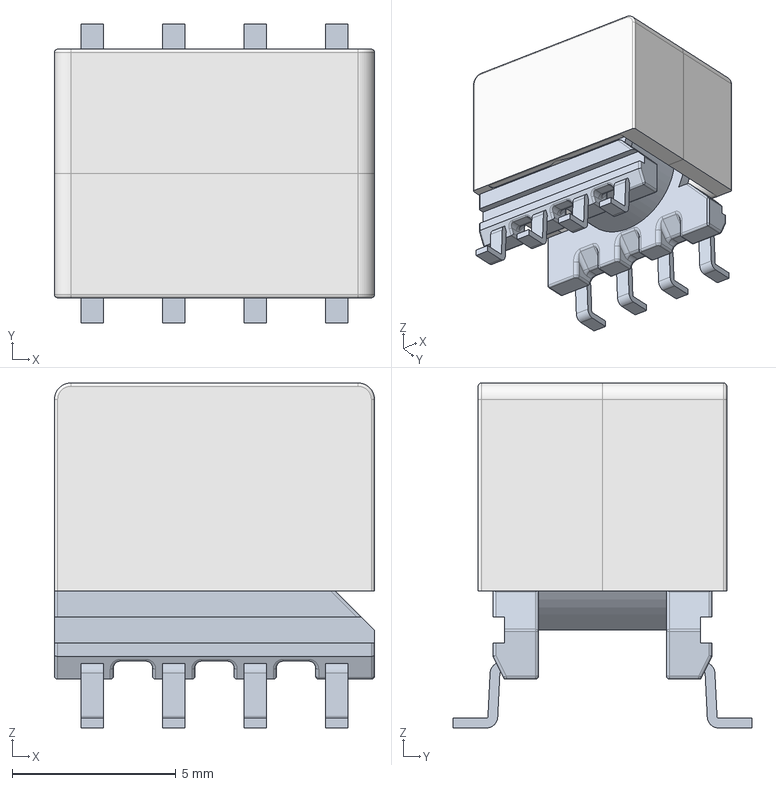
[picture p130: CAD file, 2024-04-17]
3d/t_txfmr/STEP-750370040-rev1.stp
9.78 x 9.14 x 10.5 mm
