xdmattz/kicad-library/3d/t_coilcraft/Coilcraft-1812CS.STEP

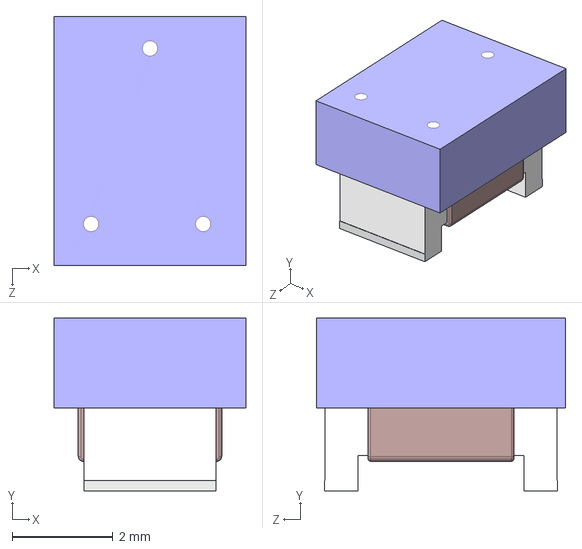
[picture p131: CAD file, 2024-04-17]
3d/t_coilcraft/Coilcraft-1812CS.STEP
3.81 x 3.43 x 4.95 mm
