xdmattz/kicad-library/3d/t_connectors/ZX20-B-5S-UNIT.stp

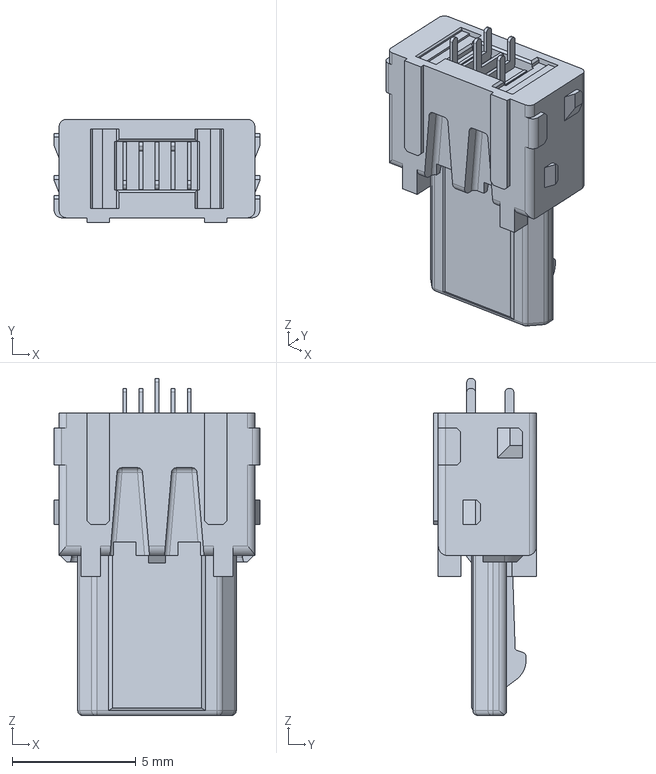
[picture p132: CAD file, 2024-04-17]
3d/t_connectors/ZX20-B-5S-UNIT.stp
8.30 x 4.18 x 13.6 mm
