xdmattz/kicad-library/3d/t_header/1.27mm/DS1031-01-1x2P8BV3-1.stp

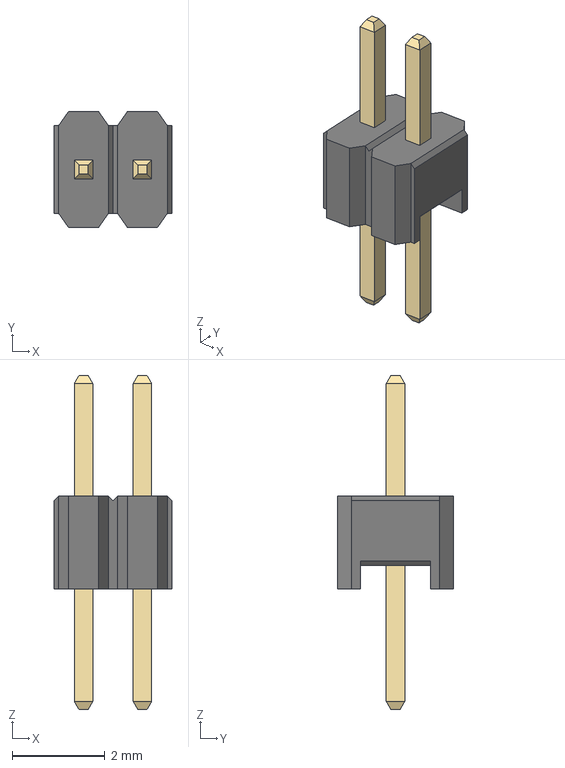
[picture p133: CAD file, 2024-04-17]
3d/t_header/1.27mm/DS1031-01-1x2P8BV3-1.stp
2.54 x 2.50 x 7.20 mm
