xdmattz/kicad-library/3d/t_header/2.54mm/DS1021-2x3S61.stp

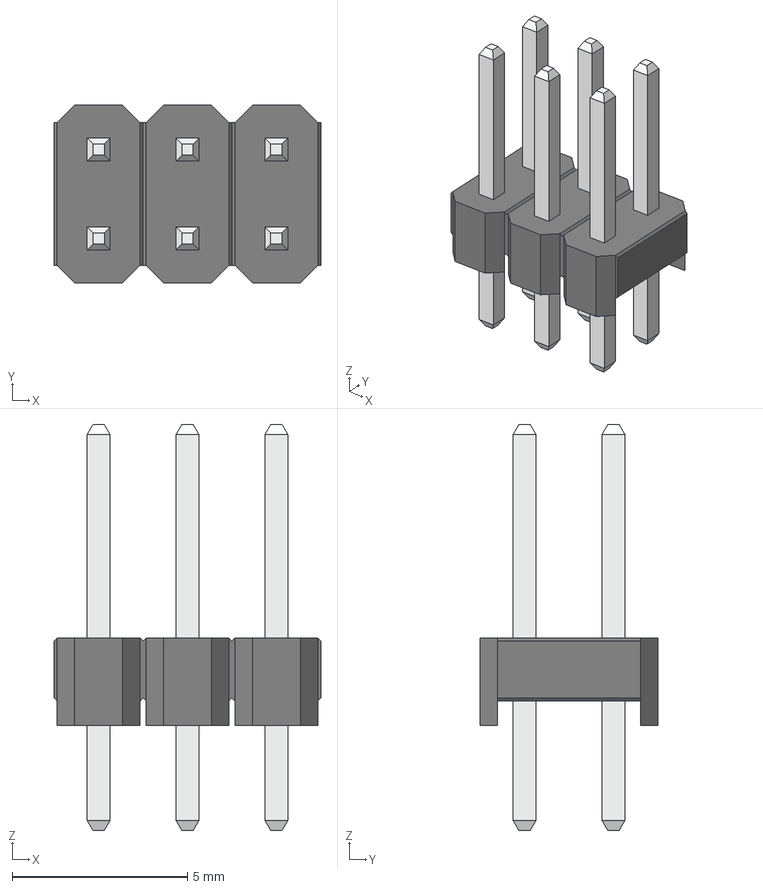
[picture p134: CAD file, 2024-04-17]
3d/t_header/2.54mm/DS1021-2x3S61.stp
7.62 x 5.08 x 11.6 mm
