xdmattz/kicad-library/3d/t_misc/ML-1220-F1AN.stp

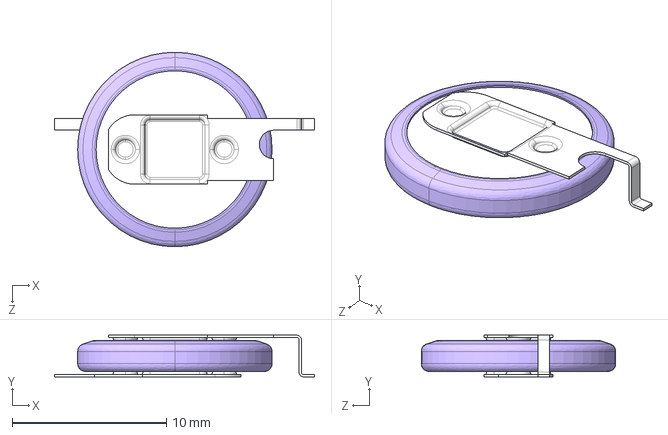
[picture p135: CAD file, 2024-04-17]
3d/t_misc/ML-1220-F1AN.stp
16.9 x 2.70 x 12.6 mm
