xdmattz/kicad-library/3d/t_passive_smd/CAPC-0805-T0.7-BN.stp

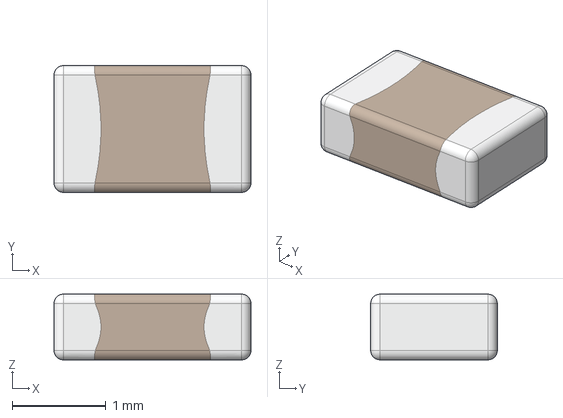
[picture p136: CAD file, 2024-04-17]
3d/t_passive_smd/CAPC-0805-T0.7-BN.stp
2.10 x 1.35 x 0.7 mm
