xdmattz/kicad-library/3d/t_passive_thd/RES-0.5W-H-MF.stp

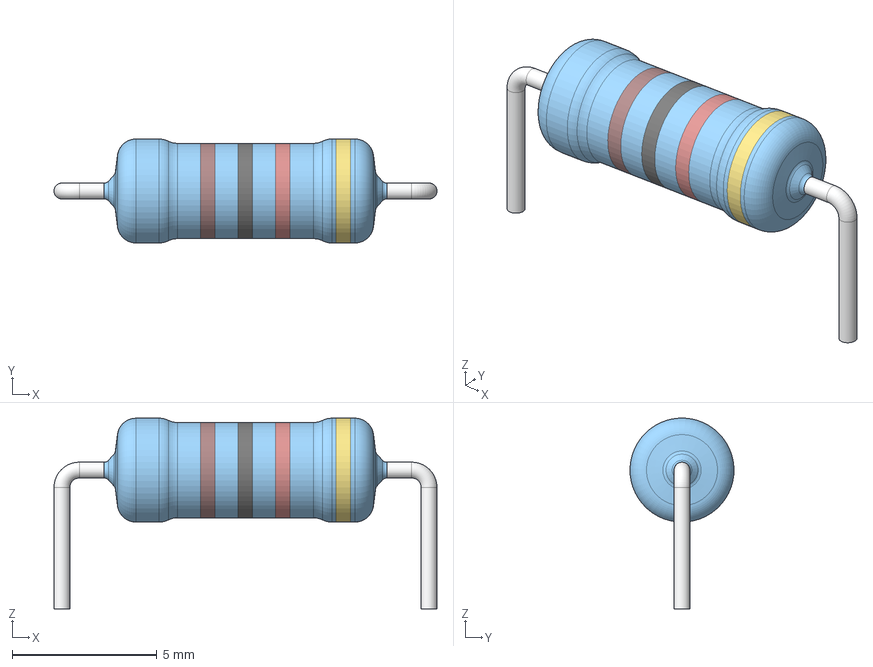
[picture p137: CAD file, 2024-04-17]
3d/t_passive_thd/RES-0.5W-H-MF.stp
13.2 x 3.60 x 6.60 mm
