xdmattz/kicad-library/3d/t_Phoenix/Terminal Block Vertical_2.step

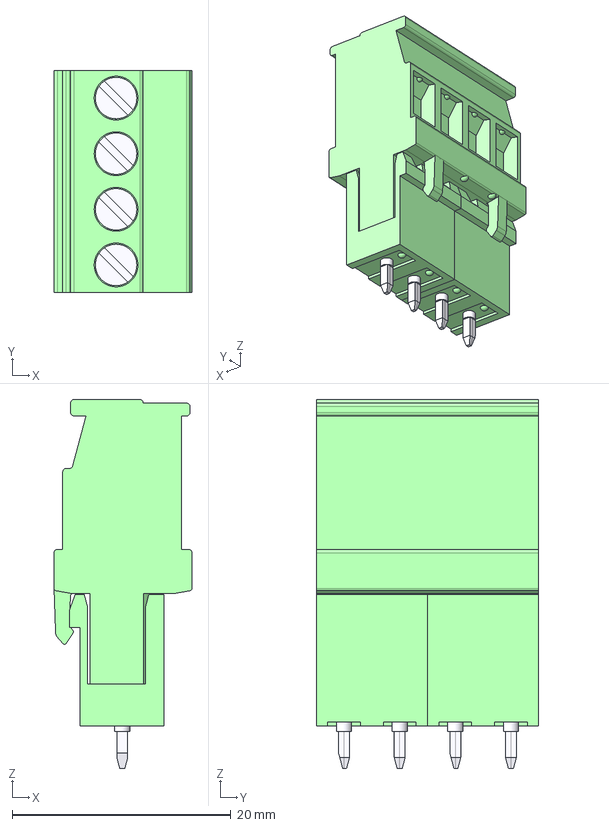
[picture p138: CAD file, 2024-04-17]
3d/t_Phoenix/Terminal Block Vertical_2.step
12.6 x 20.3 x 33.7 mm
mstbv_2.5-2-g-5
mstbv_2.5-2-g-5 (1)
mvstbr_2.5-4-st-5
