xdmattz/kicad-library/3d/t_qfn/QFP50P2200X2200X160-144N LQFP-144.stp

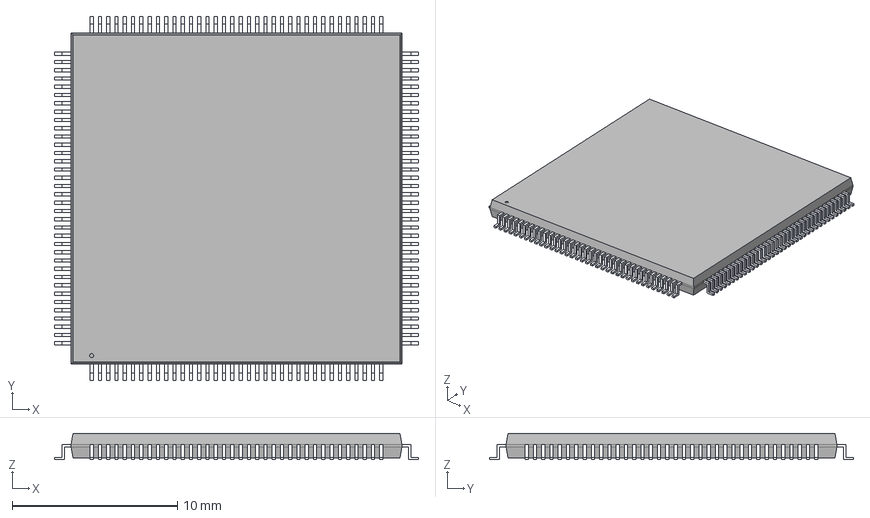
[picture p139: CAD file, 2024-04-17]
3d/t_qfn/QFP50P2200X2200X160-144N LQFP-144.stp
22.0 x 22.0 x 1.60 mm
