xdmattz/kicad-library/3d/t_RF_misc/HHM-4_1P0X0P5.stp

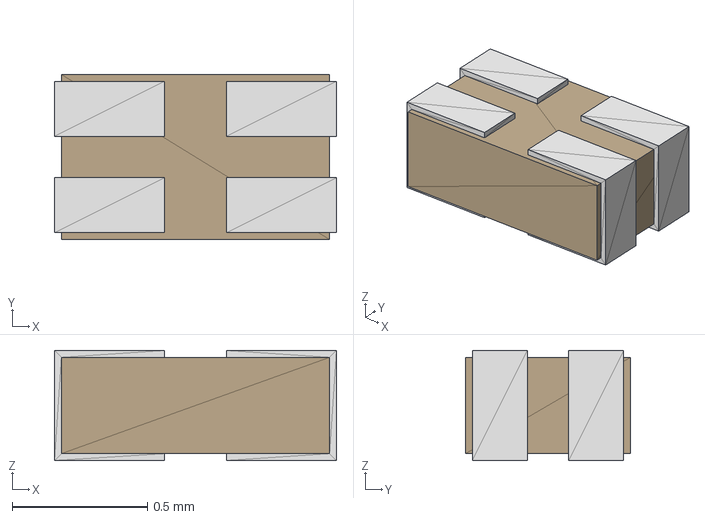
[picture p140: CAD file, 2024-04-17]
3d/t_RF_misc/HHM-4_1P0X0P5.stp
1.04 x 0.61 x 0.406 mm
