xdmattz/kicad-library/3d/t_smd_caps/CP_Elec_6.3x5.7.step

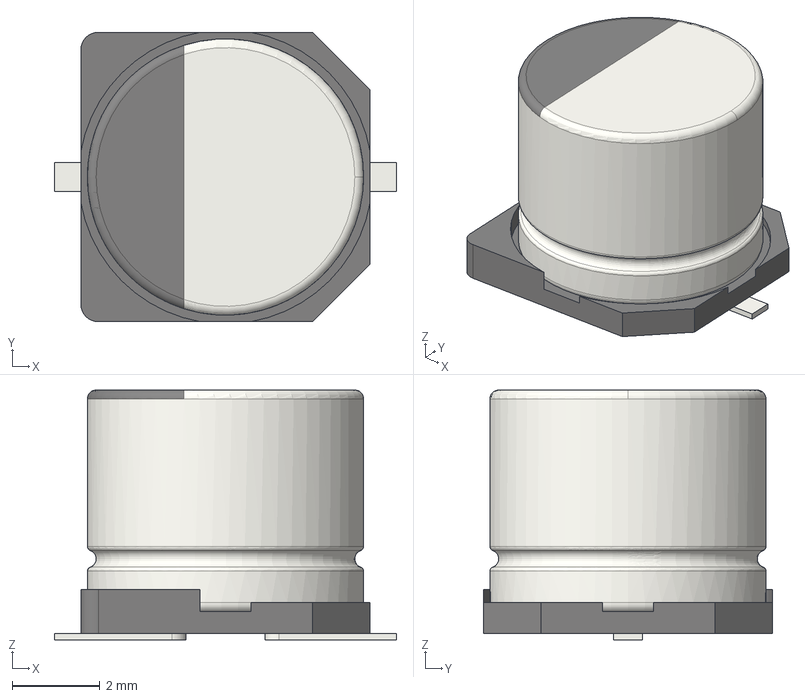
[picture p141: CAD file, 2024-04-17]
3d/t_smd_caps/CP_Elec_6.3x5.7.step
7.80 x 6.60 x 5.70 mm
