xdmattz/kicad-library/3d/t_smd_transistors/TO-277A.stp

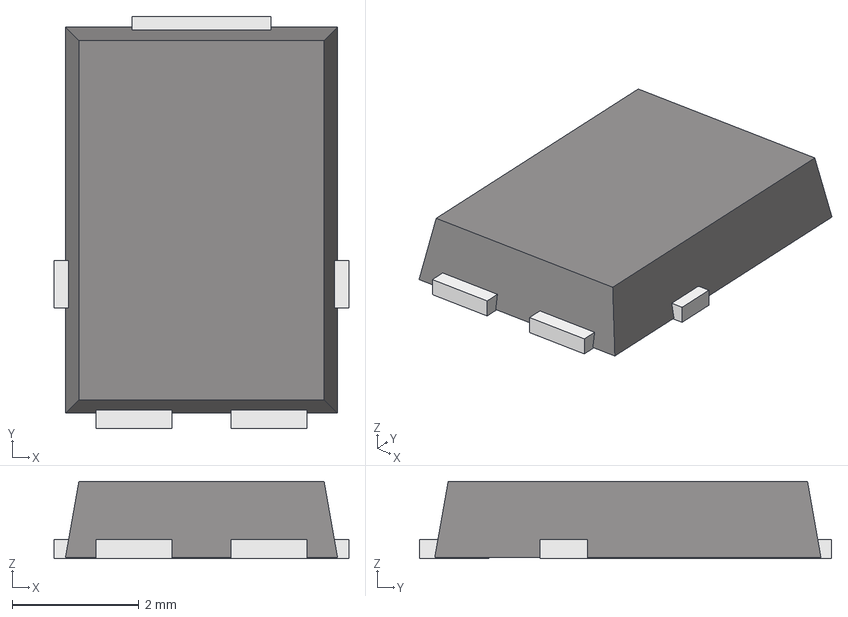
[picture p142: CAD file, 2024-04-17]
3d/t_smd_transistors/TO-277A.stp
4.65 x 6.50 x 1.22 mm
