xdmattz/kicad-library/(list of files, cad)

Other CAD files:
3d/t_Phoenix/Terminal Block RA_Socket_4.step
3d/t_to/TO-247_horizontal_back_triangle_mid.stp
3d/t_Mech_Switch/OS102011MA1QN1.stp
3d/t_Phoenix/Terminal Block RA_4.step
3d/t_Phoenix/Terminal Block Vert 4.step
3d/t_Phoenix/Terminal Block Vertical_4.step
3d/t_Phoenix/Terminal_Block_Ver_Top_4.step
3d/t_RF_misc/B8831.stp
3d/t_RF_misc/DEA-6_1P6X0P8.stp
3d/t_RF_misc/HHM-4_1P0X0P5-L.stp
3d/t_RF_misc/HHM-4_1P0X0P5-M.stp
3d/t_TCI_battery/2600236.stp
3d/t_TCI_battery/2600237.stp
3d/t_TCI_battery/2600378-1.stp
3d/t_TCI_battery/91320-001_in_4102600_tape.stp
3d/t_USB/10118192-002lfc.stp
3d/t_USB/12402012E212A.step
3d/t_coilcraft/Coilcraft-0402CS.stp
3d/t_coilcraft/Coilcraft-0402PA.stp
3d/t_coilcraft/Coilcraft-0603CS.stp
3d/t_coilcraft/Coilcraft-0805CS.stp
3d/t_coilcraft/Coilcraft-0806SQ-16N.stp
3d/t_coilcraft/Coilcraft-0806SQ-19N.stp
3d/t_coilcraft/Coilcraft-0806SQ-6N0.stp
3d/t_coilcraft/Coilcraft-0806SQ-8N9.stp
3d/t_coilcraft/Coilcraft-0908SQ-14N.stp
3d/t_coilcraft/Coilcraft-0908SQ-22N.stp
3d/t_coilcraft/Coilcraft-0908SQ-8N1.stp
3d/t_coilcraft/Coilcraft-1008CS.STEP
3d/t_coilcraft/Coilcraft-1008CS.stp
3d/t_coilcraft/Coilcraft-132-10SML-DEFAULT.stp
3d/t_coilcraft/Coilcraft-1512SP-XXX.STEP
3d/t_coilcraft/Coilcraft-1515SQ-47N.STEP
3d/t_coilcraft/Coilcraft-1812FS.STEP
3d/t_coilcraft/Coilcraft-1812SMS-27N.STEP
3d/t_coilcraft/Coilcraft-1812SMS-47N.stp
3d/t_coilcraft/Coilcraft-2222SQ-161.STEP
3d/t_coilcraft/Coilcraft-4310LC.stp
3d/t_coilcraft/Coilcraft-CST1.stp
3d/t_coilcraft/Coilcraft-DA2303-AL.stp
3d/t_coilcraft/Coilcraft-DA2317-AL-DEFAULT.stp
3d/t_coilcraft/Coilcraft-DA2383-AL-DEFAULT.stp
3d/t_coilcraft/Coilcraft-MSD1514.STEP
3d/t_coilcraft/Coilcraft-MSD7342.step
3d/t_coilcraft/Coilcraft-PFD2015.STEP
3d/t_coilcraft/Coilcraft-POE13P-12L.stp
3d/t_coilcraft/Coilcraft-POE13P-33L-DEFAULT.stp
3d/t_coilcraft/Coilcraft-SER1052.STEP
3d/t_coilcraft/Coilcraft-SER2915L.STEP
3d/t_coilcraft/Coilcraft-XAL1010.stp
3d/t_coilcraft/Coilcraft-XAL1510-153.stp
3d/t_coilcraft/Coilcraft-XAL1513-153.stp
3d/t_coilcraft/Coilcraft-XAL4030.STEP
3d/t_coilcraft/Coilcraft-XAL5030.stp
3d/t_coilcraft/Coilcraft-XAL5050.stp
3d/t_coilcraft/Coilcraft-XAL6030.stp
3d/t_coilcraft/Coilcraft-XAL6060.stp
3d/t_coilcraft/Coilcraft-XAL7070.stp
3d/t_coilcraft/Coilcraft-XAL8080.stp
3d/t_coilcraft/Coilcraft-XEL4020.STEP
3d/t_coilcraft/Coilcraft-XFL3012.STEP
3d/t_coilcraft/EP10_SM.stp
3d/t_coilcraft/LPS3015.stp
3d/t_coilcraft/User Library-1008CS.stp
3d/t_coilcraft/User Library-XAL7030-472.stp
3d/t_coilcraft/User Library-XAL7030-682.stp
3d/t_connectors/022112042.stp
3d/t_connectors/022112052.stp
3d/t_connectors/12401880.stp
3d/t_connectors/17544-78_81.step
3d/t_connectors/1757242_06.stp
3d/t_connectors/1803426.stp
3d/t_connectors/1827127_04.stp
3d/t_connectors/480372200.stp
3d/t_connectors/5051101092.stp
3d/t_connectors/527450497.stp
3d/t_connectors/54-00164.step
3d/t_connectors/543630389.stp
3d/t_connectors/54602-908LFc.stp
3d/t_connectors/556500388.stp
3d/t_connectors/6STD09PAT99S10X.stp
3d/t_connectors/929648-01-04.STEP
3d/t_connectors/929648-05-04.STEP
3d/t_connectors/BM25-4P.stp
3d/t_connectors/BM25-4S.stp
3d/t_connectors/C003DBAN-M71RCa.stp
3d/t_connectors/C051LGBN-RCa.stp
3d/t_connectors/CLM-103-02-L-D.stp
3d/t_connectors/CON18_2X9_DU_CLM_SAI.step
3d/t_connectors/DALTRON_BLACK.STEP
3d/t_connectors/DB25_F_Solder_A.stp
3d/t_connectors/DELTRON_BLACK.STEP
3d/t_connectors/DELTRON_BLUE.STEP
3d/t_connectors/DELTRON_GREEN.STEP
3d/t_connectors/DELTRON_RED.STEP
3d/t_connectors/DELTRON_YELLOW.STEP
3d/t_connectors/DF40C(2.0)-80DS.stp
3d/t_connectors/DF40C-80DP-0.4V(51).stp
3d/t_connectors/DF52-6S-0.8H.stp
3d/t_connectors/FH12-10S-0.5SH.stp
3d/t_connectors/FH12-28S-0.5SH.stp
3d/t_connectors/FH34SRJ-20S-0.5SH.stp
3d/t_connectors/FTMH-109-03-F-DV.step
3d/t_connectors/FX6A-40P-0.8SV.stp
3d/t_connectors/Hirose- DF40C-80DP-0.4V(51).stp
3d/t_connectors/M-MUSB-C111-30-REVT4.STEP
3d/t_connectors/M-MUSB-K152-30-REVT3.STEP
3d/t_connectors/User Library-pec11r-4x20k-sxxxx.STEP
3d/t_connectors/ZX20-B-5S.stp
3d/t_connectors/ZX60-B-5S.stp
3d/t_connectors/c-5-102202-1-p-3d.stp
3d/t_connectors/c-5-103168-3-m-3d.stp
3d/t_connectors/c-5749767-1-d-3d.stp
3d/t_connectors/c-826634-3-n-3d.stp
3d/t_connectors/gw1yar-p16ud00-r00l.stp
3d/t_header/1.27mm/20021521-00010T1LF.step
3d/t_header/1.27mm/DS1031-01-1x10P8BV2-1.stp
3d/t_header/1.27mm/DS1031-01-1x10P8BV3-1.stp
3d/t_header/1.27mm/DS1031-01-1x1P8BV2-1.stp
3d/t_header/1.27mm/DS1031-01-1x1P8BV3-1.stp
3d/t_header/1.27mm/DS1031-01-1x2P8BV2-1.stp
3d/t_header/1.27mm/DS1031-01-1x4P8BV2-1.stp
3d/t_header/1.27mm/DS1031-01-1x5P8BV3-1.stp
3d/t_header/1.27mm/DS1031-01-1x6P8BV2-1.stp
3d/t_header/1.27mm/DS1031-01-1x7P8BV2-1.stp
3d/t_header/1.27mm/DS1031-01-1x7P8BV3-1.stp
3d/t_header/1.27mm/DS1031-01-1x8P8BV2-1.stp
3d/t_header/1.27mm/DS1031-01-1x9P8BV2-1.stp
3d/t_header/1.27mm/DS1031-01-1x9P8BV3-1.stp
3d/t_header/2.54mm/DS1013-10RSiB.stp
3d/t_header/2.54mm/DS1013-10SSiB.stp
3d/t_header/2.54mm/DS1013-12RSiB.stp
3d/t_header/2.54mm/DS1013-12SSiB.stp
3d/t_header/2.54mm/DS1013-14RSiB.stp
3d/t_header/2.54mm/DS1013-14SSiB.stp
3d/t_header/2.54mm/DS1013-16RSiB.stp
3d/t_header/2.54mm/DS1013-16SSiB.stp
3d/t_header/2.54mm/DS1013-20RSiB.stp
3d/t_header/2.54mm/DS1013-20SSiB.stp
3d/t_header/2.54mm/DS1021-1x10S61.stp
3d/t_header/2.54mm/DS1021-1x1S61.stp
3d/t_header/2.54mm/DS1021-1x1SF11.stp
3d/t_header/2.54mm/DS1021-1x2S61.stp
3d/t_header/2.54mm/DS1021-1x2SF11.stp
3d/t_header/2.54mm/DS1021-1x3S61.stp
3d/t_header/2.54mm/DS1021-1x3SF11.stp
3d/t_header/2.54mm/DS1021-1x4S61.stp
3d/t_header/2.54mm/DS1021-1x4SF11.stp
3d/t_header/2.54mm/DS1021-1x5S61.stp
3d/t_header/2.54mm/DS1021-1x5SF11.stp
3d/t_header/2.54mm/DS1021-1x6S61.stp
3d/t_header/2.54mm/DS1021-1x6SF11.stp
3d/t_header/2.54mm/DS1021-1x7S61.stp
3d/t_header/2.54mm/DS1021-1x7SF11.stp
3d/t_header/2.54mm/DS1021-1x8S61.stp
3d/t_header/2.54mm/DS1021-1x8SF11.stp
3d/t_header/2.54mm/DS1021-1x9S61.stp
3d/t_header/2.54mm/DS1021-1x9SF11.stp
3d/t_header/2.54mm/DS1021-2x10S61.stp
3d/t_header/2.54mm/DS1021-2x10SF11.stp
3d/t_header/2.54mm/DS1021-2x1S61.stp
3d/t_header/2.54mm/DS1021-2x1SF11.stp
3d/t_header/2.54mm/DS1021-2x2S61.stp
3d/t_header/2.54mm/DS1021-2x2SF11.stp
3d/t_header/2.54mm/DS1021-2x3SF11.stp
3d/t_header/2.54mm/DS1021-2x4SF11.stp
3d/t_header/2.54mm/DS1021-2x5S61.stp
3d/t_header/2.54mm/DS1021-2x5SF11.stp
3d/t_header/2.54mm/DS1021-2x6S61.stp
3d/t_header/2.54mm/DS1021-2x6SF11.stp
3d/t_header/2.54mm/DS1021-2x7S61.stp
3d/t_header/2.54mm/DS1021-2x7SF11.stp
3d/t_header/2.54mm/DS1021-2x8S61.stp
3d/t_header/2.54mm/DS1021-2x8SF11.stp
3d/t_header/2.54mm/DS1021-2x9S61.stp
3d/t_header/2.54mm/DS1021-2x9SF11.stp
3d/t_header/2.54mm/DS1022-1x10RD61.stp
3d/t_header/2.54mm/DS1022-1x10RDF11.stp
3d/t_header/2.54mm/DS1022-1x1RD61.stp
3d/t_header/2.54mm/DS1022-1x1RDF11.stp
3d/t_header/2.54mm/DS1022-1x2RD61.stp
3d/t_header/2.54mm/DS1022-1x2RDF11.stp
3d/t_header/2.54mm/DS1022-1x3RD61.stp
3d/t_header/2.54mm/DS1022-1x3RDF11.stp
3d/t_header/2.54mm/DS1022-1x4RD61.stp
3d/t_header/2.54mm/DS1022-1x4RDF11.stp
3d/t_header/2.54mm/DS1022-1x5RD61.stp
3d/t_header/2.54mm/DS1022-1x5RDF11.stp
3d/t_header/2.54mm/DS1022-1x6RD61.stp
3d/t_header/2.54mm/DS1022-1x6RDF11.stp
3d/t_header/2.54mm/DS1022-1x7RD61.stp
3d/t_header/2.54mm/DS1022-1x7RDF11.stp
3d/t_header/2.54mm/DS1022-1x8RD61.stp
3d/t_header/2.54mm/DS1022-1x8RDF11.stp
3d/t_header/2.54mm/DS1022-1x9RD61.stp
3d/t_header/2.54mm/DS1022-1x9RDF11.stp
3d/t_header/2.54mm/DS1022-2x10R61.stp
3d/t_header/2.54mm/DS1022-2x10RF11.stp
3d/t_header/2.54mm/DS1022-2x2R61.stp
3d/t_header/2.54mm/DS1022-2x3R61.stp
3d/t_header/2.54mm/DS1022-2x3RF11.stp
3d/t_header/2.54mm/DS1022-2x4R61.stp
3d/t_header/2.54mm/DS1022-2x4RF11.stp
3d/t_header/2.54mm/DS1022-2x5R61.stp
3d/t_header/2.54mm/DS1022-2x5RF11.stp
3d/t_header/2.54mm/DS1022-2x6RF11.stp
3d/t_header/2.54mm/DS1022-2x7R61.stp
3d/t_header/2.54mm/DS1022-2x7RF11.stp
3d/t_header/2.54mm/DS1022-2x8R61.stp
3d/t_header/2.54mm/DS1022-2x8RF11.stp
3d/t_header/2.54mm/DS1022-2x9R61.stp
3d/t_header/2.54mm/DS1022-2x9RF11.stp
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
